Tommy270502/PM4/1_Radar Theorie/1_CW-Doppler-Radar/PM4 FS2026 CW-Doppler-Radar Design V1.0.pptx

PM4 FS2026: CW-Doppler-Radar Sensor

Project Goals
Design a radar sensor
start with a standard use case (see below)
and/or an idea of your own
document your HW/DSP-concept
Realize your prototype
Hardware
Firmware/Software
Test the performance of your prototype
Document and present your prototype

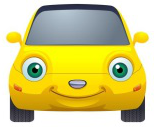
[picture p5: figure]

v
radial
velocity

range R

radar sensor
K-LC5

radar sensor
K-LC5

## Slide 2

References

General information can be simply found on Wikipedia (https://en.wikipedia.org/wiki/Radar):
Distance and Spead Measurement (https://en.wikipedia.org/wiki/Radar#Radar_signal_processing), Radar Range Equation (https://en.wikipedia.org/wiki/Radar#Radar_range_equation), …
Further technical information can be found on the Radar Tutorial (https://www.radartutorial.eu/):
Doppler-Effect (https://www.radartutorial.eu/11.coherent/co06.en.html) (see Figure 1 first)
CW-Doppler-Radar (https://www.radartutorial.eu/02.basics/Continuous%20Wave%20Radar.en.html)
(only sections Doppler Radar, Function, Block diagram of CW radar Figure 3)
Radar Range Equation (https://www.radartutorial.eu/01.basics/The%20Radar%20Range%20Equation.en.html)
Radar-Cross-Section (https://www.radartutorial.eu/01.basics/Radar%20Cross%20Section.en.html)
RFbeam, St. Gallen: https://www.rfbeam.ch/
use cases (https://rfbeam.ch/applications/)
Radar sensor used in PM4:
Radar Sensor K-LC5 (https://rfbeam.ch/product/k-lc5-radar-transceiver/), data sheet K-LC5 (https://rfbeam.ch/wp-content/uploads/dlm_uploads/2022/11/K-LC5_Datasheet.pdf)

## Slide 3

Some use cases

1. CW-Doppler-Radar: motion sensor
- for movement detection
- indoor automation
- intrusion alarm
challenge: human presence detection
2. CW-Doppler-Radar: speed sensor
- traffic monitoring
- sports (challenge: reflectivity of target)
3. FMCW-Radar: range sensor
- please see corresponding document
- range (i.e. distance) measurements
- more challenging than CW-Doppler-Radar

Source: https://rfbeam.ch/applications/

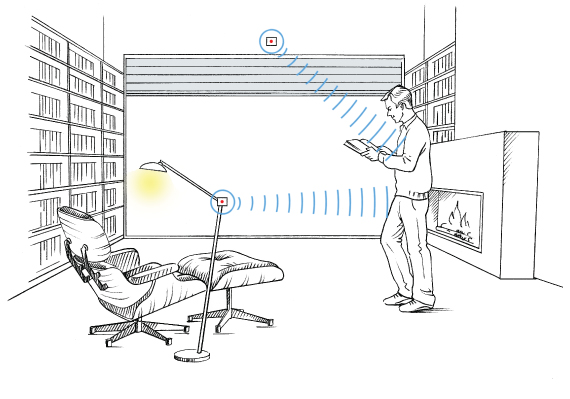
[picture p6: figure]

use case 1

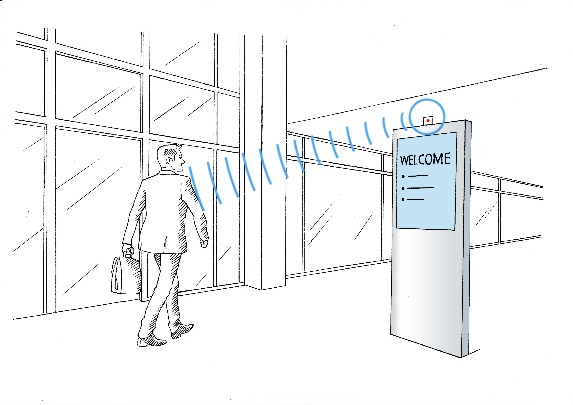
[picture p7: figure]

use case 1

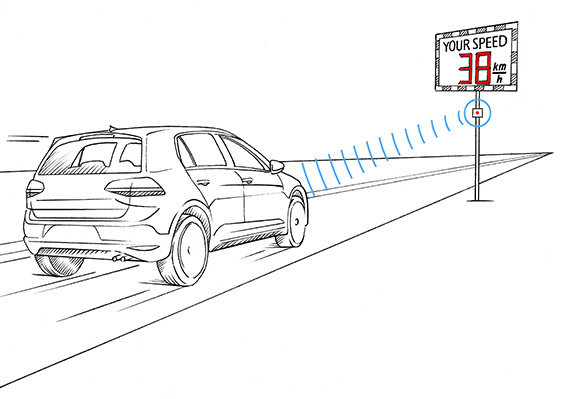
[picture p8: figure]

use case 2

## Slide 4

CW-Doppler-Radar: How it works

CW-Doppler-Radar (https://www.radartutorial.eu/02.basics/Continuous%20Wave%20Radar.en.html)

target

Doppler-Effect (https://www.radartutorial.eu/11.coherent/co06.en.html)
Doppler-frequency
wave length λ
c: speed of light (~ 3·10⁸ m/s)
fc: transmit frequency ( 24 GHz)

f_d =2∙v/λ= 2∙v∙(f_c)/c=2∙v∙ (24 GHz)/(3∙10^8 m/s)=v/(m/s) ∙160 Hz

v / (m/s) | v / (km/h) | fd / Hz
0.1 | 0.36 | 16
0.28 | 1 | 44.4
1 | 3.6 | 160
2.8 | 10 | 444
10 | 36 | 1600
28 | 100 | 4444

f_d =2∙v/λ

v
radial
velocity

λ=c/(f_c)

range R

x(t) = cos(2π·fc·t)

y(t) = A·cos(2π·(fc+fd)·t)

(in-phase signal) I(t) = A·cos(2π·fd·t-φ0)
=> I(t) = y(t)·cos(2π·fc·t) low-pass filtered

cos(2π·fc·t)

(quadrature-phase signal) Q(t) = A·sin(2π·fd·t-φ0)
=> Q(t) = y(t)·(-sin(2π·fc·t)) low-pass filtered

CW-Doppler-Radar: DC to set fc
(should be different to avoid interference between sensors)
FMCW-Radar: sawtooth
(DAC with reconstruction filter)

= fc

VCO: voltage controlled oscillator
LNA: Low Noise Amplifier

## Slide 5

Review of Fourier Theory

Frequency translation

x(t) = y(t) · ej2π^f^c·t ○-● X(f) = Y(f-fc)

multiplication with ej2π^f^c·t ○-● frequency translation with +fc (to the right)

cos(ωc·t) = (e^j·^ω^c·t + e-j·^ω^c·^t) / 2

Euler-formula:
Multiplication of the received signal y(t) with cos(2π·fc·t)
causes a frequency translation by ±fc (see the following spectra)

IY(f)I

fc - fDoppler

target moves away from the radar sensor (v<0)
and causes a negative Doppler frequency

f

-fc

+fc

fDoppler

-fc

fc

+fc

II(f)I

X

X

filtered

f

fc

## Slide 6

Exercise 1

Assume that the target moves towards the radar sensor (v>0)
and, thus, causes a positive Doppler frequency (fd>0)
In the following diagram, sketch the magnitude spectra
- IY(f)I of the reflected radar signal y(t) and
- II(f)I of the analog radar-sensor output signal I(t)

IY(f)I

f

II(f)I

fc

fd

fc

f

Please verify that the sign of the Doppler frequency fd and the velocity v and, hence,
the direction of the movement can not be distinguished if only 1 sensor output signal is used !

## Slide 7

FFT-based Doppler frequency detection

Review of FFT

The FFT transforms N samples in the time-period [0,…,NTs) into
N uniformly distributed (complex) spectral-values in the range [0,…,fs).

Spectrum of analog radar sensor output signal I(t)

II(f)I

X

fs/2

X

filtered

FFT-spectrum of the sampled radar sensor output signal I[n] = I(t=nTs)

fd

fc

f

(fs is the sampling frequency)

Zero-frequency component shifted to
center of spectrum (Matlab: fftshift)

FFT

II[m]I

fd

fs-fd

fftshift

-fd

fd

fs

f

f

fs/2

## Slide 8

Determination of movement direction

Multiplication with e-j2π^f^c·t ○-● frequency translation with -fc (to the left)

Euler: e^-j^φ = cos(φ) - j·sin(φ)

y(t)·e-j2π^f^c·t = y(t)·[ cos(2πfc·t) - j·sin(2πfc·t) ] = I(t) + j·Q(t)

e-j...

complex-valued signal Z(t)

IY(f)I

fc-fd

IZ(f)I

-fd

fc

f

filtered

X

-fc

-fc

fs/2

f

FFT-spectrum of the sampled radar-sensor output signal z[n] = I[n]+j·Q[n]

fc

IZ[m]I

IZ[m]I

FFT

fs-fd

fftshift

-fd

fs

f

fs/2

f

## Slide 9

Exercise 2

Assume that the target moves towards the radar sensor (v>0)
and, thus, causes a positive Doppler frequency (fd>0)
In the following diagram, sketch the magnitude spectra
- IY(f)I of the reflected radar signal y(t) and
- IZ(f)I of the analog radar sensor output signal z(t) = I(t)+j·Q(t)
- IZ[m]I of the sampled radar-sensor output signal z[n] = I[n]+jQ[n]

IY(f)I

f

IZ(f)I

fc

fs/2

fc

f

IZ[m]I

IZ[m]I

FFT

fftshift

fs

f

fs/2

f

## Slide 10

Exercise 3

Use the Matlab-program CW_Doppler_Radar_8kSps_160.m, read
the corresponding wave-file and determine the Doppler-frequency fd and
the resulting radial (Doppler-) velocity v. The result should look like this:

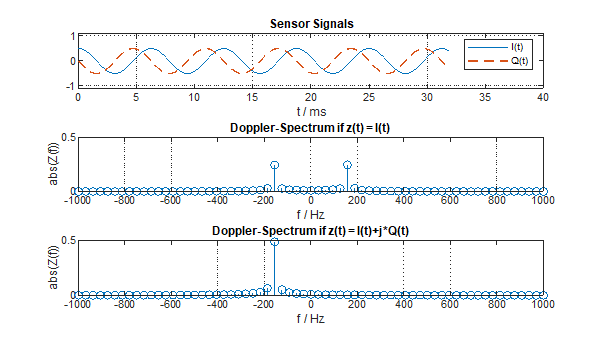
[picture p9: figure]

direction of movement cannot be determined!

fs = 8 kSps
NFFT = 256
TFFT = N∙Ts = 32 ms
Δf = 1/TFFT = fs/N ≈ 31 Hz
detected fd = -156.3 Hz
(instead of -160 Hz)
detected radial velocity
v = -0.98 m/s (away from
the radar, instead -1 m/s)
test also with NFFT = 64

fd is negativ
(movement away from the radar)

## Slide 11

Exercise 4

Use the Matlab-program CW_Doppler_Radar_4kSps_waveByhand.m read
the corresponding wave-file and determine the resulting Doppler-velocity-profile
v(t). The result should look like this:

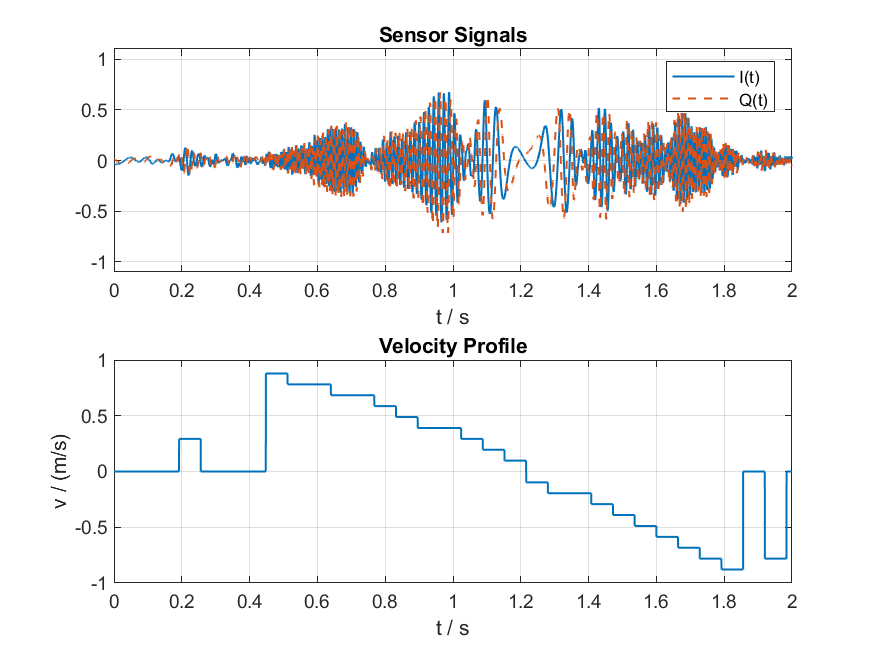
[picture p10: figure]

fs = 4 kSps
NFFT = 256
TFFT = N∙Ts = 64 ms
Δf = 1/TFFT = fs/N ≈ 15.6 Hz

the hand was moved first towards the
sensor and then away from the sensor

signal level below threshold

## Slide 12

DSP-Design-Scenario

Speed sensor: moving car, max. range 40-60 m (see below)
vmax = 80 km/h
Doppler frequency fd = ± 3556 Hz
sampling frequency fs = 8 kSps is larger than 2∙IfdI
block length N = 256
measurement time TFFT = N∙Ts = 32 ms (car moves < 0.7m during this time)
FFT frequency resolution Δf = 1/ TFFT ≈ 31 Hz (corresponds to 0.7 km/h)
accuracy of the speed indication is ±0.35 km/h

## Slide 13

Link Budget

K-LC5 data (https://rfbeam.ch/wp-content/uploads/dlm_uploads/2022/11/K-LC5_Datasheet.pdf)sheet (https://rfbeam.ch/wp-content/uploads/dlm_uploads/2022/11/K-LC5_Datasheet.pdf)

Effective Isotropic Radiated Power
EIRP = 12 dBm

Round-trip loss S ≤ 117 dB = 12 - (-105)
(Datasheet: overall sensitivity = -118 dBc)

Radar Cross (https://www.radartutorial.eu/01.basics/Radar%20Cross%20Section.en.html)Section (https://www.radartutorial.eu/01.basics/Radar%20Cross%20Section.en.html)
(σ ≈ 1 m² for moving person
σ ≈ 50 m² for moving car)

Gantenna = 8 dB

4 dBm

Range R

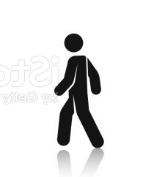
[picture p11: figure]

GLNA = 10 dB

Radar Range (https://www.radartutorial.eu/01.basics/The%20Radar%20Range%20Equation.en.html)Equation (https://www.radartutorial.eu/01.basics/The%20Radar%20Range%20Equation.en.html) @ 24 GHz
R = 0.0167 · 10S/40 · σ⁰.²⁵
(S in dB and σ in m²)

Sensitivity
PRx ≥ -105 dBm (B=1kHz, S/N=6dB,...)

Pout
≥ -87 dBm

Gantenna = 8 dB

Exercise 5: Compute the maximum (detection) range R of the CW-Doppler-Radar
- for a moving person:
- for a moving car:

## Slide 14

Detection Range

K-LC5 data sheet (https://rfbeam.ch/wp-content/uploads/dlm_uploads/2022/11/K-LC5_Datasheet.pdf)

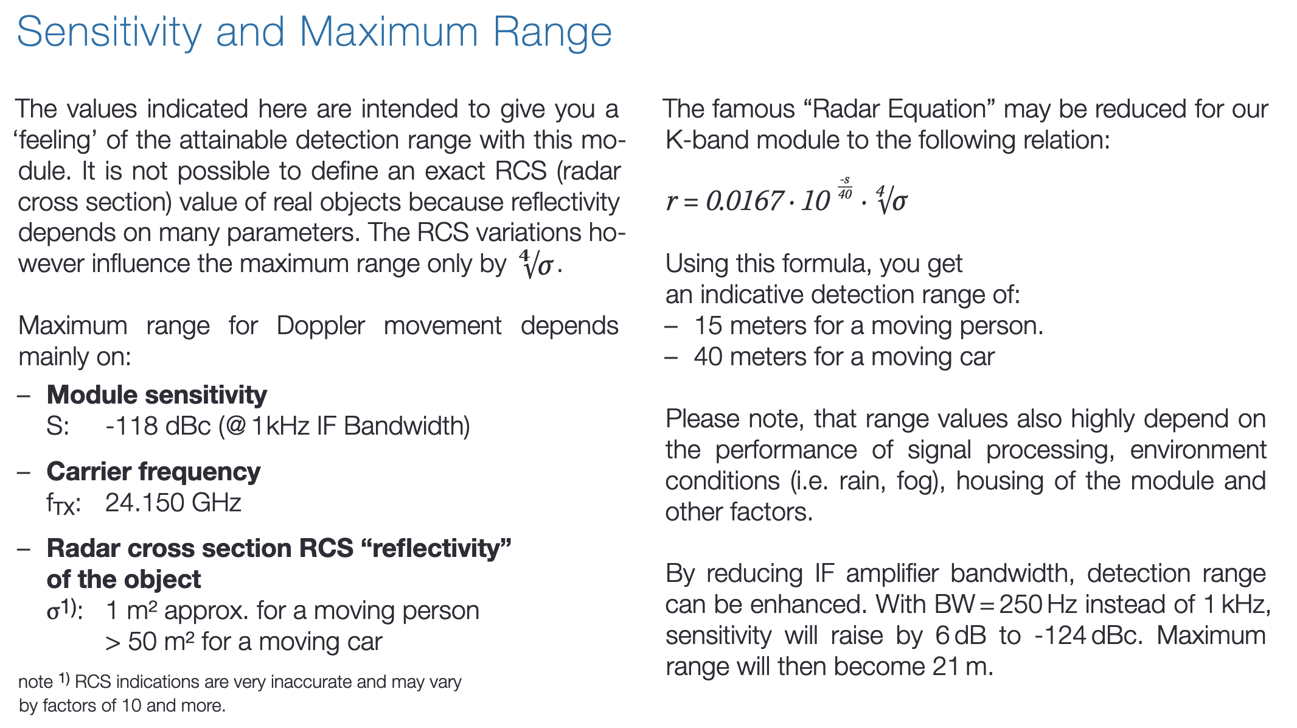
[picture p12: figure]

RCS (https://www.radartutorial.eu/01.basics/Radar%20Cross%20Section.en.html)

## Slide 15

Gain of external amplifier

Parameter | Value | Remarks
Sensitivity K-LC5 | -105 dBm | e.g. moving person @ a range of 14 m
receiver gain | 18 dB | see data sheet K-LC5
min. Pout | -87 dBm | @ R = 1 kΩ output of LNA

- Pout in mW: 10·log10(Pout/1mW) ≥ -87 dBm => Pout ≥ 10⁻⁸.⁷ mW
- Vout, rms in V: √(R*Pout) => Vout, rms ≥ 10-8.7/2 V = 45 μV => Vout ≥ 64 μV
- But: the 12 Bit ADC has a dynamic range ≈ 3V, i.e. an LSB of 732 μV!
- therefore, an external gain amplifier is required: VADC = Vout·Gamp
- with Gamp = 60 dB, i.e. Gamp = 1000: VADC ≥ 64 mV, i.e. at least 6 LSBs
- AC-coupling is required for such a (high) gain, but the high-pass-filter removes the low frequencies and, thus, the small v-values. There is a minimal detectable speed vmin > 0

## Slide 16

Gain of external amplifier

Assumption:
a moving person is in short distance (3m) directly in front of the sensor
Exercise 6:
Fill out the column «values» of the following table and verify, that
a «large» received signal does not over-drive the ADC (no clipping).

Parameter | Values | Remarks
EIRP | 12 dBm | effective isotropic radiated power
Round-trip-loss | dB | see slide 13, R = 3 m, RCS = 1 m²
received power PRx | dBm | see slide 13
receiver gain | dB | see slide 13
max. Pout | dBm | @ R = 1 kΩ output of LNA
max. Pout | mW | @ R = 1 kΩ output of LNA
max. Vout | mV | @ output of radar sensor
max. VADC | V | 60 dB external gain

## Slide 17

Radar-Sensor

Radar Sensor K-LC5 (https://rfbeam.ch/product/k-lc5-radar-transceiver/)
data (https://rfbeam.ch/wp-content/uploads/dlm_uploads/2022/11/K-LC5_Datasheet.pdf) (https://rfbeam.ch/wp-content/uploads/dlm_uploads/2022/11/K-LC5_Datasheet.pdf)sheet (https://rfbeam.ch/wp-content/uploads/dlm_uploads/2022/11/K-LC5_Datasheet.pdf) K-LC5 (https://rfbeam.ch/wp-content/uploads/dlm_uploads/2022/11/K-LC5_Datasheet.pdf)

Field-Of-View: 80°x34°

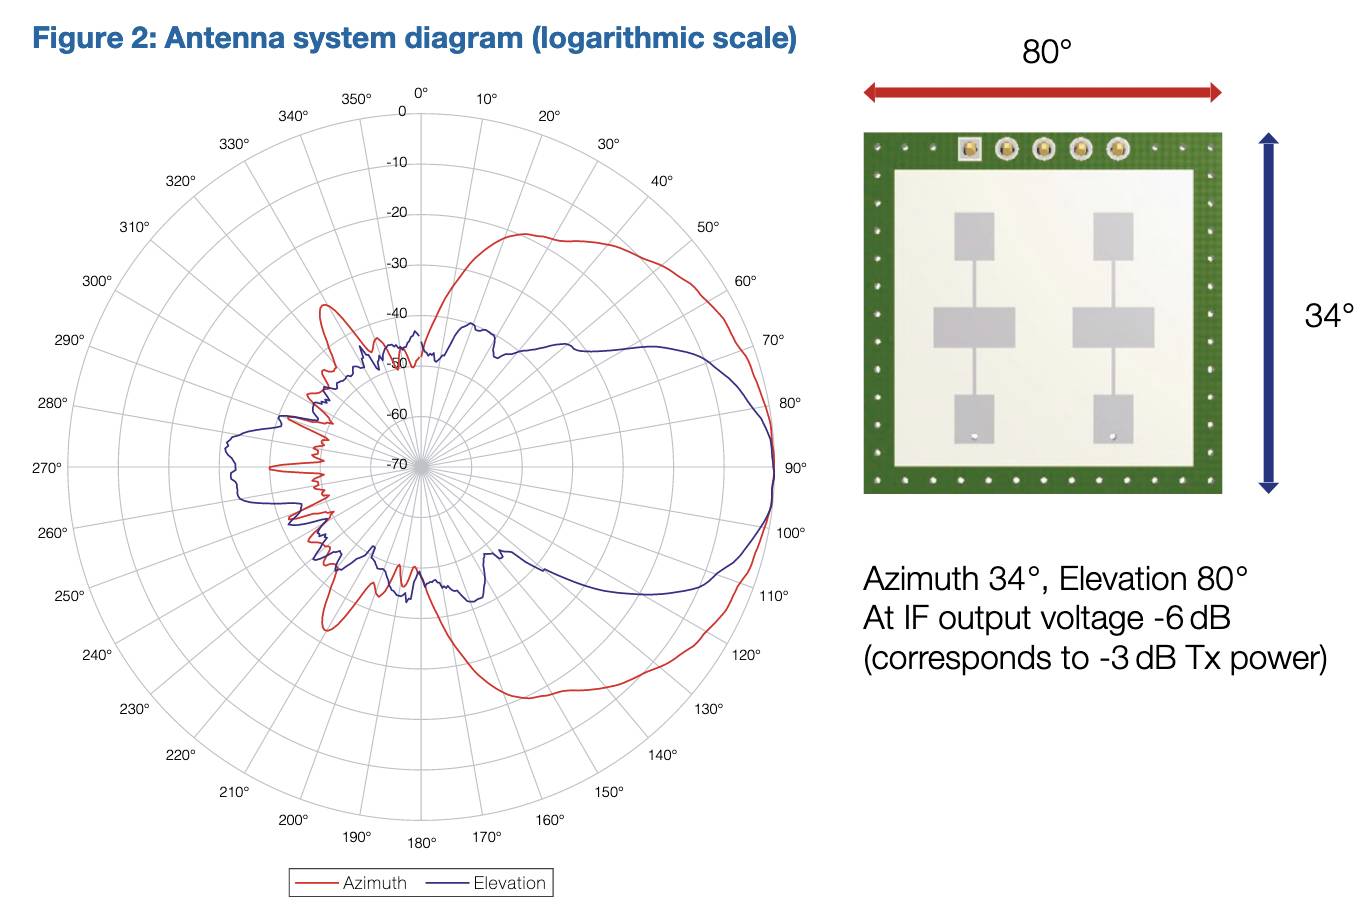
[picture p13: figure]

16.8 m (@ r=10m)

6 m

K-LC5

Overall S = 118 dBc (B=1kHz, S/N=6dB, ...)
Rmax moving person ≈ 15 m
Sensitivity: -105 dBm (B=1kHz, S/N=6dB,...)
Rx gain: 18 dB
FMCW supported
3.3V version ordered
(Digikey, K-LC5-RFB-00C, CHF 25.-/pcs)

## Slide 18

CW-Doppler-Radar: Hardware

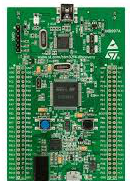
[picture p14: figure]

MCU board

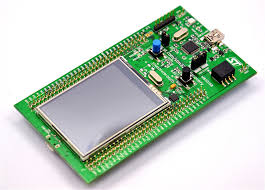
[picture p15: figure]

STM32F4-Discovery-Board

radar sensor K-LC5
3.3V power supply
amplifier (60 dB)
for I- and Q-output
highpass,
VCO in (DAC)
test points
LED?, switch?, buzzer?
filter analog 5V power supply
USB power supply

a PCB-template is available

Option: 3D-printed lens for focussing

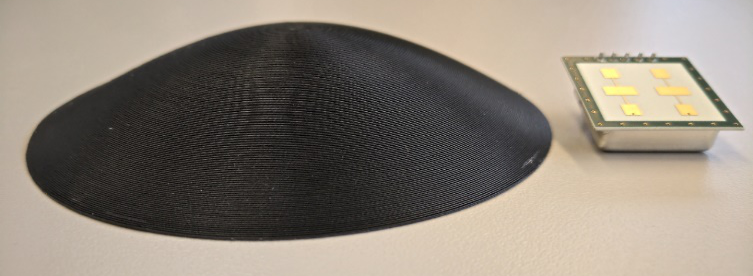
[picture p16: figure]

Sensor board

## Slide 19

Subsystem Test Scenarios

1. Sensor-Board without radar sensor K-LC5 and without MCU-board
- Function Generator (sin, 100 Hz…4 kHz, 50 μV…1 mV) at I-/Q-connector pins
- validate the external amplifier outputs with the oscilloscope (in front of ADC)
- check also the magnitude frequency response
2. Sensor-Board with radar sensor K-LC5 and without MCU-board
- put the Radar Doppler Target K-DT1 in front of the radar sensor
- validate the external amplifier outputs with the oscilloscope (in front of ADC)
3. MCU-Board with FFT-firmware and without radar sensor board
- FuGe (sin, 100 Hz…4 kHz, 50 mV…1V, 1.5V DC-offset) at ADC inputs
- show and validate frequency on the display

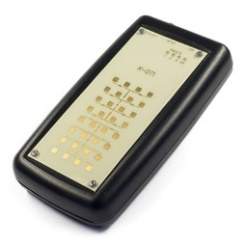
[picture p17: figure]
