Tommy270502/PM4/6_Video Presentation/PM4_VideoPresentation.pptx

## Contactless Radar-Based Heart Rate Monitoring Device

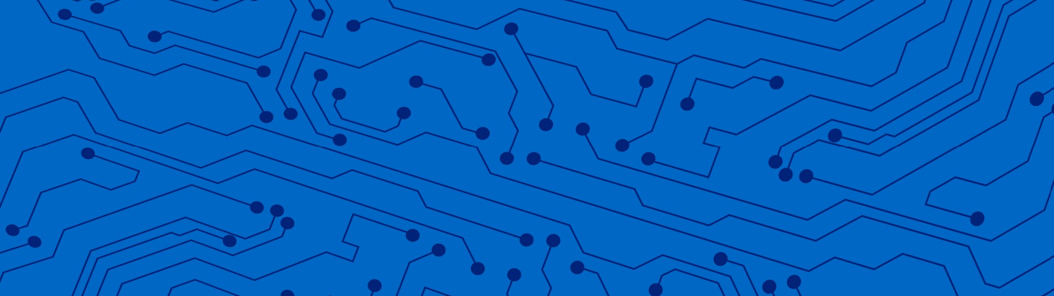
[picture p40: figure]

- School of Engineering

ZHAW PM4 Electronics Project
16.05.2026 | B. Grebnevs, T. Perri

## Heart rate. Still contact-based

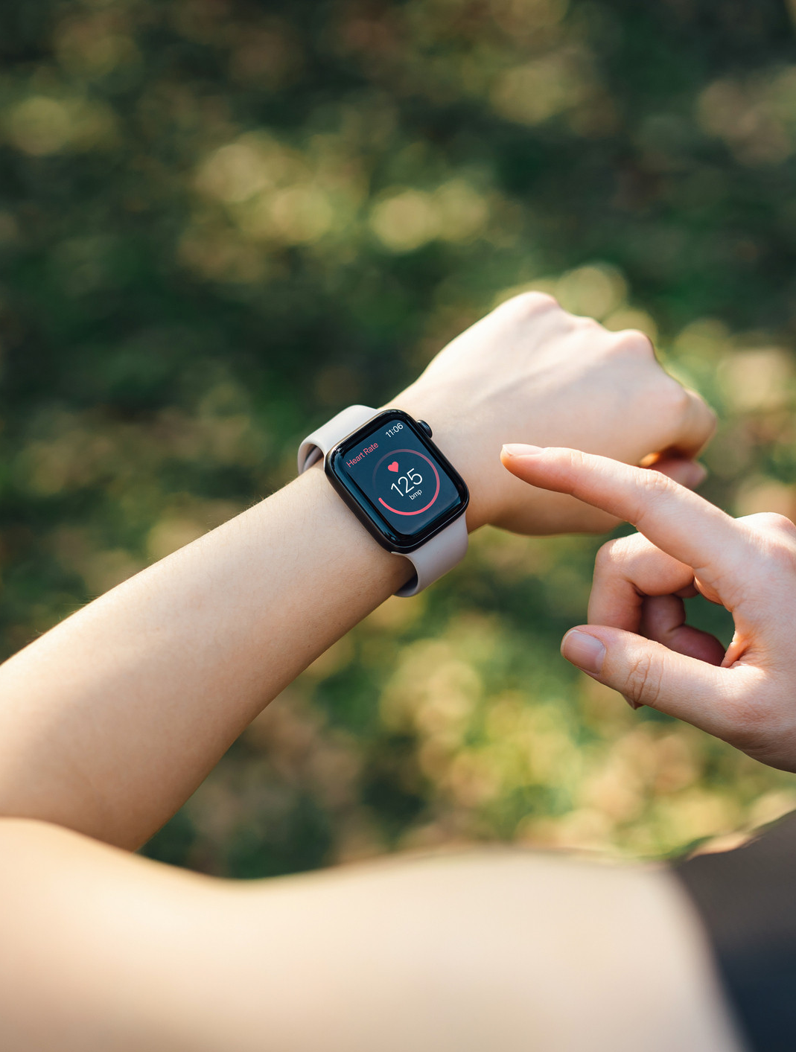
[picture p41: figure]
How to lower your resting heart rate - Harvard Health
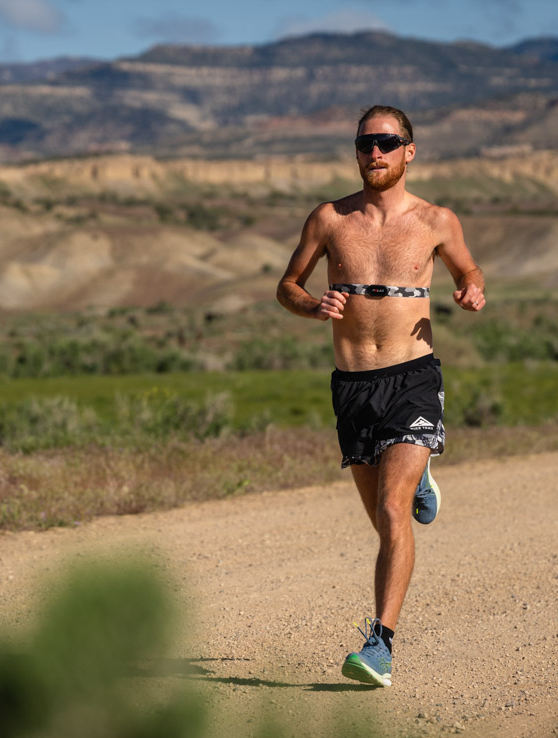
[picture p42: figure]
Best Heart Rate Monitors for Running of 2024 - iRunFar
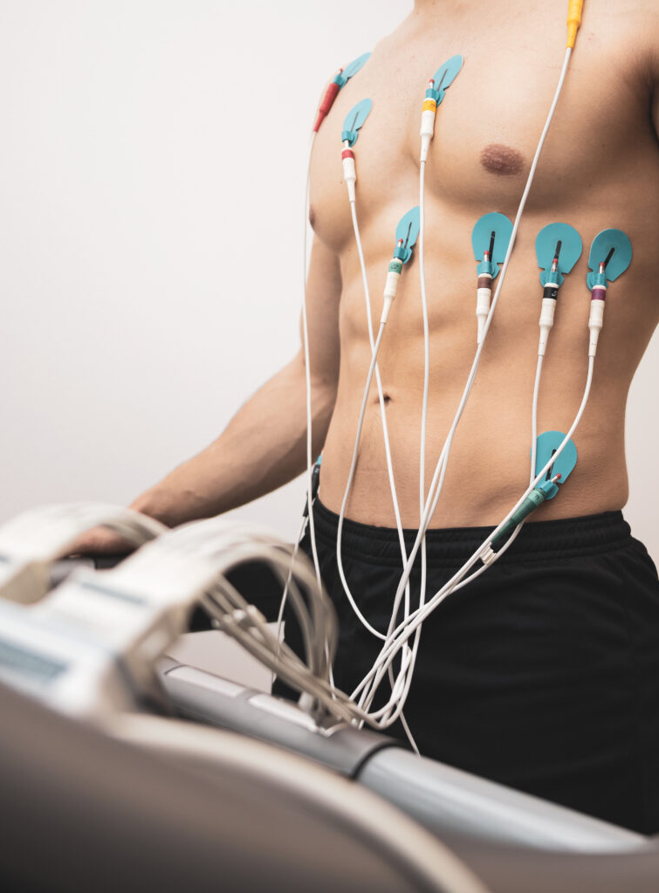
[picture p43: figure]
ECG Test: What It Reveals About Your Heart - Blanket Health - Broward ...

2

## Heart rate. Still contact-based

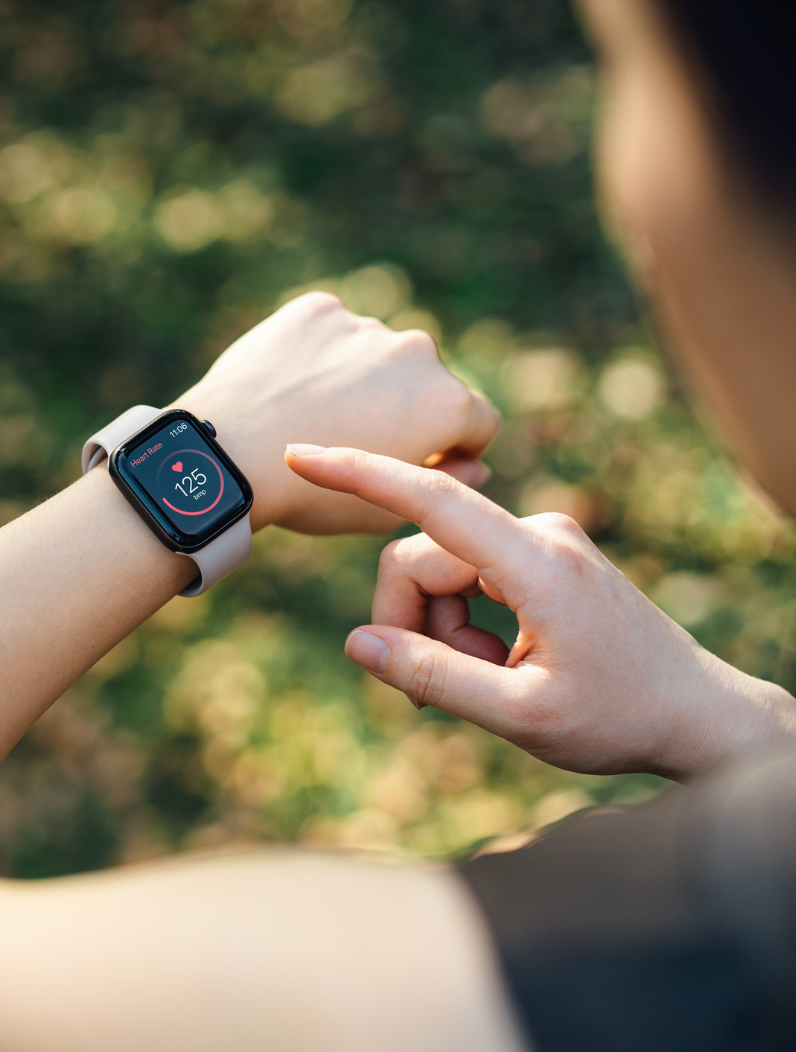
[picture p45: figure]
How to lower your resting heart rate - Harvard Health
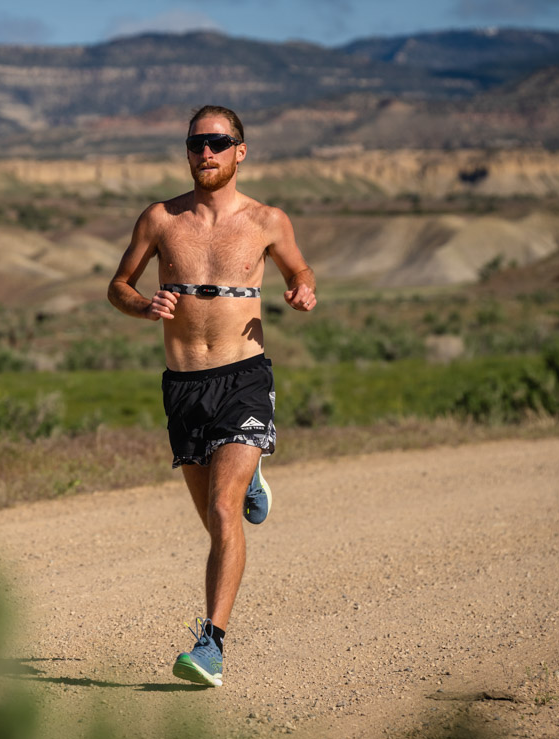
[picture p46: figure]
Best Heart Rate Monitors for Running of 2024 - iRunFar
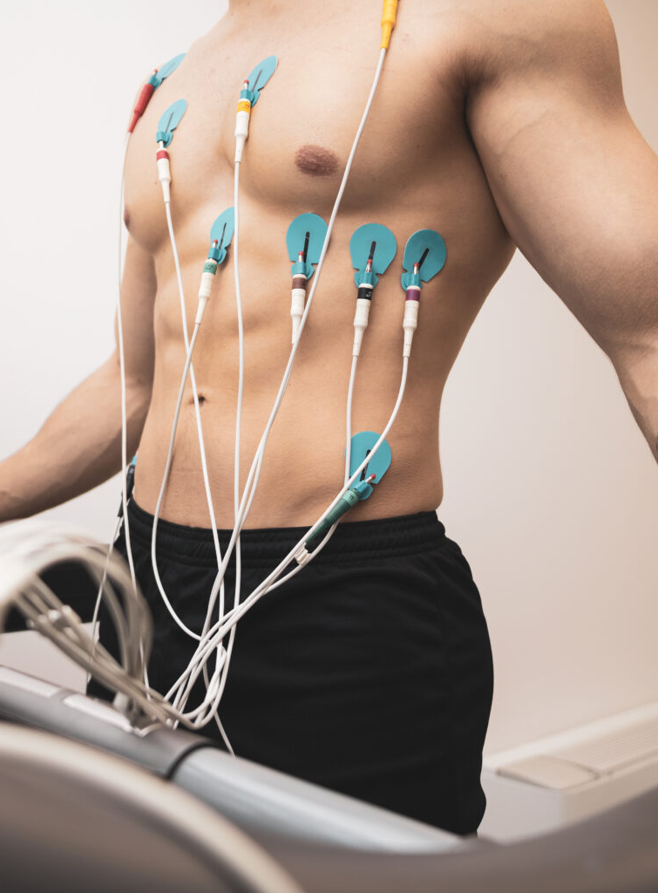
[picture p47: figure]
ECG Test: What It Reveals About Your Heart - Blanket Health - Broward ...

2

## Slide 4

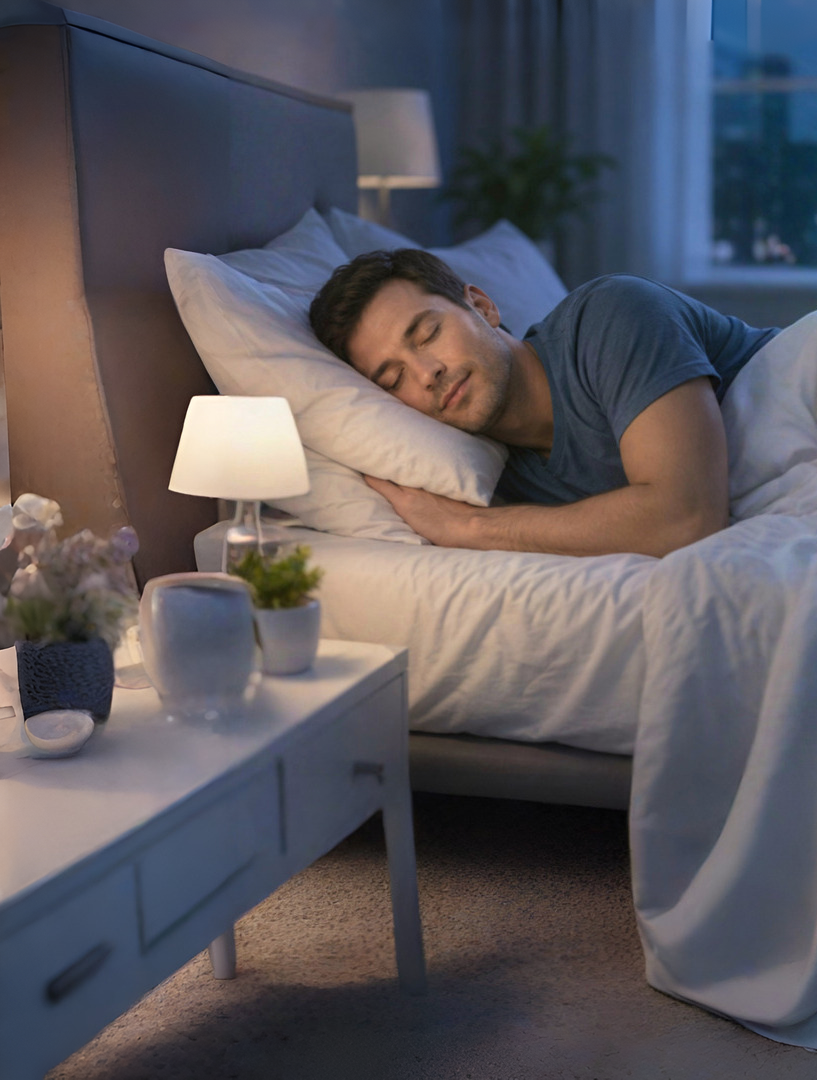
[picture p48: figure]
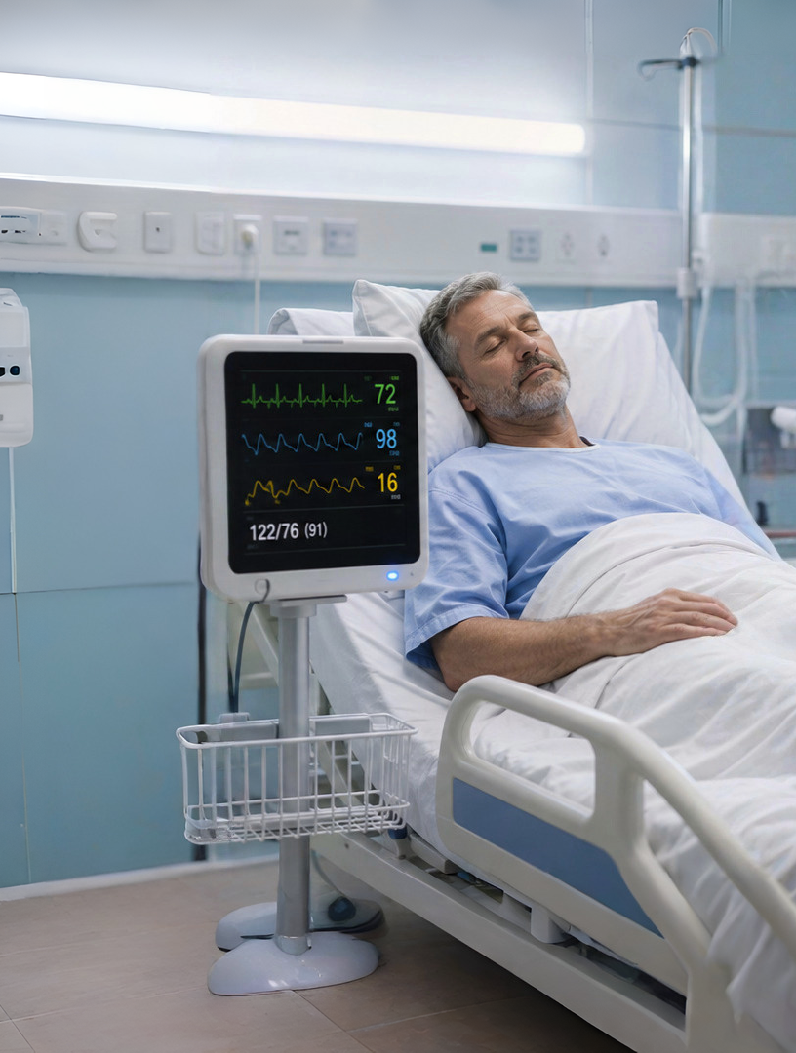
[picture p49: figure]
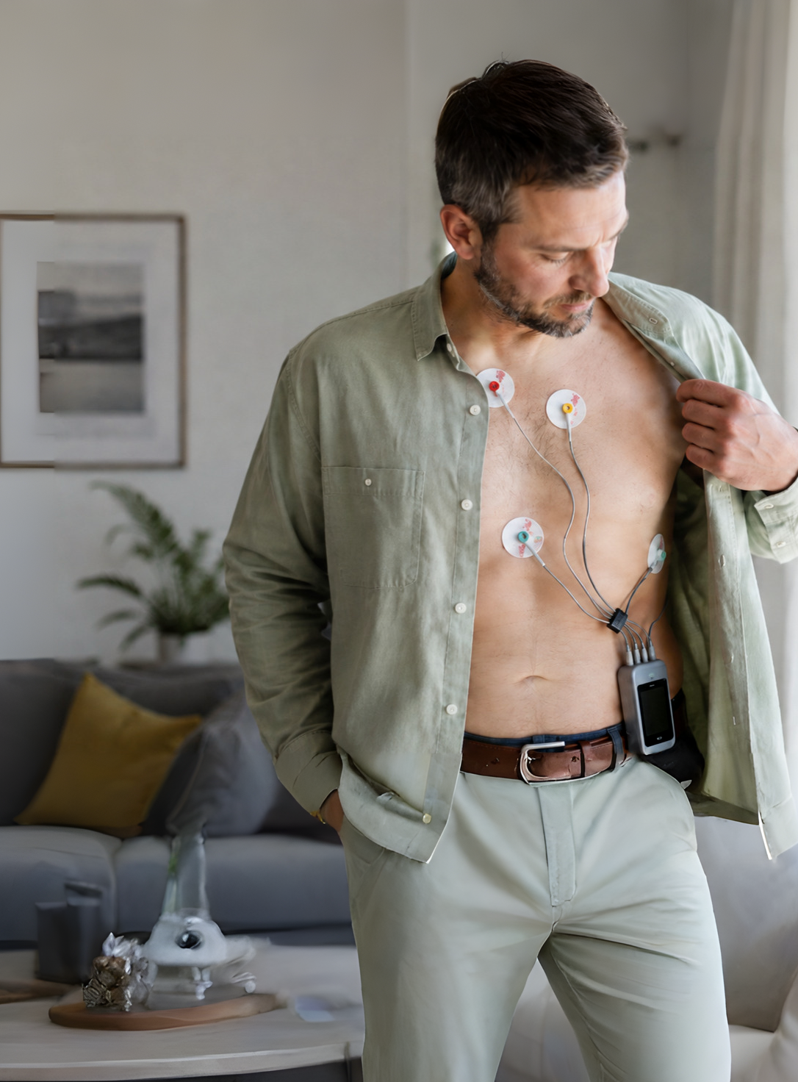
[picture p50: figure]

3

## Slide 5

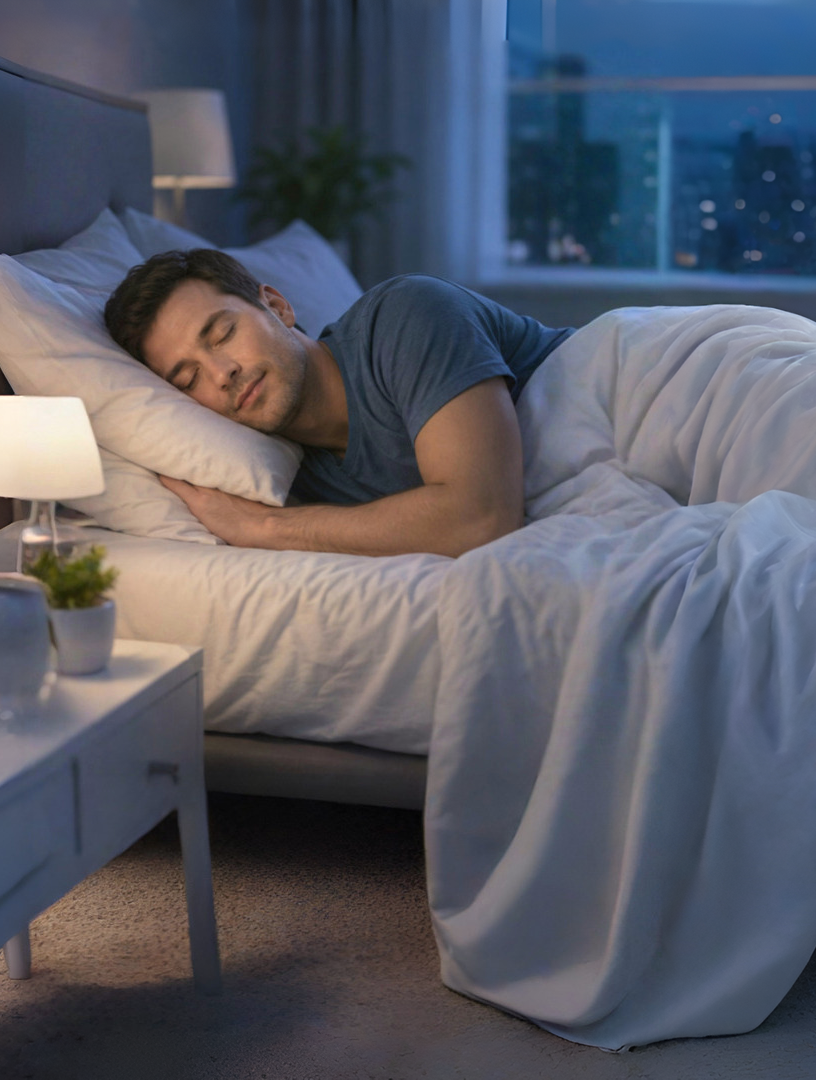
[picture p51: figure]
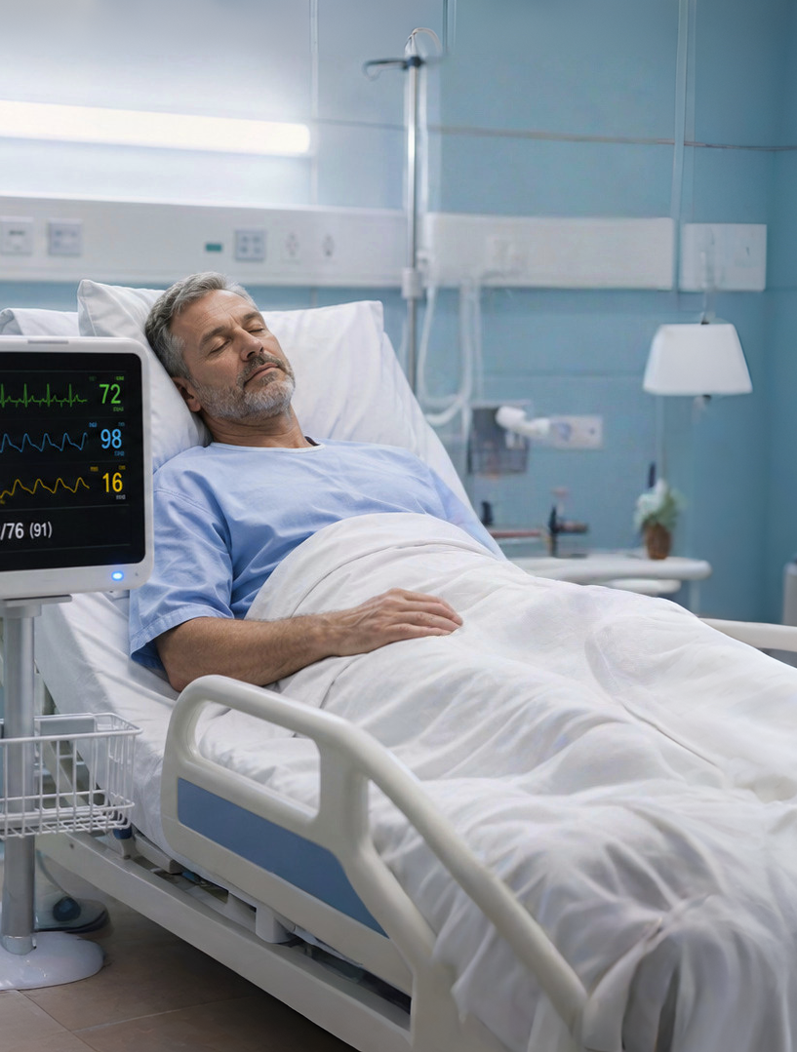
[picture p52: figure]
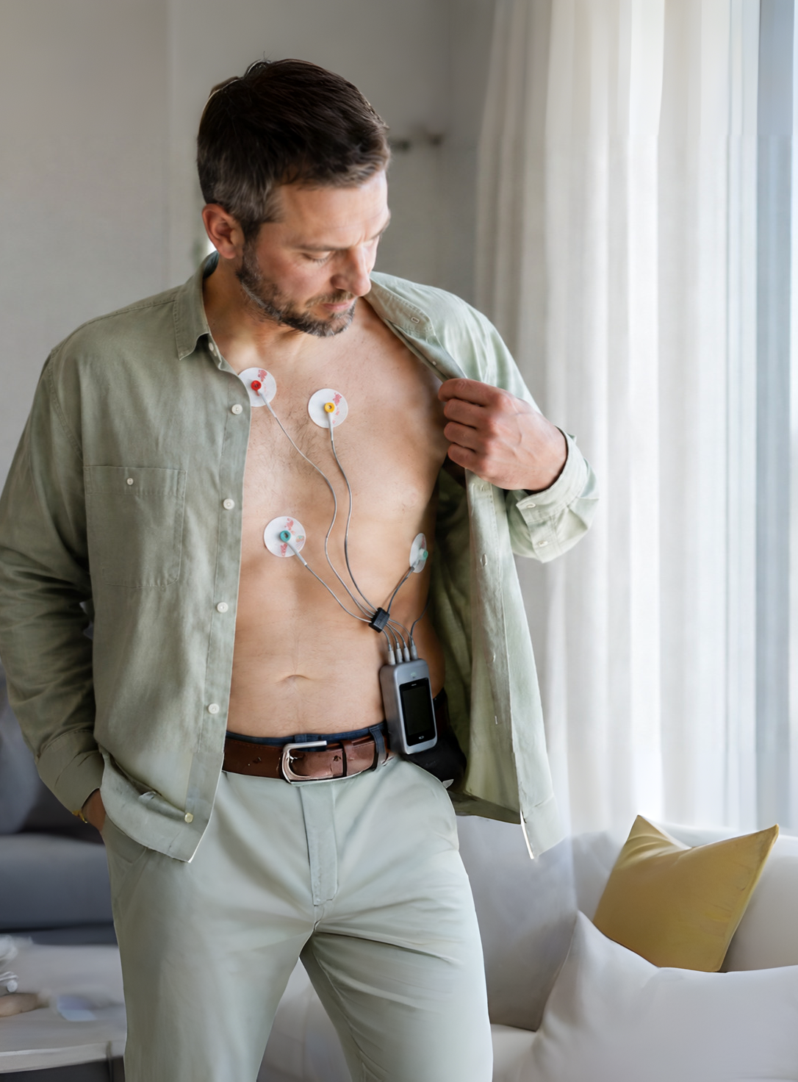
[picture p53: figure]

The ideal measurement is
- comfortable
- continuous
- contact-free

3

## Product reveal

## Slide 7

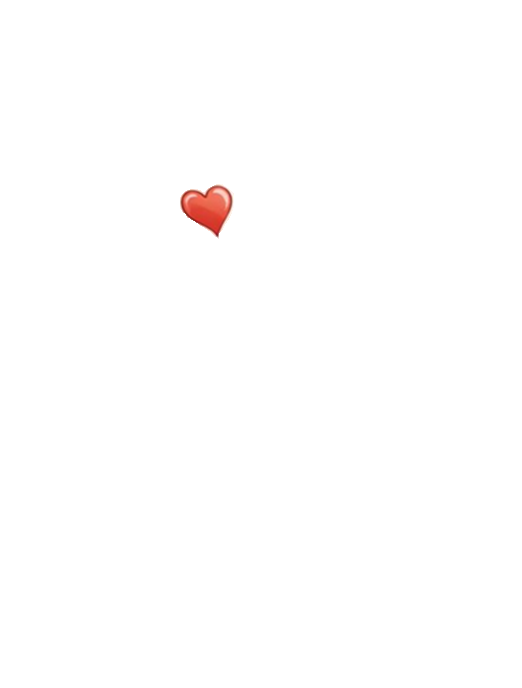
[picture p54: figure]
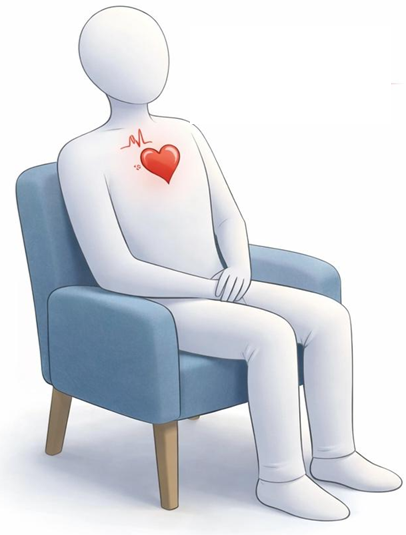
[picture p55: figure]
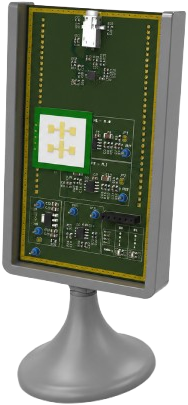
[picture p56: figure]

Chest movements

Radar module

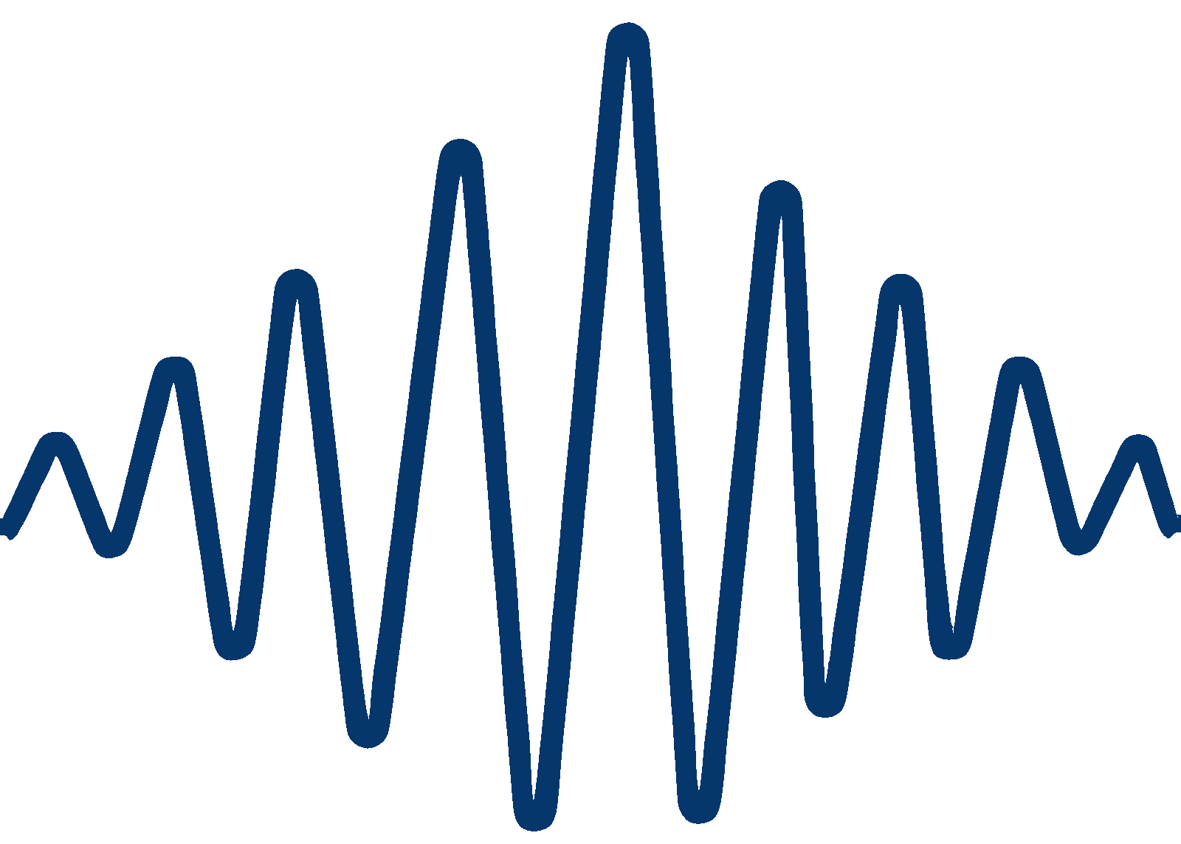
[picture p57: figure]

Radar signal

Reflected signal

5

## Slide 8

System Architecture

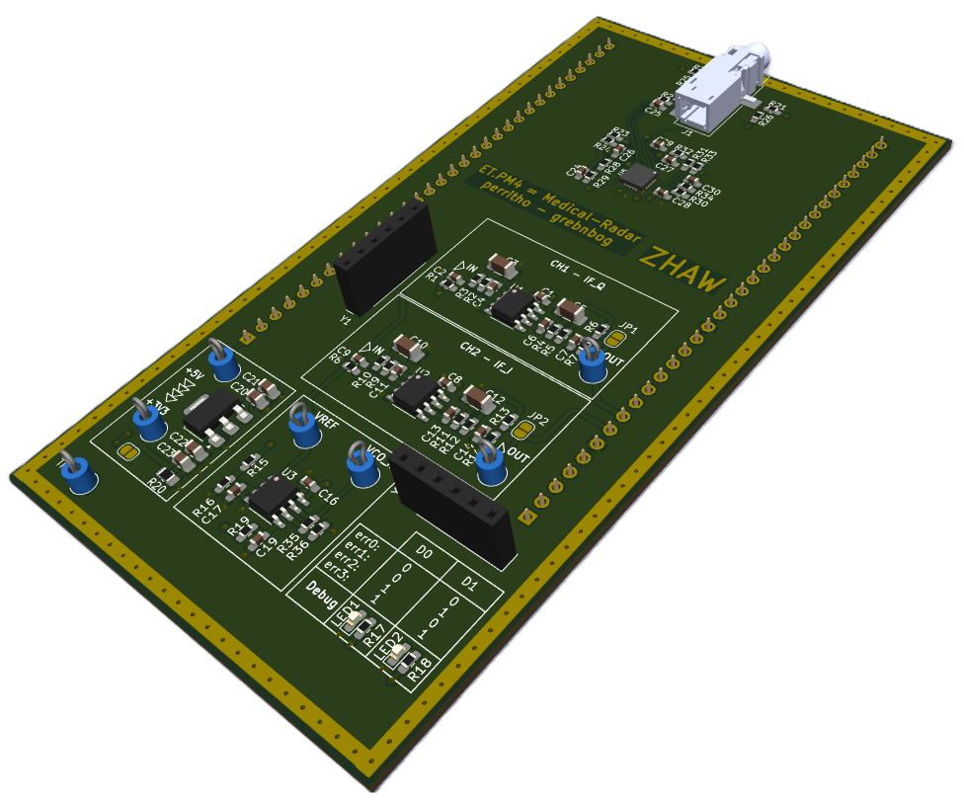
[picture p58: figure]
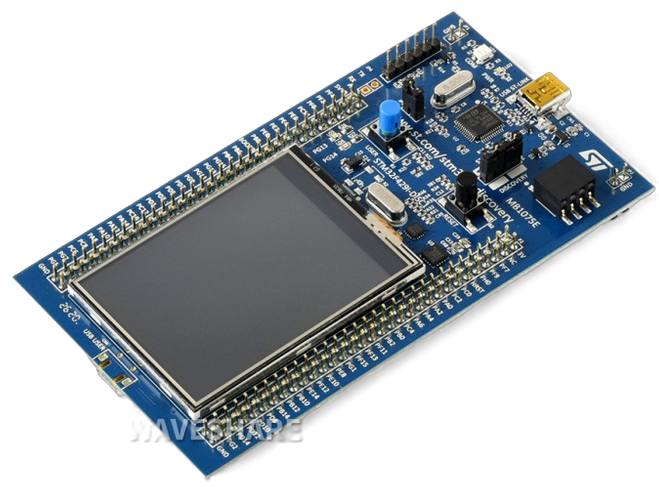
[picture p59: figure]
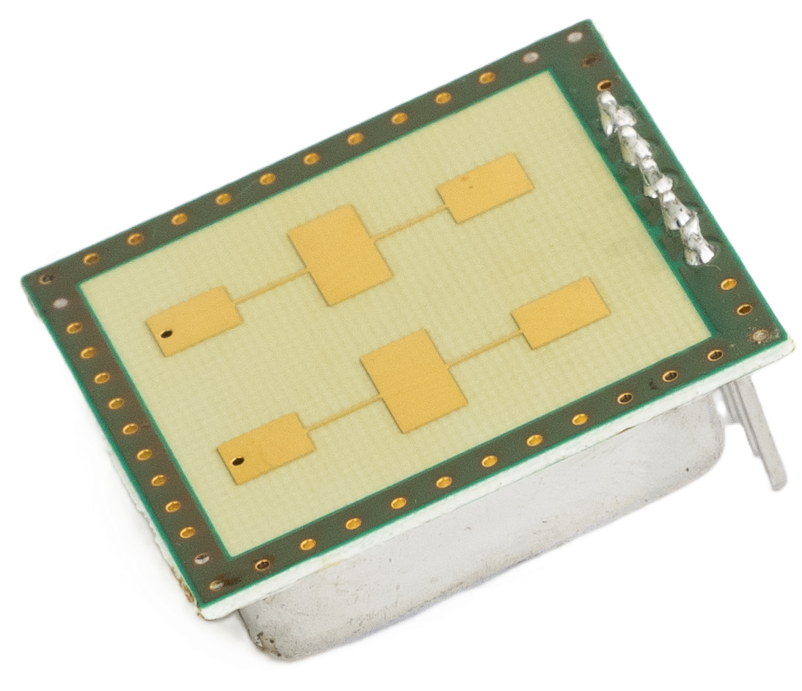
[picture p60: figure]

K-LC5 Radar

I/Q radar channels

Analog front-end

ADC

STM32 + LCD Display

6

## Standalone operation, OpenLog

## Slide 10

Sampling and analysis timing

100 Hz

sampling

512

samples/channel

5.12 s

window length

2.56 s

update interval

50% overlap

New result every 2.56 seconds while using 5.12 seconds of signal data

8

Notes: The radar signals are sampled at 100 hertz. Each analysis window contains 512 samples per channel, equal to 5.12 seconds of data, with updates every 2.56 seconds using 50 percent overlap.

## Slide 11

Signal processing and visualization

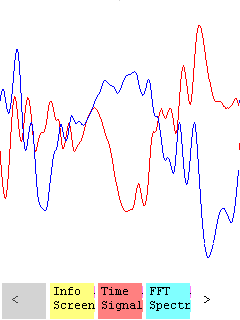
[picture p61: figure]

Time Signal

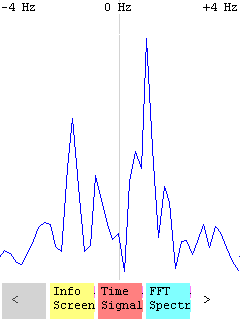
[picture p62: figure]

Frequency Spectrum

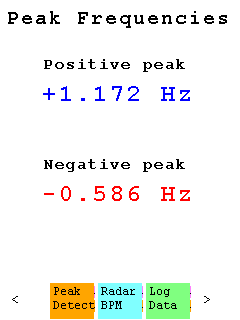
[picture p63: figure]

Dominant Peaks

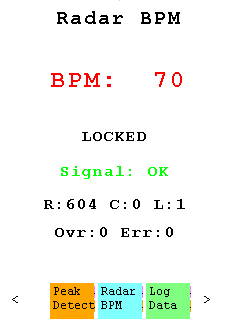
[picture p64: figure]

BPM
Value

FFT

Peak
Detection

HR Calculation

9

## ECG

## Slide 11 (not needed?)

## Slide 14

Accuracy

≈ 1 bpm

interpolated resolution

0.195 Hz

bin spacing

11.7 bpm

raw bin resolution

± 5 bpm

practical accuracy

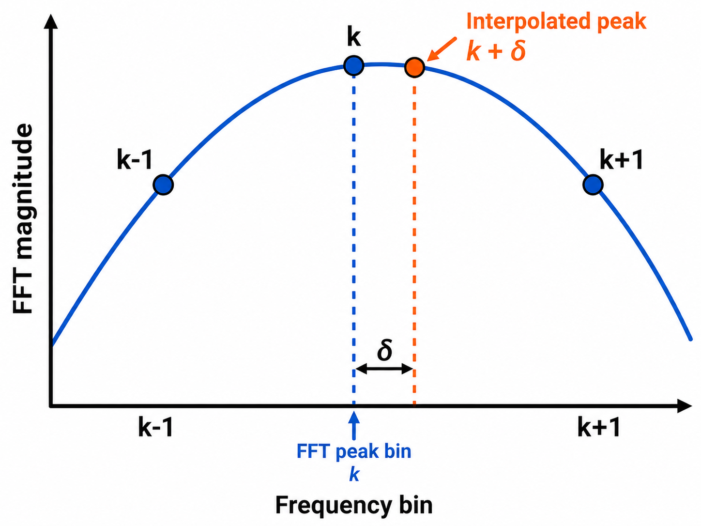
[picture p65: figure]

Sub-bin interpolation

New result every 2.56 seconds while using 5.12 seconds of signal data

12

Notes: The radar signals are sampled at 100 hertz. Each analysis window contains 512 samples per channel, equal to 5.12 seconds of data, with updates every 2.56 seconds using 50 percent overlap.
