Tommy270502/PM4/1_Radar Theorie/2_Option_Dielectric_Lens/PM4_Option_Dielectric_Lens_Antenna_V1.2.pptx

Option Dielectric Lens Antenna

broad radar-beam
short range

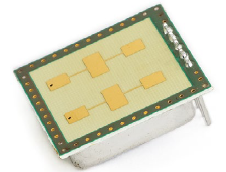
[picture p76: figure]

24 GHz

Range

24 GHz

small radar-beam
long range

dielectric lens (3D printed)
design with ordinary formulas from optics
R.J. Friel et al., ”3D Printed Radar Lenses with Anti-Reflective Structures”, MDPI, 2019.

## Slide 2

Speed of Light and Refractive Index

Speed of electro-magnetic waves (speed of light) in vacuum
c=1/(√(ε_0 ∙μ_0))
Speed of electro-magnetic waves in a medium
v=1/(√(ε_0 ∙ε_r ∙μ_0 ∙μ_r))
In a medium ( ε_r >1 and μ_r ≥1 ) the speed is lower
Definition of Refractive Index
n=c/v=1/(√(ε_r ∙μ_r))
This is well known and applied in optics
Snell’s law n_1 ∙sinθ_1 =n_2 ∙sinθ_2 is used for optical systems
Radar signals are electro-magnetic waves
Lenses of material with ε_r >1 can be used for focusing
Sources of the images: https (https://en.wikipedia.org/wiki/Focal_length)://en.wikipedia.org/wiki/Focal_length and https://en.wikipedia.org/wiki/Refractive_index

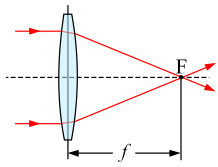
[picture p77: figure]
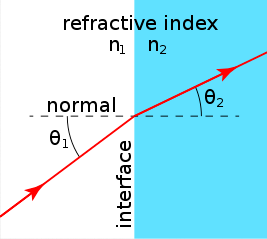
[picture p78: figure]
