Tommy270502/PM4/1_Radar Theorie/3_Option_FMCW/PM4_Option_FMCW_Radar_V1.4.pptx

Option FMCW-Radar

- Classical RADARs are based on pulse-echo-technique
- distance determination by Time-of-Flight (ToF) measurement
- see https://de.wikipedia.org/wiki/Radar => „Impulsradar“ => animation
- Disadvantages of pulse-echo-RADARs
- long radio range requires high power (short) Tx-pulses
- high range resolution requires very short-time pulses
- One solution: FMCW-RADAR

Tobias Otto, „Principles of FMCW Radars“, TU Delft,
see http://de.slideshare.net/tobiasotto/principle-of-fmcw-radars.
- slides 1-7: principle of FMCW radar
- slide 15: block diagram of an FMCW radar
- slide 12: FMCW radar signal processing

## Slide 2

FMCW-Radar: how it works

range R=?

Time-of-Flight
tToF = 2∙R/c

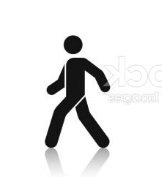
[picture p79: figure]

dynamic or
static target

f

Slope of frequency ramp
s = Bsweep/Tsweep

fbeat = s·tToF

modulation

Bsweep e.g. 260 MHz

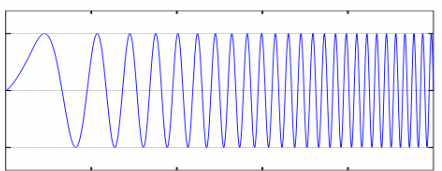
[picture p80: figure]

tToF

t

Tsweep e.g. 1 ms

Trep

Tsweep = NFFT·Ts

detection of fbeat or tTOF or range R

## Slide 3

FMCW-Radar Parameters

- FMCW-Radar: frequency-difference fbeat ~ range R
  - Exercise: find fbeat = …………………………………………………
  - CW-Radar: frequency-difference fd ~ Doppler-velocity
- Rx-signal is multiplied with Tx-signal inside sensor
  - frequency-difference appears at the sensor-outputs e.g: I(t) = A·cos(2π·fbeat·t-φ0)
  - detection of frequency difference fbeat with FFT of length NFFT
- Range-resolution ∆R = c / (2∙Bsweep)
  - e.g: Bsweep = 260 MHz => ∆R = 0.6 m
  - Independent of ramp slope S and FFT-length NFFT

## Slide 4

FMCW-Radar Parameters

c = 299 792 458 m/s (speed of light)
Bsweep = 260 MHz (Bsweep is typically given)
Tsweep = 1 ms (choice)
Slope s = Bsweep / Tsweep = 260 MHz / 1 ms (indirect choice by Tsweep)
fs = 64kHz (choice)
Range R=(f_(beat) ⋅c⋅T_(sweep))/(2 B_(sweep))=(f_(beat) ⋅c)/(2 s) « / 2» since it is an echo and the measurement path has been travelled twice.

Frequency resolution Δf_(beat) =(f_s)/(N_(FFT))=1/(T_(sweep)) = 1kHz (= FFT resolution if Ts ∙ NFFT = Tsweep)

Range resolution: ΔR=(Δf_(beat) ⋅c⋅T_(sweep))/(2⋅B_(sweep))=c/(2 B_(sweep)) = 0.58m

Max. Range:
→ Rmax can be adjusted by adjusting Tsweep or fs
If Ts ∙ NFFT = Tsweep → Rmax = (f_s ⋅c⋅T_s ∙N_(FFT))/(4 B_(sweep)) = (c ∙N_(FFT))/(4 B_(sweep))

R_(max) =(f_(beat max) ⋅c)/(2 s)=((f_s)/2⋅c)/(2 s)=(f_s ⋅c)/(4 s)=(f_s ⋅c⋅T_(sweep))/(4 B_(sweep))=18.4m

## Slide 5

Additional FMCW-HW-Requirements

- DAC generates sawtooth-signal for VCO-input
  - Anti-Imaging-filter: RC-TP 1. order (fg = 10 kHz) is sufficient
  - VCO-Input voltage range: 0 bis 3.3 V
  - VCO-Input impedance 20 kΩ
- Sampling of sensor signal I(t) (and maybe Q(t))
  - Support of fs up to 100 kHz
  - Bandwidth of analog Gain-Amplifier up to 50 kHz Gain-Bandwidth-Product of PM4-OpAmp is 2 MHz => 2 amplifier stages are required!
- start of f-ramp and FFT-block must be «synchronized»
