Tommy270502/PM4/1_Radar Theorie/4_Option_Micro_Doppler/PM4_Option_Micro_Doppler_V1.1.pptx

Option Micro-Doppler-Evaluation

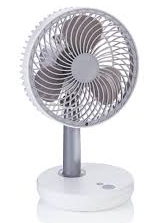
[picture p81: figure]

Meaning of «Micro-Doppler»
(https://www.mathworks.com/help/phased/ug/introduction-to-micro-doppler-effects.html)
A moving target introduces a frequency shift in the radar return due to Doppler effect.
However, because most targets are not rigid bodies, there are often other vibrations
and rotations in different parts of the target in addition to the platform movement. For
example, when a helicopter flies, its blades rotate, or when a person walks, their arms
swing naturally. These micro scale movements produce additional Doppler shifts,
referred to as micro-Doppler effects, which are useful in identifying target features.

Some questions in CW-Radar signal processing
Can the steps of a person be detected in the radar signal?
Is a human / non-human presence detector realizable?
How fast rotate the blades of a fan / drone / …?

## Slide 2

Setup for Micro-Doppler Evaluation

- sampling (audio) signals with fs = 48 kSps (or 44.1 kSps)
- resampling to 4, 6, 8, 9.6, 12 or 16 kSps according need
- record to wav-file & offline-computation of «spectrogram»
- alternatively, online-computation (live-mode)
- option: synch with video sequence

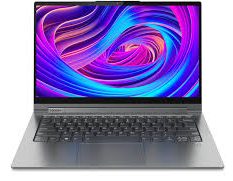
[picture p82: figure]

Notebook (or Smartphone)

Matlab (or Python)

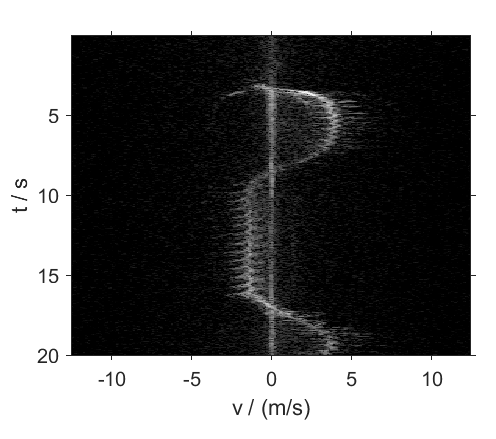
[picture p83: figure]

ASIO driver

USB

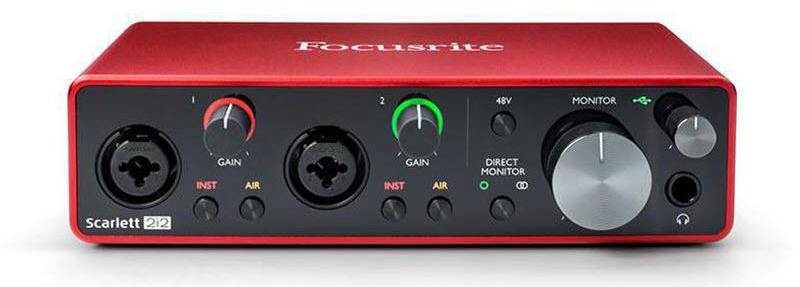
[picture p84: figure]

Sensor-Board
(without MCU-Board)

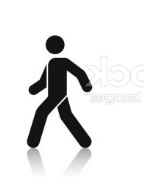
[picture p85: figure]

Q(t)

Instruments-Inputs (not XLR!)

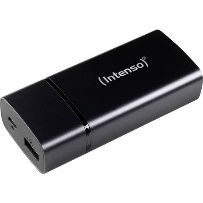
[picture p86: figure]

5V

I(t)

## Slide 3

Results of a field test

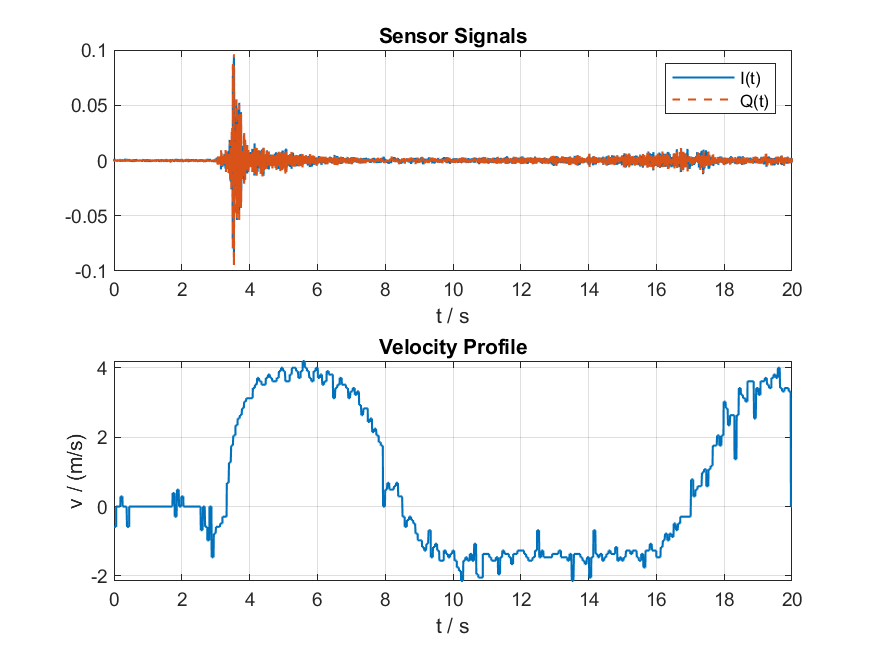
[picture p87: figure]
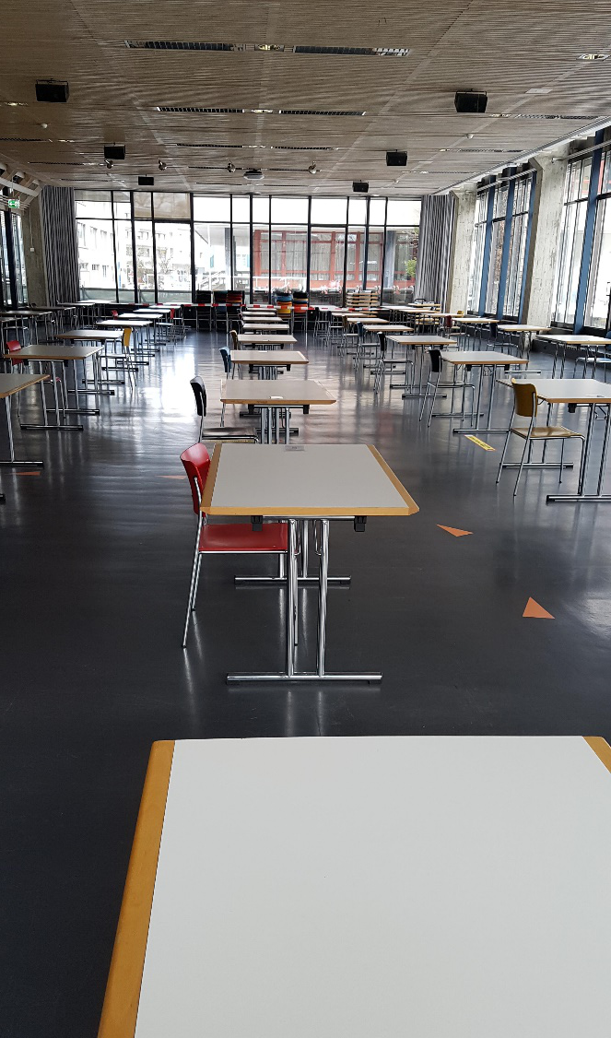
[picture p88: figure]

Δv = 0.1 ms
IvI > 0.2 ms

Jogging &
arm swinging?

sw: -60…0 dBc

fast walking

Radar K-LC6, 60 dB Gain, USB-Audio-Interface
(fs = 4 kSps, NFFT = 256, hanning-window)
