Tommy270502/PM4/4_Firmware/Uart_VirtualCOMPort/UART_Implementation_V1.pdf

## Uart Implementation STM32CubeIDE

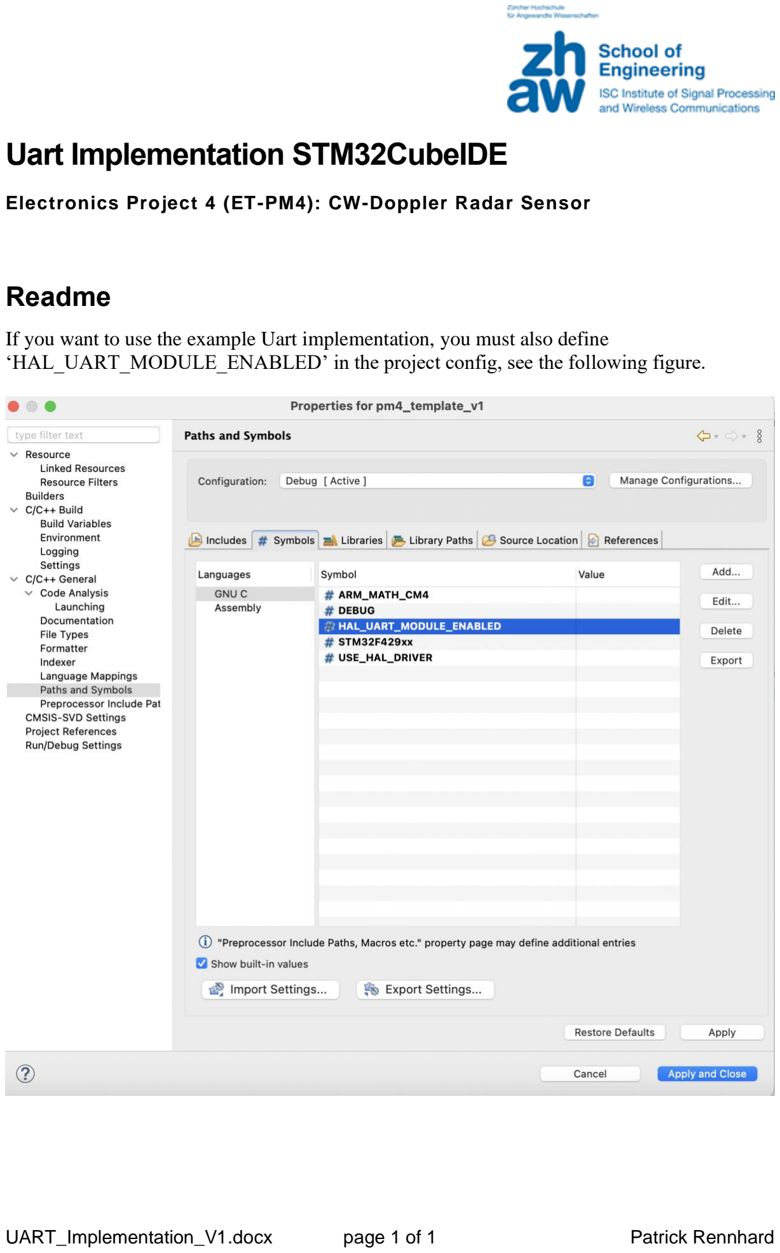
[picture p93: page 1]

UART_Implementation_V1.docx | page 1 of 1 | Patrick Rennhard

Electronics Project 4 (ET-PM4): CW-Doppler Radar Sensor

## Readme

If you want to use the example Uart implementation, you must also define ‘HAL_UART_MODULE_ENABLED’ in the project config, see the following figure.
