Tommy270502/PM4/3_Hardware/4_Datasheets/Screenshot from 2026-03-12 09-31-57.png

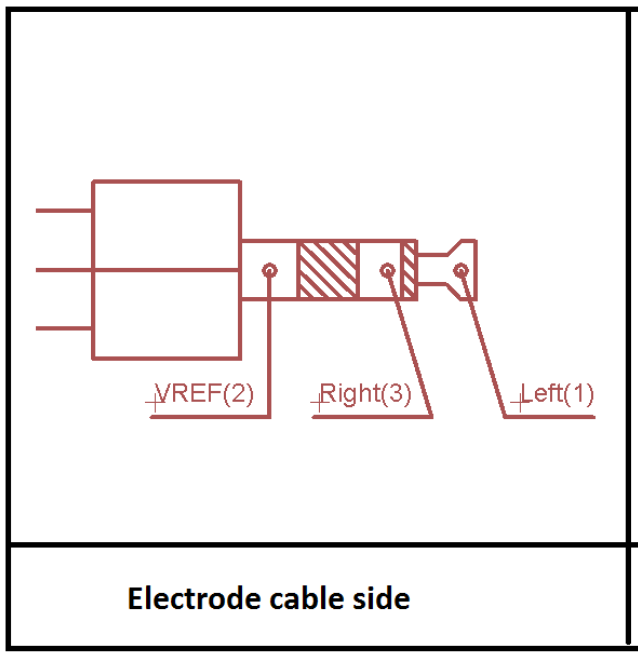
3_Hardware/4_Datasheets/Screenshot from 2026-03-12 09-31-57.png
