Tommy270502/PM4/6_Video Presentation/img/20260520_211245.jpg

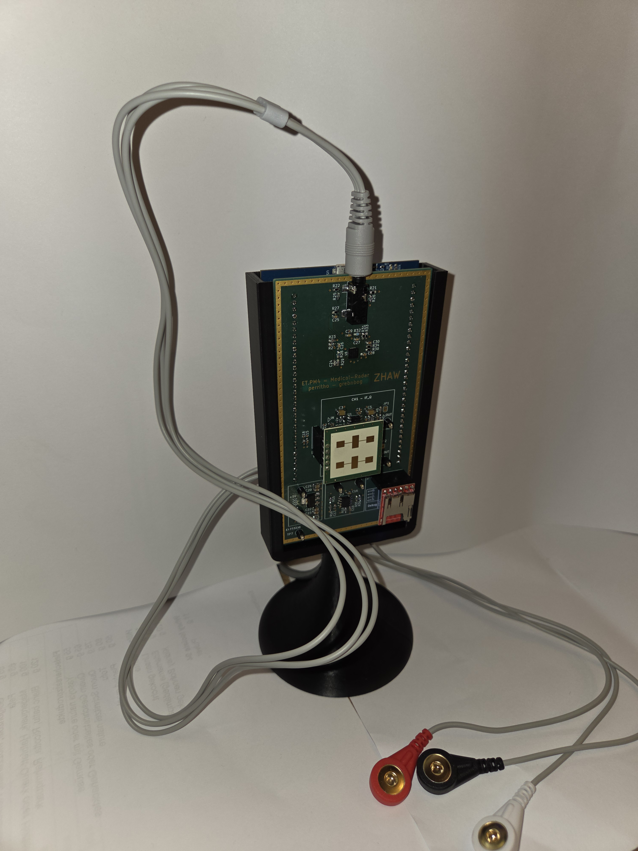
6_Video Presentation/img/20260520_211245.jpg
