Tommy270502/PM4/6_Video Presentation/img/20260521_103315_removed_bg.png

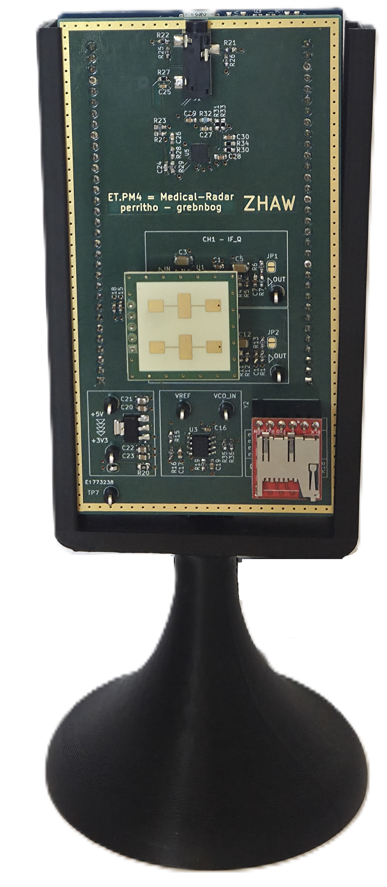
6_Video Presentation/img/20260521_103315_removed_bg.png
