Tommy270502/PM4/6_Video Presentation/img/ecg_cables.jpg

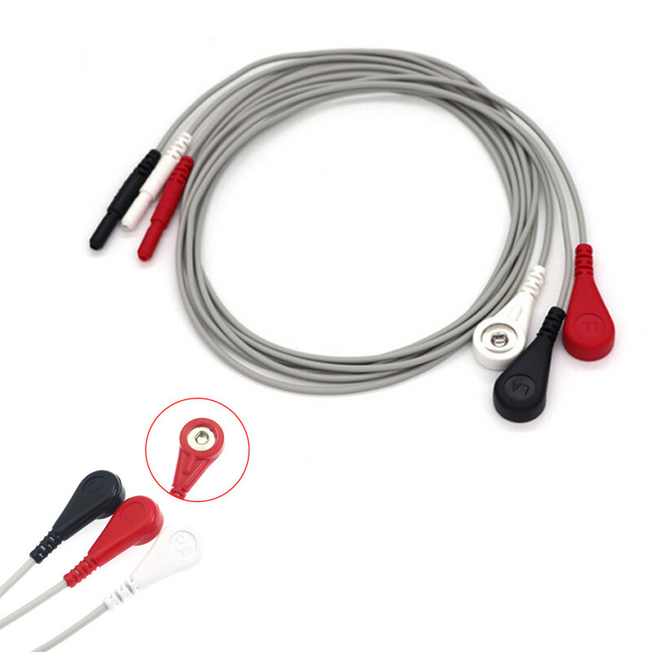
6_Video Presentation/img/ecg_cables.jpg
