Tommy270502/PM4/6_Video Presentation/img/EKG-Analog-Frontend.png

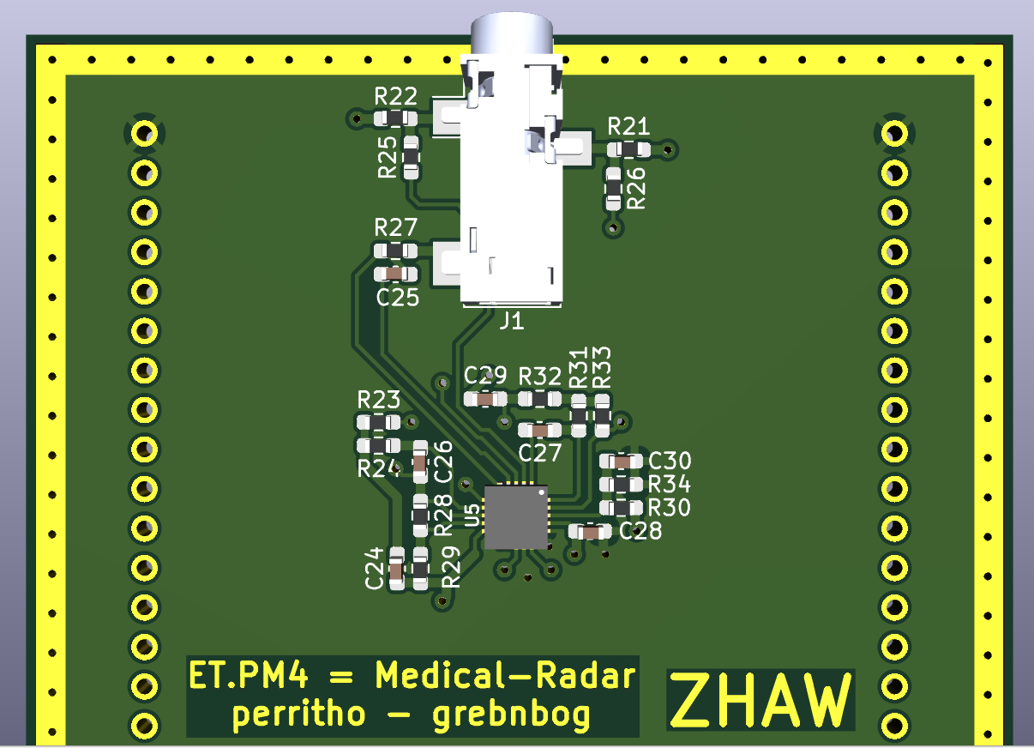
6_Video Presentation/img/EKG-Analog-Frontend.png
