Tommy270502/PM4/6_Video Presentation/img/holter.png

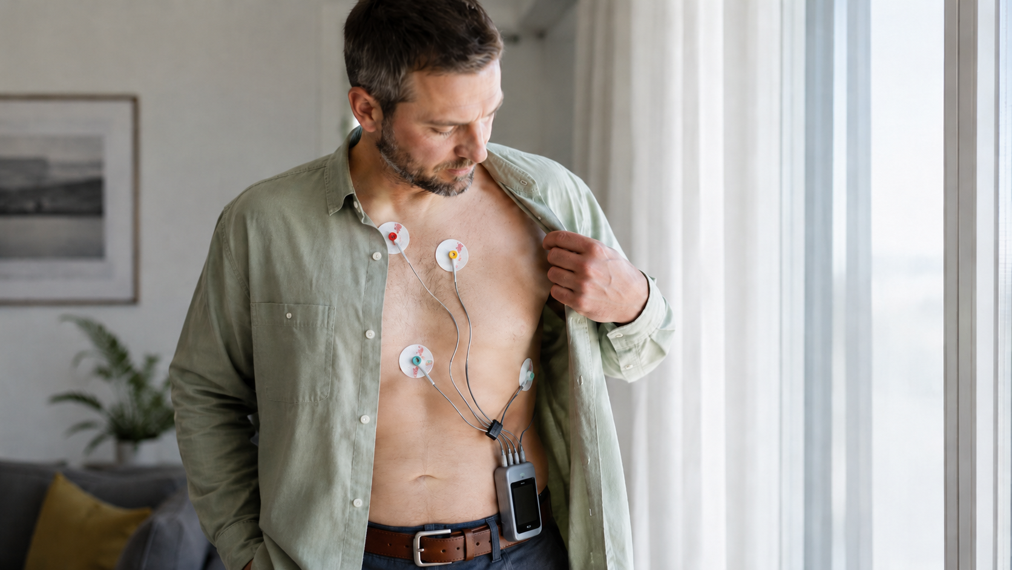
6_Video Presentation/img/holter.png
