Tommy270502/PM4/6_Video Presentation/img/holter_extended.png

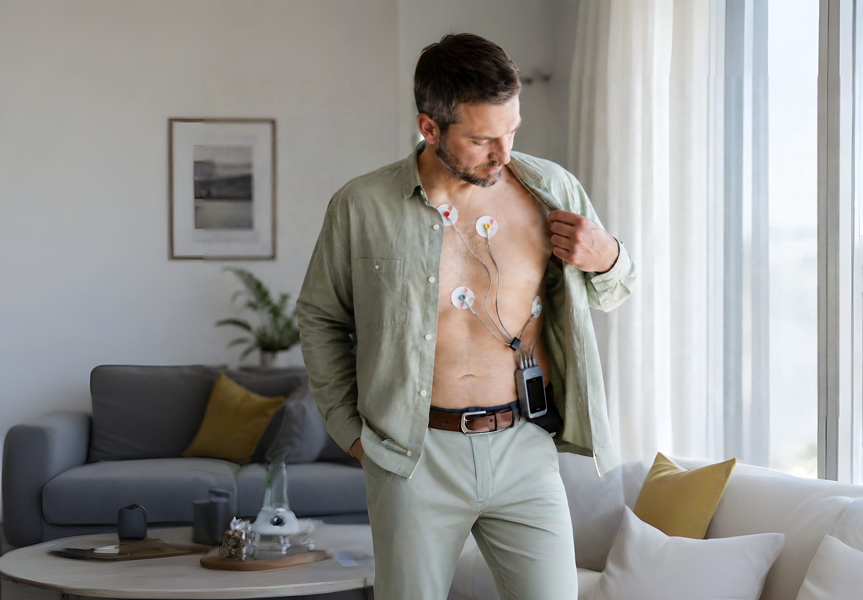
6_Video Presentation/img/holter_extended.png
