Tommy270502/PM4/6_Video Presentation/img/monitoring.png

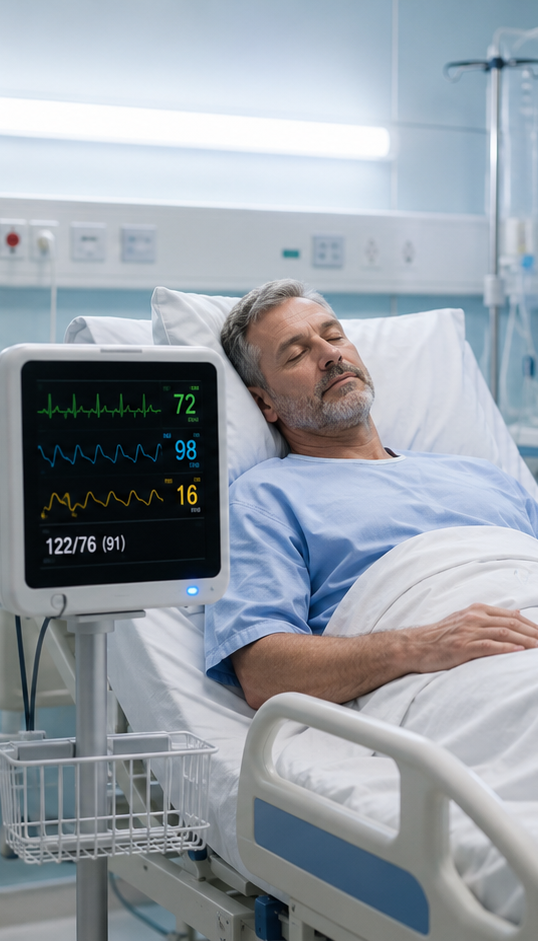
6_Video Presentation/img/monitoring.png
