Tommy270502/PM4/6_Video Presentation/img/monitoring_extended.png

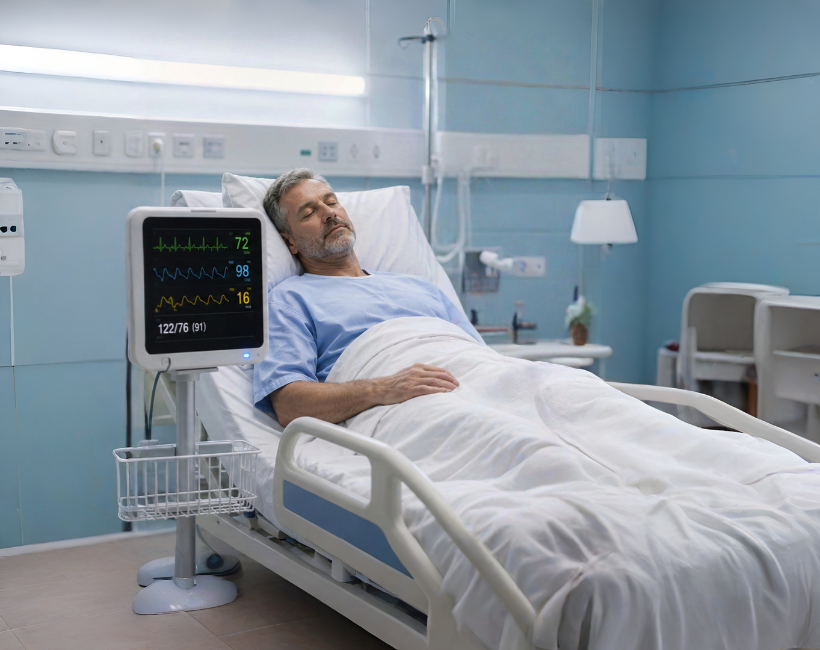
6_Video Presentation/img/monitoring_extended.png
