Tommy270502/PM4/6_Video Presentation/img/pcb_side.png

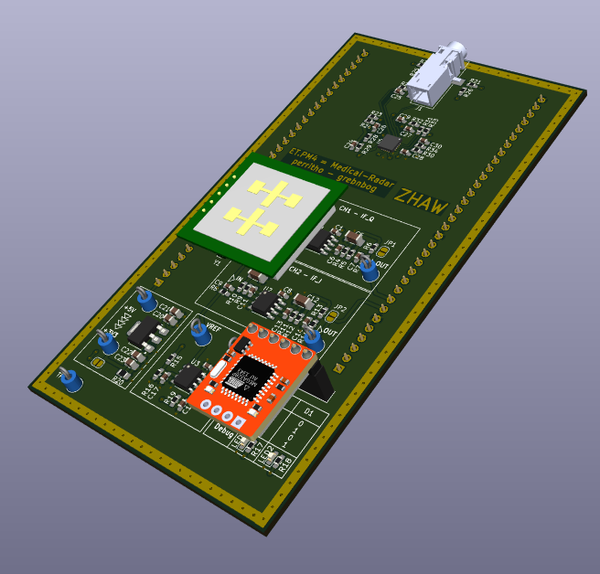
6_Video Presentation/img/pcb_side.png
