Tommy270502/PM4/6_Video Presentation/img/radar beam 2.png

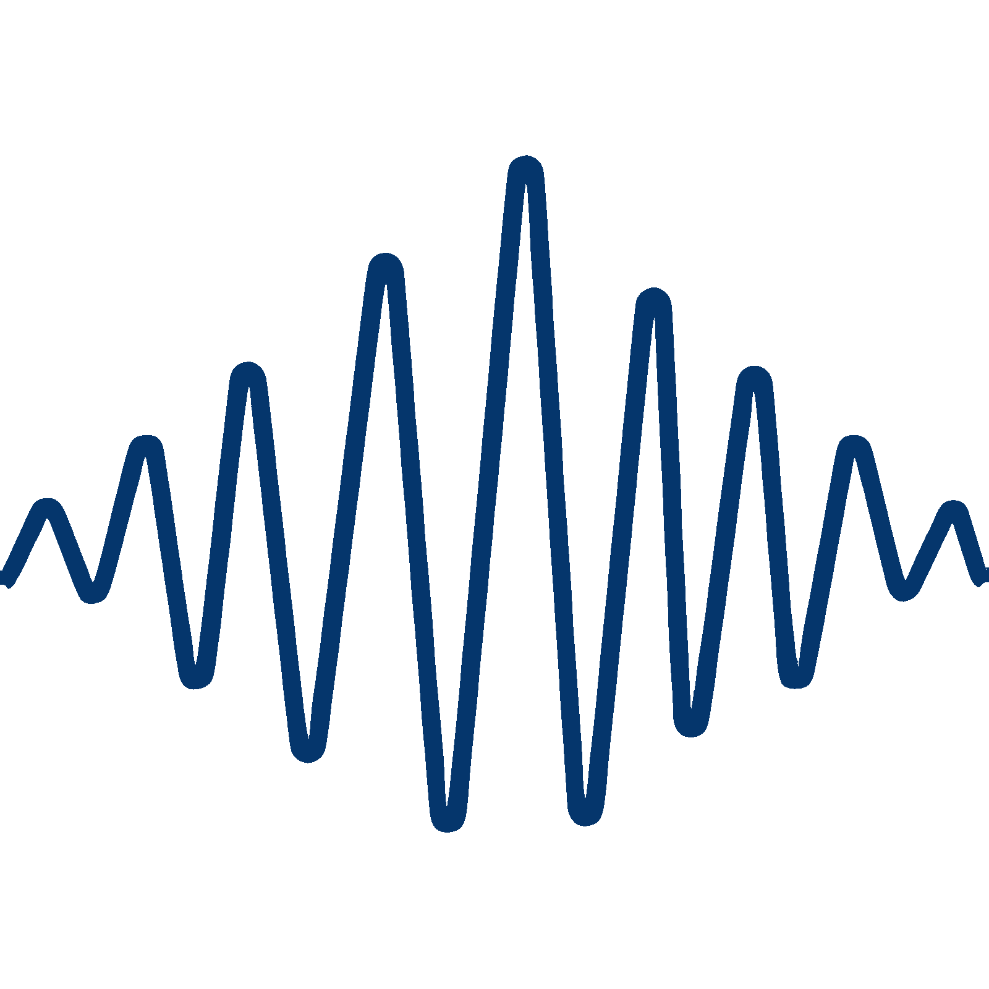
6_Video Presentation/img/radar beam 2.png
