Tommy270502/PM4/6_Video Presentation/img/Radar-Analog-Frontend.png

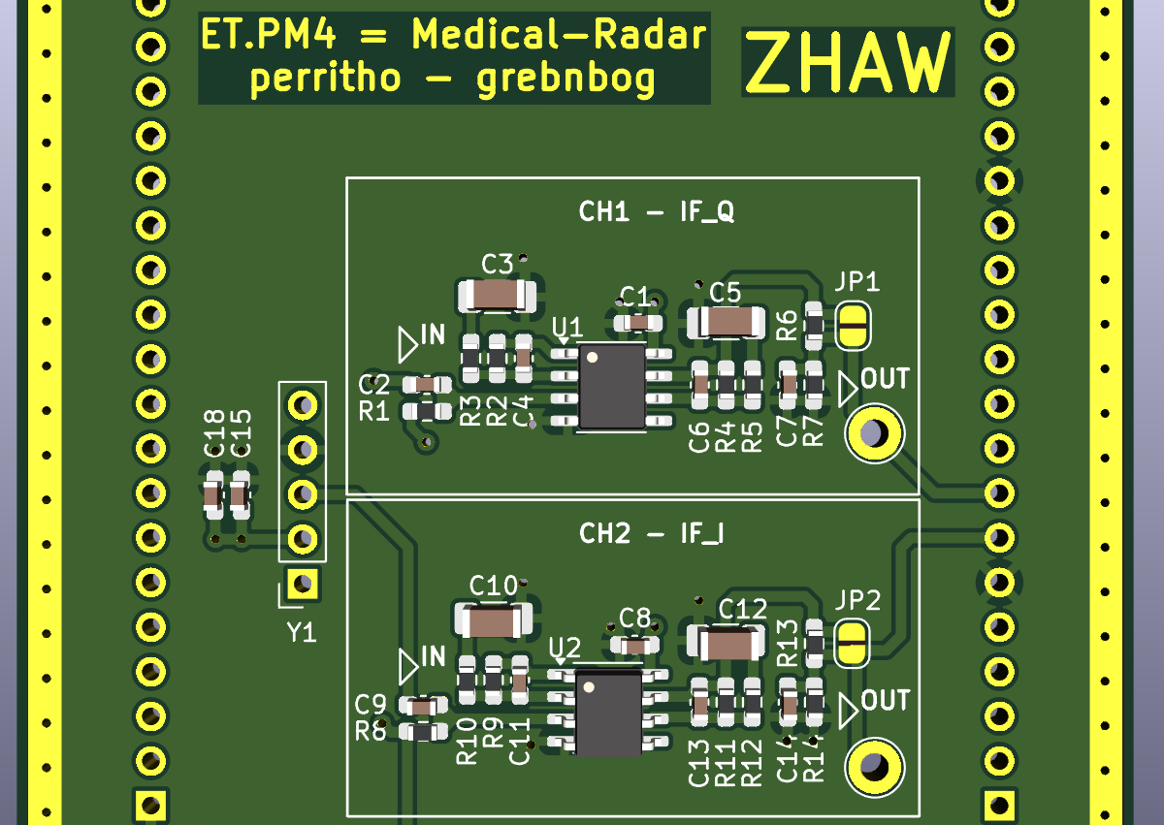
6_Video Presentation/img/Radar-Analog-Frontend.png
