Tommy270502/PM4/6_Video Presentation/img/screenshots/00_Info_Screen.png

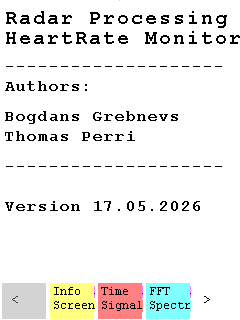
6_Video Presentation/img/screenshots/00_Info_Screen.png
