Tommy270502/PM4/6_Video Presentation/img/screenshots/02_FFT_Spectr_1.png

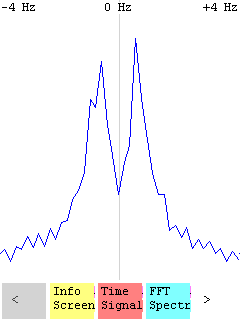
6_Video Presentation/img/screenshots/02_FFT_Spectr_1.png
