Tommy270502/PM4/6_Video Presentation/img/screenshots/06_EKG_BPM_1.png

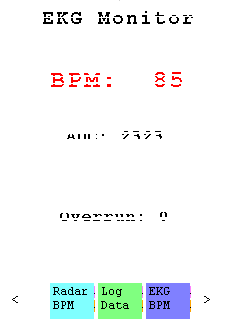
6_Video Presentation/img/screenshots/06_EKG_BPM_1.png
