Tommy270502/PM4/6_Video Presentation/img/sleeping.png

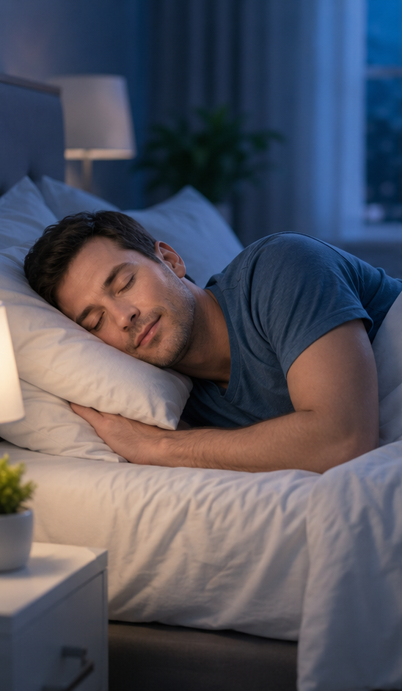
6_Video Presentation/img/sleeping.png
