Tommy270502/PM4/6_Video Presentation/img/sleeping_extended.png

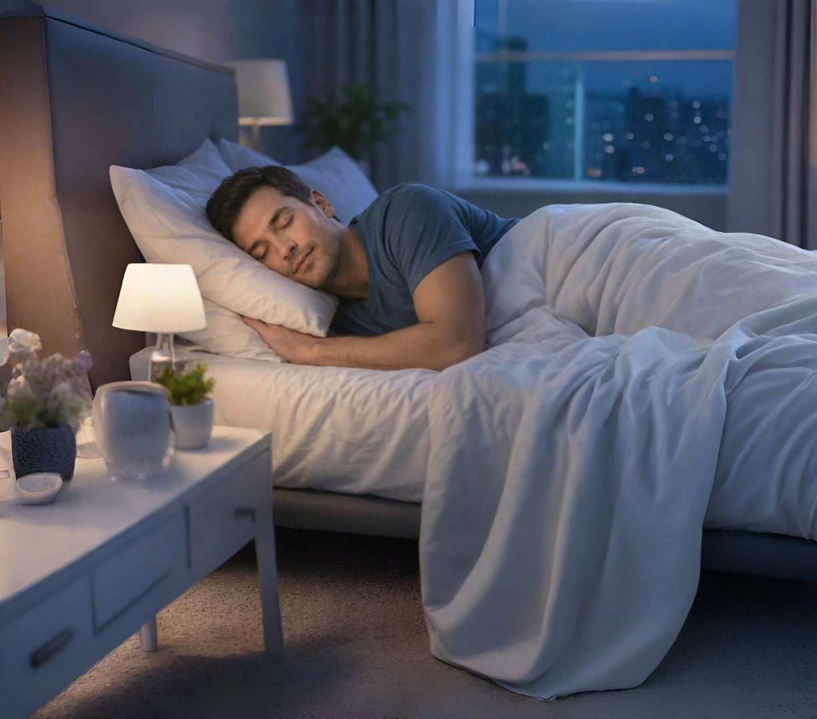
6_Video Presentation/img/sleeping_extended.png
