Tommy270502/PM4/6_Video Presentation/img/stm32 board_2.png

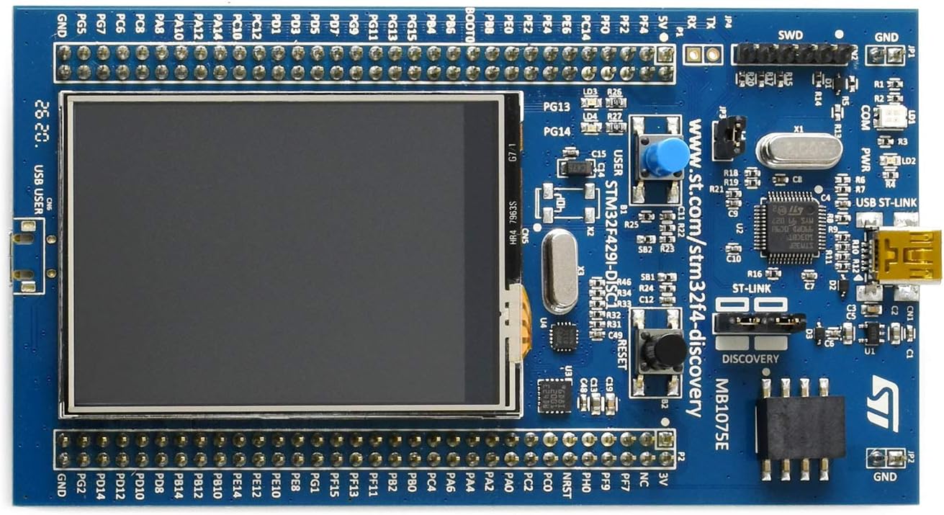
6_Video Presentation/img/stm32 board_2.png
