Tommy270502/PM4/3_Hardware/9.2_Parts order form.xlsx

Sammel- Bestellungen Dienstag Morgen (Distrelec, Farnell, Mouser), Einreichen bis Montag Abend |  |  |  | Achtung: Vor der Bestellung bitte unbedingt Lieferbarkeit prüfen. - Art- Nr. ohne Leerzeichen eintragen. - Mouser und Digikey nur wenn bei Distr./Farnell nicht erhätlich
Lieferant | ArtNr. | Anzahl | Typ, Bezeichnung | EinzelPreis | Gesamtpreis | spätester Bestell-termin | Bemerkungen | Besteller (Kurzzeichen) | bestellt Datum | Termin Nach- lieferung
Procamed | 8900-0003 | 1 | ZOLL ECG Electrodes-3 Box 10Stk | 9.00 | 9.00
Mouser | 909-SHIELD-EKGEMGPRO | 2 | Specialised Cables EKG-EMG CABLE W/SNAP CONNECTOR | 9.56 | 19.12
