Tommy270502/PM4/3_Hardware/9.1_Parts order form.xlsx

Sammel- Bestellungen Dienstag Morgen (Distrelec, Farnell, Mouser), Einreichen bis Montag Abend |  |  |  | Achtung: Vor der Bestellung bitte unbedingt Lieferbarkeit prüfen. - Art- Nr. ohne Leerzeichen eintragen. - Mouser und Digikey nur wenn bei Distr./Farnell nicht erhätlich
Lieferant | ArtNr. | Anzahl | Typ, Bezeichnung | EinzelPreis | Gesamtpreis | spätester Bestell-termin | Bemerkungen | Besteller (Kurzzeichen) | bestellt Datum | Termin Nach- lieferung
Procamed | 8900-0003 | 1 | ZOLL ECG Electrodes-3 Box 10Stk | 9.00 | 9.00
Lieferant | ArtNr. | Anzahl | Typ, Bezeichnung | EinzelPreis | Gesamtpreis | spätester Bestell-termin | Bemerkungen | Besteller (Kurzzeichen) | bestellt Datum | Termin Nach- lieferung
Farnell | 4029748 | 4 | Frontend, Herzfrequenzmesser, 2 bis 3.5V, -40 bis 85°C, LFCSP-EP-20 | 5.95 | 23.80
Farnell | C0603C104K5RACAUTO | 22 | Keramikvielschichtkondensator, SMD, AEC-Q200, 0.1 µF, 50 V, 0603 [Metrisch 1608], ± 10%, X7R | 0.04 | 0.86
Farnell | C1608X5R1A106K080AC | 19 | Keramikvielschichtkondensator, SMD, 10 µF, 10 V, 0603 [Metrisch 1608], ± 10%, X5R | 0.09 | 1.68
Farnell | GRM31CR60J107KEA8K | 13 | Keramikvielschichtkondensator, SMD, 100 µF, 6.3 V, 1206 [Metrisch 3216], ± 10%, X5R | 0.22 | 2.91
Farnell | C0603S472K5RACAUTO | 13 | Keramikvielschichtkondensator, SMD, 4700 pF, 50 V, 0603 [Metrisch 1608], ± 10%, X7R | 0.10 | 1.31
Farnell | CC0805KKX6S5BB106 | 7 | Keramikvielschichtkondensator, SMD, 10 µF, 6.3 V, 0805 [Metrisch 2012], ± 10%, X6S | 0.09 | 0.66
Farnell | 0805B104K500CT | 7 | Keramikvielschichtkondensator, SMD, 0.1 µF, 50 V, 0805 [Metrisch 2012], ± 10%, X7R | 0.01 | 0.09
Farnell | 885012206023 | 7 | Keramikvielschichtkondensator, SMD, 0.33 µF, 10 V, 0603 [Metrisch 1608], ± 10%, X7R | 0.06 | 0.44
Farnell | C0603C152J1RACTU | 4 | Keramikvielschichtkondensator, SMD, 1500 pF, 100 V, 0603 [Metrisch 1608], ± 5%, X7R | 0.14 | 0.56
Farnell | 0603B102K500CT | 4 | Keramikvielschichtkondensator, SMD, 1000 pF, 50 V, 0603 [Metrisch 1608], ± 10%, X7R | 0.01 | 0.04
Farnell | C0603C103K5RACTU | 4 | Keramikvielschichtkondensator, SMD, 0.01 µF, 50 V, 0603 [Metrisch 1608], ± 10%, X7R | 0.02 | 0.08
Farnell | CRG0603F10K | 28 | Chipwiderstand, Oberflächenmontage, 10 kohm, ± 1%, 100 mW, 0603 [Metrisch 1608] | 0.01 | 0.33
Farnell | CRCW06031M00FKEA | 28 | Chipwiderstand, Oberflächenmontage, 1 Mohm, ± 1%, 125 mW, 0603 [Metrisch 1608] | 0.02 | 0.43
Farnell | RCC060310M0FKEA | 19 | Chipwiderstand, Oberflächenmontage, 10 Mohm, ± 1%, 200 mW, 0603 [Metrisch 1608] | 0.03 | 0.63
Farnell | CRCW0603100KFKEA | 13 | Chipwiderstand, Oberflächenmontage, 100 kohm, ± 1%, 125 mW, 0603 [Metrisch 1608] | 0.02 | 0.20
Farnell | MCMR06X1001FTL | 13 | Chipwiderstand, Oberflächenmontage, Keramik, 1 kohm, ± 1%, 100 mW, 0603 [Metrisch 1608] | 0.01 | 0.16
Farnell | RC0603FR-07180KL | 7 | Chipwiderstand, Oberflächenmontage, 180 kohm, ± 1%, 100 mW, 0603 [Metrisch 1608] | 0.01 | 0.05
Farnell | RC0805FR-071KL | 4 | Chipwiderstand, Oberflächenmontage, 1 kohm, ± 1%, 125 mW, 0805 [Metrisch 2012] | 0.01 | 0.03
Farnell | CRCW0603360KFKEA | 4 | Chipwiderstand, Oberflächenmontage, 360 kohm, ± 1%, 125 mW, 0603 [Metrisch 1608] | 0.02 | 0.08
Farnell | RK73H1JTTD1404F | 4 | Chipwiderstand, Oberflächenmontage, 1.4 Mohm, ± 1%, 100 mW, 0603 [Metrisch 1608] | 0.01 | 0.06
Farnell | MCWR06X1102FTL | 4 | Chipwiderstand, Oberflächenmontage, 11 kohm, ± 1%, 100 mW, 0603 [Metrisch 1608] | 0.0046 | 0.02
Farnell | MP008289 | 7 | LED, Rot, Oberflächenmontage, 0603 [Metrisch: 1608], 20 mA, 2.4 V, 638 nm | 0.14 | 0.95
Lieferant | ArtNr. | Anzahl | Typ, Bezeichnung | EinzelPreis | Gesamtpreis | spätester Bestell-termin | Bemerkungen | Besteller (Kurzzeichen) | bestellt Datum | Termin Nach- lieferung
Mouser | 909-SHIELD-EKGEMGPRO | 2 | Specialised Cables EKG-EMG CABLE W/SNAP CONNECTOR | 9.56 | 19.12
