Tommy270502/PM4/3_Hardware/10_ETPM4- Standard_Components.xlsx

Sheet: PM3+4
ET.PM4 |  |  | Standard Components
Description | Distributor | Part Number | Description | Unit Price for 100+ | Remarks
Jumper | Distrelec | 143-71-101 | C2700-02AAGB00R - Isoliert C2700 Jumper, 3A, 1 x 2, 2.54mm Raster, Hsuan Mao | 0.14
USB mini cable | Distrelec | 301-25-756 | USB-A-Anschluss auf USB-Mini-B-Anschlusskabel, 5-polig 1m Schwarz | 1.00
Socket | Distrelec | 300-24-942 | 61303211821 - WR-PHD Gerade Buchse Leiterplattenbuchse, Durchsteckmontage, 1 Reihen, 32 Kontakte, 2.54mm Raster, Würth Elektronik | 1.61 | THT 1x32 for connection to mikrocontroller board
Socket | Distrelec | 143-84-024 | 801-87-032-10-012101 - 801 Gerade Buchse Leiterplattenbuchse, Durchsteckmontage, 1 Reihen, 32 Kontakte, 2.54mm Raster, Preci-Dip | 2.65 | Alternative if above cheaper one is not available
USB mini receptacle | Farnell | 2813789 | USB mini receptacle, used for +5V power connection
USB mini receptacle | Distrelec | 301-12-363 | USB mini receptacle, has been replace by above
STM32F429I-DISC1 | Farnell | 2506924 | STM32F429I-DISC1 - Entwicklungsboard, STM32F429ZI-MCU, 2.4"-QVGA-LCD, 3-Achsen-MEMS-Bewegungssensor | 30.00 | Price of 1 board. Volume discount? Also available at Distrelec, Mouser and Digikey
Header, SMD, 2x4 | Farnell | 2847231 | 2213SM-08G-TB - Stiftleiste, Board-to-Board, 2.54 mm, 2 Reihe(n), 8 Kontakt(e), Oberflächenmontage | 0.23 | SMD 2x4, for jumper
Header, SMD, 1x2 | Farnell | 2505008 | Board-to-Board-Steckverbinder, 2.54 mm, 2 Kontakt(e), Stiftleiste,
Header, THT, 2x20 | Farnell | 2725179 | 2213S-40G - Board-to-Board-Steckverbinder, 2.54 mm, 40 Kontakt(e), Stiftleiste, Baureihe 2213S | 0.10 | THT 2x20
Header, THT, 2x20 | Farnell | 1593446 | Replacement for above
Header, THT, 2x4 | Farnell | 1593441 | 2213S-08G - Board-to-Board-Steckverbinder, 2.54 mm, 8 Kontakt(e), Stiftleiste, Baureihe 2213S | 0.04 | THT 2x4, for mechanical support
Header, THT, 1x2 | Farnell | 1593411 | 2211S-02G - Board-to-Board-Steckverbinder, 2.54 mm, 2 Kontakt(e), Stiftleiste, Baureihe 2211S | 0.01 | THT 1x2, support for coil sensor
Header, THT, 1x3 | Farnell | 3417657 | Stiftleiste, Board-to-Board, 2.54 mm, 1 Reihe(n), 3 Kontakt(e), Durchsteckmontage, gerade | 0.30
Female Header THT, 1x8 | Farnell | 1668367 | Printbuchse, Board-to-Board, 2.54 mm, 1 Reihe(n), 8 Kontakt(e), Durchsteckmontage, SSW | 1.46
Female Header THT, 1x84 | Farnell | 1668342 | Printbuchse, Board-to-Board, 2.54 mm, 1 Reihe(n), 4 Kontakt(e), Durchsteckmontage, SSW | 1.12
SIP32508, Switch | Farnell | 2361512 | SIP32508DT-T1-GE3 - Leistungsschalter, über Slew-Rate gesteuert, High-Side, Active-High, 1 Ausgang, 5.5V, TSOT-23-6 | 0.27 | For pushbutton on / auto off
Pushbutton | Farnell | 1217769 | 1301.9318 - Taster, LSH Series, Von oben zu betätigen, Oberflächenmontage, Runde Taste, 160 gf, 50mA bei 12V DC | 0.20 | Pshbutton on
LD1117S33, LDO | Farnell | 1467779 | LD1117S33CTR - LDO-Spannungsregler 3.3V 800mA SOT-223, ST | 0.29
MCP6002, OpAmp | Farnell | 1292246 | MCP6002-I/SN - Operationsverstärker, Zweifach, 2 Verstärker, 1 MHz, 0.6 V/µs, 1.8V bis 5.5V, SOIC, 8 Pin(s) | 0.24
MCP6272, OpAmp | Farnell | 1439452 | MCP6272-E/SN Operationsverstärker, Zweifach, 2 Verstärker, 2 MHz, 0.9 V/µs, 2V bis 5.5V, SOIC, 8 Pin(s) | 0.57 | Replacement for MCP6002
SD103, Signal-Schottky | Farnell | 1773502 | SD103AWS-7-F - Kleinsignal-Schottky-Diode, Einfach, 40 V, 200 mA, 600 mV, 1.5 A, 125 °C | 0.13
SS13, Power-Schottky | Farnell | 1559158 | SS13L R3 - Schottky-Gleichrichterdiode, 30 V, 1 A, Einfach, SMD, 2 Pin(s), 500 mV | 0.17
100 µF, 6.3 V, 1206 | Farnell | 1907519 | GRM31CD80J107ME39L - Keramikvielschichtkondensator, SMD, 100 µF, 6.3 V, 1206 [Metrisch 3216], ± 20%, X6T, Baureihe GRM | 0.35 | Replaces an electrolytic capacitor
10 µF, 16 V, 0805 | Farnell | 2611940 | GRM21BR61C106KE15K - Keramikvielschichtkondensator, SMD, 10 µF, 16 V, 0805 [Metrisch 2012], ± 10%, X5R, GRM Series | 0.14 | Replaces an electrolytic capacitor
1 µF, 16 V, 0805 | Farnell | 9227792 | C0805C105K4RACTU - Keramikvielschichtkondensator, SMD, 1 µF, 16 V, 0805 [Metrisch 2012], ± 10%, X7R | 0.06 | Block capacitor
100 nF, 50 V, 0805 | Farnell | 1650866 | C0805C104M5RACTU - Keramikvielschichtkondensator, SMD, 0.1 µF, 50 V, 0805 [Metrisch 2012], ± 20%, X7R | 0.03 | Block capacitor
Testpoint | Farnell | 2301284 | TEST POINT, PCB, THROUGH HOLE | 0.16 | Test point with loop to attach probes
Header, THT, 1x6 | Farnell | 1593415 | 2211S-06G - Board-to-Board-Steckverbinder, 2.54 mm, 6 Kontakt(e), Stiftleiste | 0.04 | THT 1x6, header as alternative to test points
BSS316N | Farnell | 2432720 | Leistungs-MOSFET, n-Kanal, 30 V, 1.4 A, 0.119 ohm, SOT-23, Oberflächenmontage | 0.01
Plastic Screw, M3 | Farnell | 2472710 | Schrauben, Zylinderkopfschrauben, Schraubensatz, Schlitz, M3, Nylon 6.6, 30mm Länge | 16.05 | Package with 100 pcs
Plastc Nut M3 | Farnell | 2472687 | Nut, Hex, M3, Nylon 6.6, Pack of 100 | 13.40 | Package with 100 pcs
Radar-Sensor K-LC5 3.3V | Digikey | 2012-K-LC5- RFB-00C-ND | K-LC5-RFB-00C Radar HF-Transceiver-Module 24,05GHz bis 24,25GHz | 23.27 | Radar-Modul for PM4, 3.3V version
OpenLog SD-card adapter | Digikey | 1568-1368-ND | DEV-13712 ATMega328 Datenlogger Memory Evaluierungsplatine | 14.11 | if datalogger functionality is desired
 | Others |  | LED with different colours, Footprint 1206 or similar | 0.10
 | Others |  | Resistors, different values, SMD 0805,E12 from standard kits | 0.02
 | Others |  | Capacitors, different values < 10nF, SMD 0805, from standard kits | 0.04

Sheet: Demo-Board
ET.PM3 |  |  | Demo-HW for the cable_monitor_template SW => 10 for lecturers
Distributor | Part Number | Quantity per demo board | Description | Unit Price for 100+ | Total | Remarks
Distrelec | 143-71-101 | 1 | C2700-02AAGB00R - Isoliert C2700 Jumper | 0.27 | 0.27
Distrelec |  |  |  |  | 0.00
Farnell | 1191725 | 1 | RK09K1130AH1 - Drehpotentiometer, 10 kohm, 1 Umdrehung(en), Linear, 50 mW | 0.72 | 0.72
Farnell | 3259745 | 1 | MP170822BR - Knopf, D-förmig, 6 mm, Rund mit Markierungslinie, 16.2 mm | 0.49 | 0.49
Farnell | 1593495 | 1 | 2214S-22SG-85 - Board-to-Board-Steckverbinder, 2.54 mm, 22 Kontakt(e), Buchse | 0.60 | 0.60
Farnell | 1593415 | 1 | 2211S-06G - Board-to-Board-Steckverbinder, 2.54 mm, 6 Kontakt(e), Stiftleiste | 0.04 | 0.04
Farnell | 9527710 | 1 | GRM21BR71C105KA01L - Keramikvielschichtkondensator, SMD, 1 µF, 16 V, 0805 [Metrisch 2012], ± 10%, X7R, Baureihe GRM | 0.06 | 0.06
Farnell |  |  |  |  | 0.00
Mouser |  |  |  |  | 0.00
Digikey |  |  |  |  | 0.00
Others |  | 2 | Resistors, different values, SMD 0805, from standard kits | 0.02 | 0.04
Eurocircuit |  | 1 | Demo-HW-PCB for the cable_monitor_template SW | 10.00 | 10.00
Total |  |  |  |  | 12.22

Sheet: Connector-PCB
ET.PM3 |  |  | Connector PCB for Piggyback => 10 for testequipment
Distributor | Part Number | Quantity per connector PCB | Description | Unit Price for 100+ | Total | Remarks
Distrelec |  |  |  |  | 0.00
Farnell | 2356216 | 1 | 61003218221 Stiftleiste, Board-to-Board, 2.54 mm, 1 Reihe(n), 32 Kontakt(e), Oberflächenmontage, gerade | 2.35 | 2.35
Farnell | 3584712 | 1 | SSM-132-L-SV Printbuchse, Board-to-Board, 2.54 mm, 1 Reihe(n), 32 Kontakt(e), Oberflächenmontage | 5.24 | 5.24
Farnell |  |  |  |  | 0.00
Mouser |  |  |  |  | 0.00
Digikey |  |  |  |  | 0.00
Others |  |  |  |  | 0.00
Eurocircuit |  |  |  |  | 0.00
Total |  |  |  |  | 7.59
