Tommy270502/PM4/3_Hardware/1_HW_template_2026_02_11_v10/HW_template.step

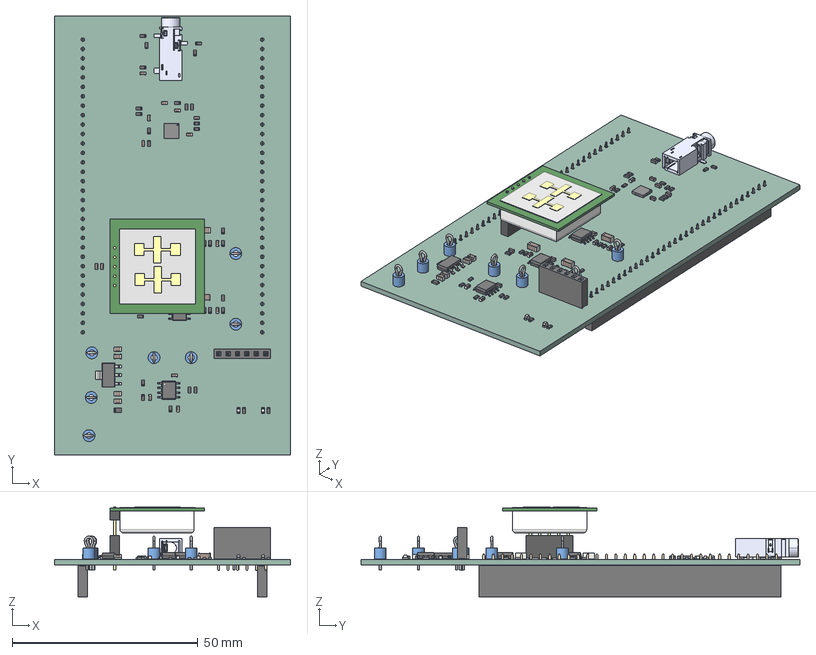
[picture p146: CAD file, 2026-04-22]
3_Hardware/1_HW_template_2026_02_11_v10/HW_template.step
63.5 x 118.1 x 24.2 mm
R_0603_1608Metric x 35
Radar_K-LC5
C_0603_1608Metric x 22
C_1206_3216Metric x 4
SOIC-8_3.9x4.9mm_P1.27mm x 3
TestPoint_Loop_D2.60mm_Drill1.6mm_Beaded x 7
LED_0603_1608Metric x 2
C_0805_2012Metric x 4
SJ-3523-SMT-TR--3DModel-STEP-1
SOT-223
PinSocket_1x06_P2.54mm_Vertical
AD8232
R_0805_2012Metric
PinSocket_1x32_P2.54mm_Vertical x 2
HW_template_PCB
