Tommy270502/PM4/3_Hardware/3_Data_Logger_Module/Components/ATmega328 TQFP/ATmega.SLDPRT

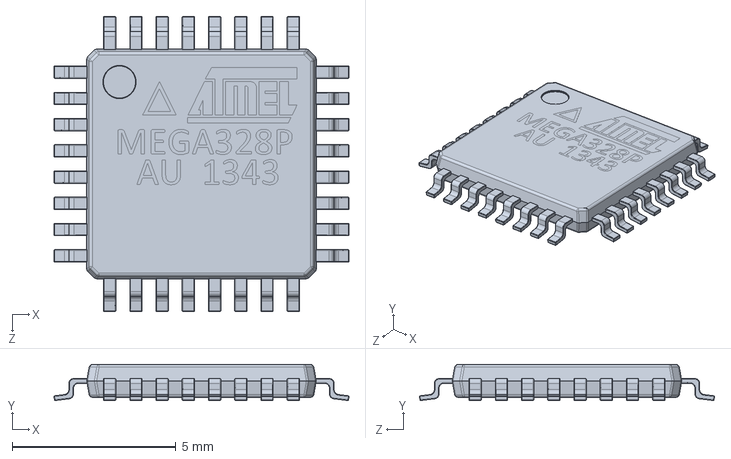
[picture p147: CAD file, 2026-05-21]
3_Hardware/3_Data_Logger_Module/Components/ATmega328 TQFP/ATmega.SLDPRT
9.00 x 1.10 x 9.00 mm
