Tommy270502/PM4/3_Hardware/3_Data_Logger_Module/Components/microSDslot.stp

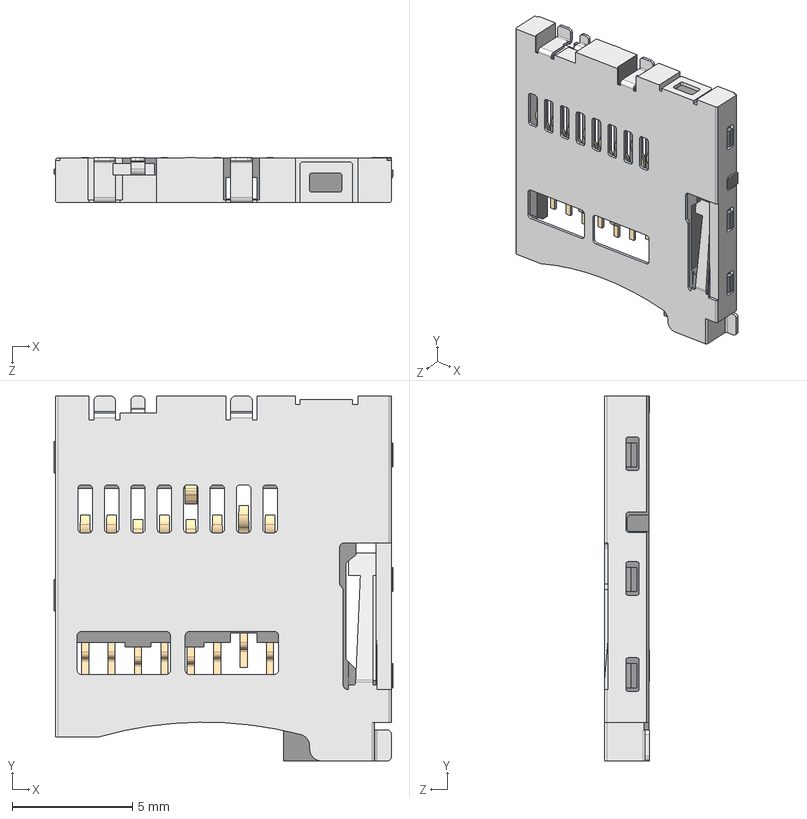
[picture p148: CAD file, 2026-05-21]
3_Hardware/3_Data_Logger_Module/Components/microSDslot.stp
14.1 x 15.2 x 1.88 mm
