Tommy270502/PM4/3_Hardware/3_Data_Logger_Module/OpenLog - basic.STEP

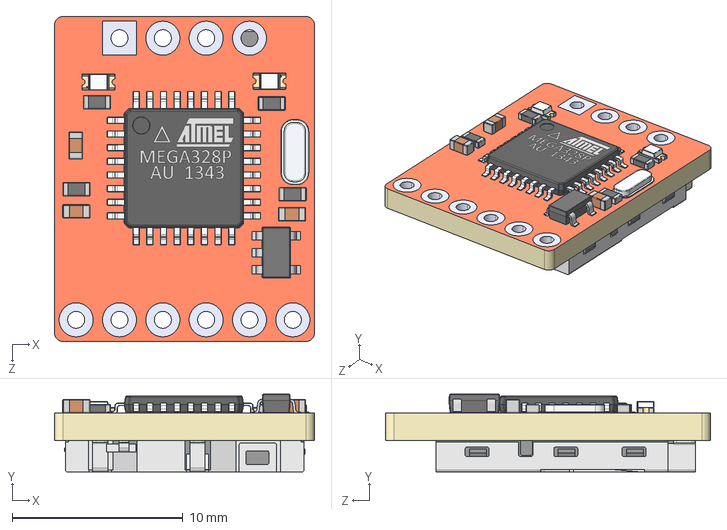
[picture p149: CAD file, 2026-05-21]
3_Hardware/3_Data_Logger_Module/OpenLog - basic.STEP
15.2 x 4.55 x 19.1 mm
