Tommy270502/PM4/3_Hardware/8_Casing/casing.FCStd

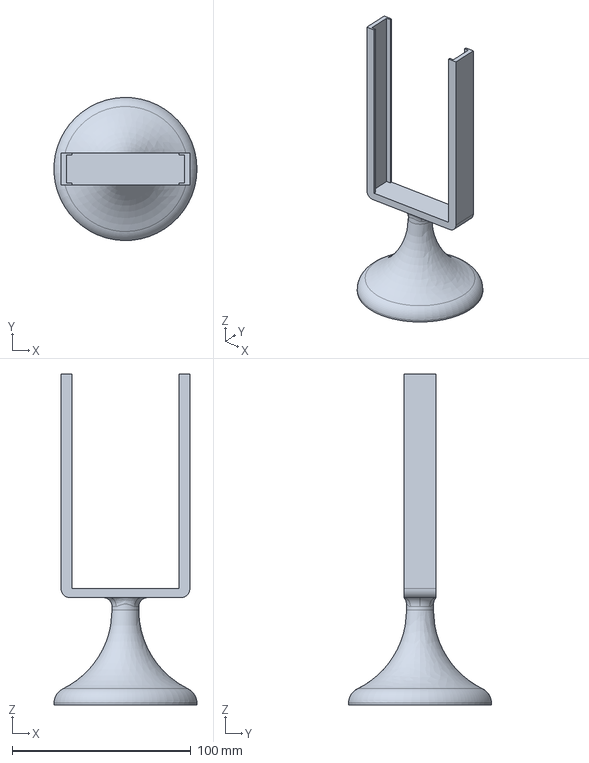
[picture p150: CAD file, 2026-05-11]
3_Hardware/8_Casing/casing.FCStd
79.9 x 80.0 x 185.0 mm
