Tommy270502/PM4/3_Hardware/3_Data_Logger_Module/Components/Surface Mount Chip LED 3.2x1.6mm.SLDPRT

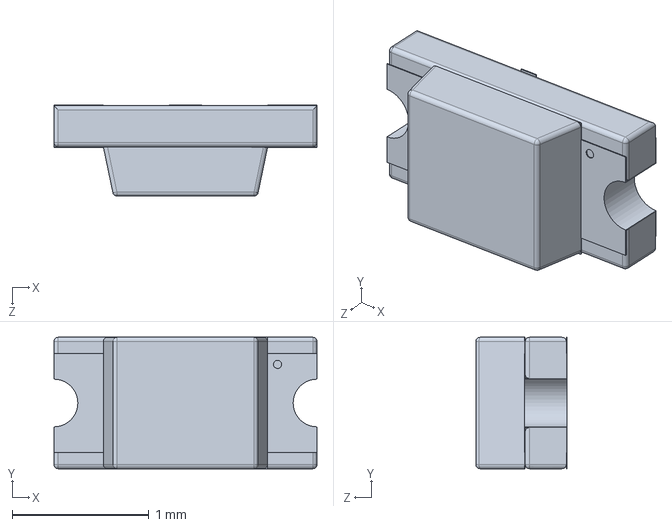
[picture p151: CAD file, 2026-05-21]
3_Hardware/3_Data_Logger_Module/Components/Surface Mount Chip LED 3.2x1.6mm.SLDPRT
1.92 x 0.96 x 0.666 mm
