Tommy270502/PM4/3_Hardware/3_Data_Logger_Module/OpenLog - pins up.STEP

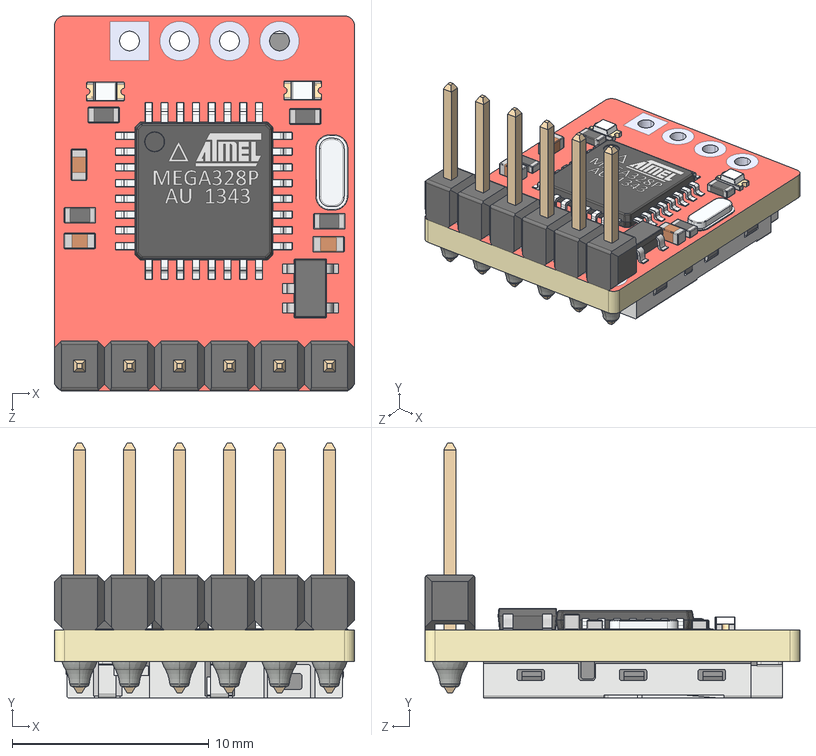
[picture p152: CAD file, 2026-05-21]
3_Hardware/3_Data_Logger_Module/OpenLog - pins up.STEP
15.2 x 12.9 x 19.1 mm
