Tommy270502/PM4/3_Hardware/8_Casing/casing-BodyV2.step

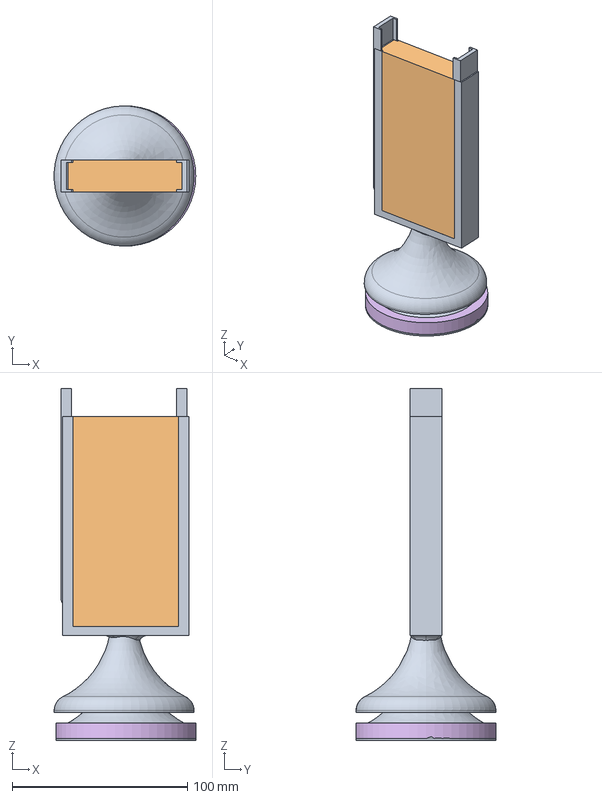
[picture p153: CAD file, 2026-05-11]
3_Hardware/8_Casing/casing-BodyV2.step
80.9 x 80.0 x 201.0 mm
X-axis x 3
XY-plane x 3
Sketch
Sketch001
Sketch002
Sketch004
Sketch005
Sketch006
Hole
