Tommy270502/PM4/3_Hardware/3_Data_Logger_Module/Components/SOT23-5.SLDPRT

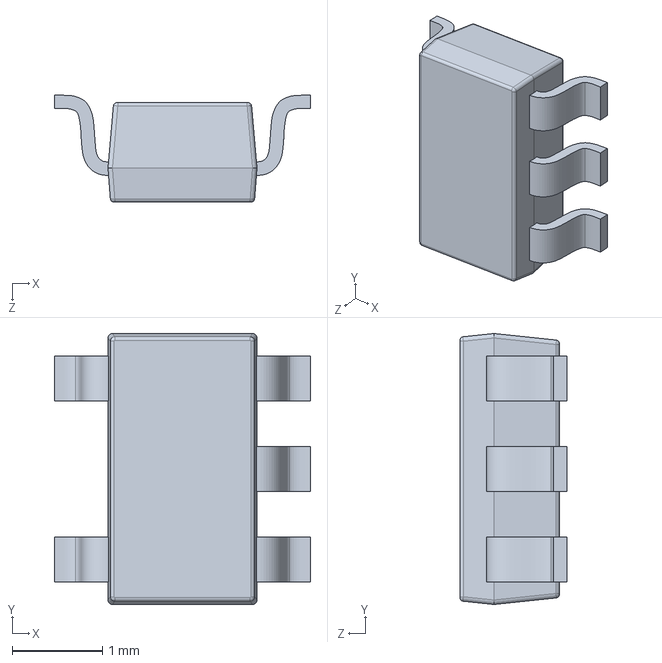
[picture p154: CAD file, 2026-05-21]
3_Hardware/3_Data_Logger_Module/Components/SOT23-5.SLDPRT
2.84 x 3.00 x 1.18 mm
