Tommy270502/PM4/3_Hardware/3_Data_Logger_Module/Components/OpenLog_PCB.SLDPRT

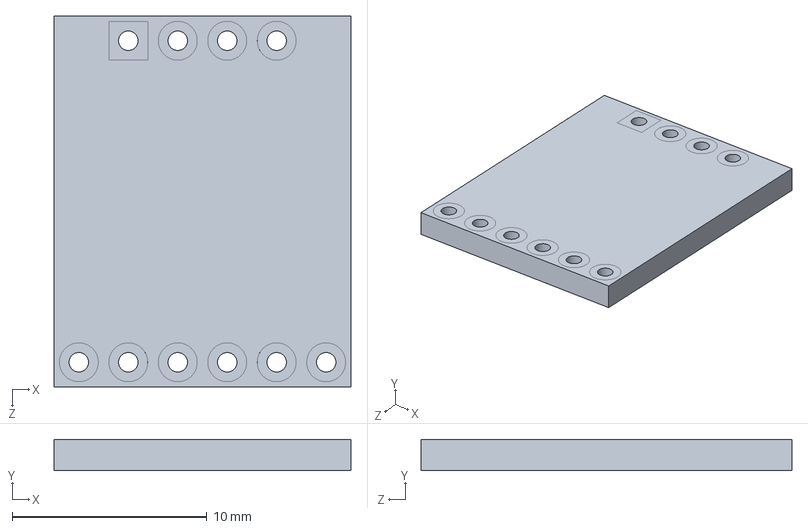
[picture p155: CAD file, 2026-05-21]
3_Hardware/3_Data_Logger_Module/Components/OpenLog_PCB.SLDPRT
15.2 x 1.60 x 19.1 mm
