Tommy270502/PM4/3_Hardware/3_Data_Logger_Module/Components/Fusion001.sldprt

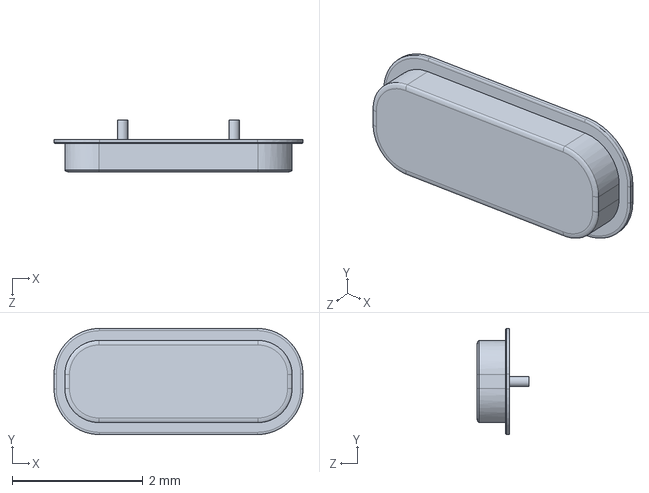
[picture p157: CAD file, 2026-05-21]
3_Hardware/3_Data_Logger_Module/Components/Fusion001.sldprt
3.82 x 1.63 x 0.795 mm
