Tommy270502/PM4/3_Hardware/3_Data_Logger_Module/Components/cap_603.SLDPRT

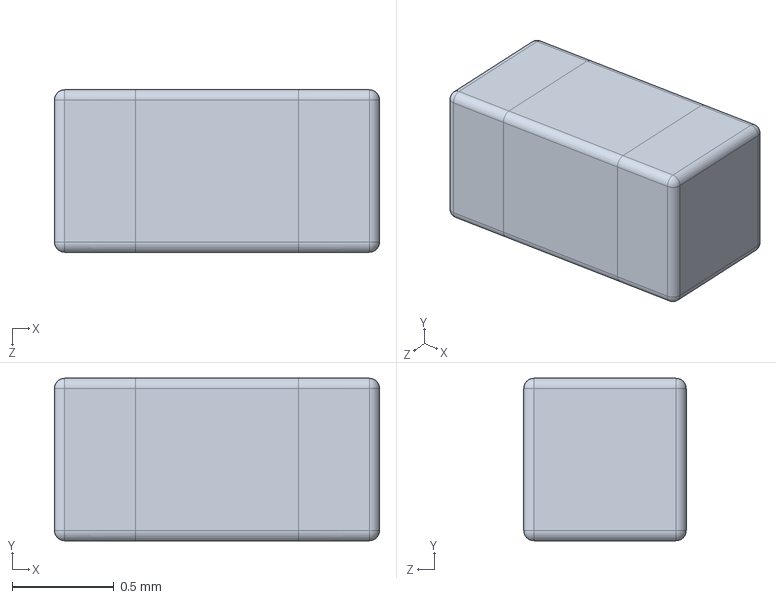
[picture p158: CAD file, 2026-05-21]
3_Hardware/3_Data_Logger_Module/Components/cap_603.SLDPRT
1.60 x 0.8 x 0.8 mm
