Tommy270502/PM4/3_Hardware/3_Data_Logger_Module/Components/solder.SLDPRT

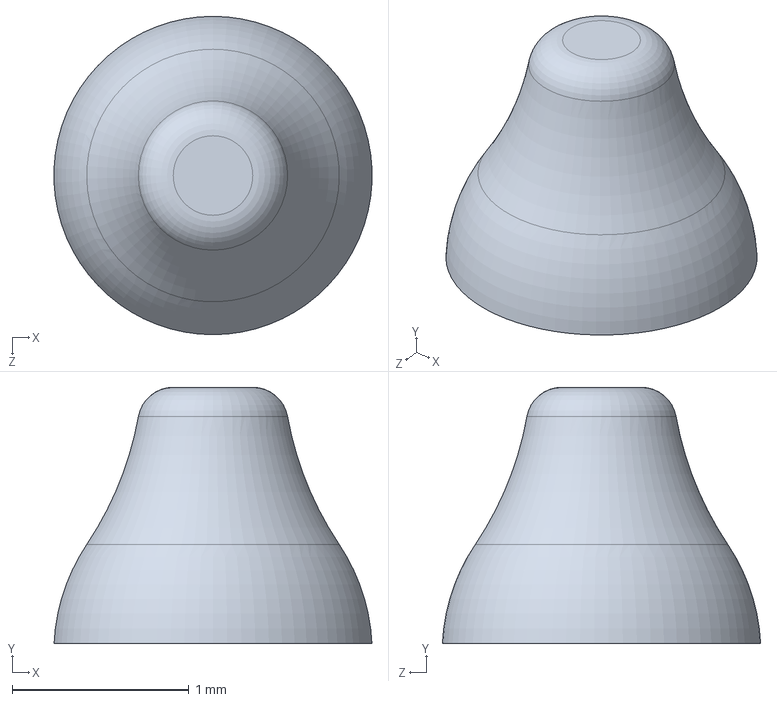
[picture p159: CAD file, 2026-05-21]
3_Hardware/3_Data_Logger_Module/Components/solder.SLDPRT
1.80 x 1.45 x 1.80 mm
