Tommy270502/PM4/3_Hardware/3_Data_Logger_Module/Components/Pin Header 1x6 TH Pitch 2.54mm.SLDPRT

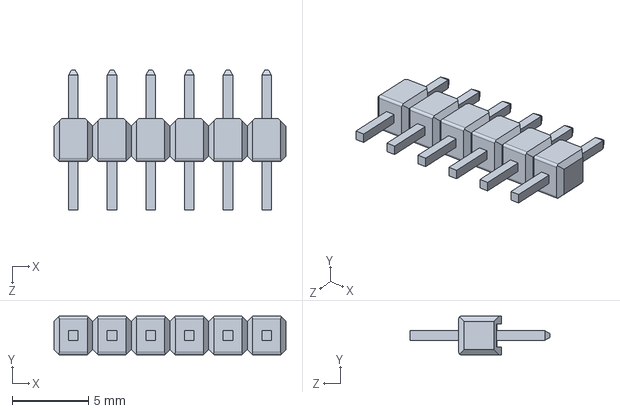
[picture p160: CAD file, 2026-05-21]
3_Hardware/3_Data_Logger_Module/Components/Pin Header 1x6 TH Pitch 2.54mm.SLDPRT
15.2 x 2.54 x 9.20 mm
