Tommy270502/PM4/3_Hardware/8_Casing/casing-Body.step

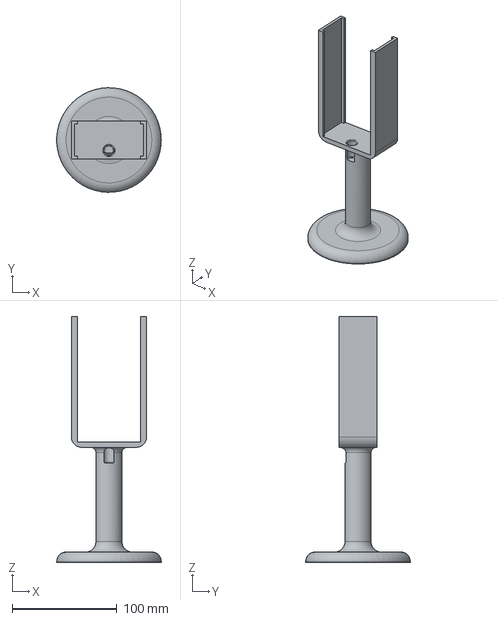
[picture p161: CAD file, 2026-04-27, an earlier design]
3_Hardware/8_Casing/casing-Body.step
99.9 x 100.0 x 235.0 mm
