Tommy270502/PM4/(list of files, cad)

Other CAD files:
3_Hardware/3_Data_Logger_Module/OpenLog - pins down.STEP
3_Hardware/3_Data_Logger_Module/OpenLog - basic.SLDASM
3_Hardware/3_Data_Logger_Module/OpenLog - basic.SLDPRT
3_Hardware/3_Data_Logger_Module/OpenLog - pins down.SLDASM
3_Hardware/3_Data_Logger_Module/OpenLog - pins down.SLDPRT
3_Hardware/3_Data_Logger_Module/OpenLog - pins up.SLDASM
3_Hardware/3_Data_Logger_Module/OpenLog - pins up.SLDPRT
3_Hardware/8_Casing/casing-Body.3mf
3_Hardware/8_Casing/casing-Body.stl
3_Hardware/8_Casing/casing-BodyV2.stl
