Tommy270502/PM4/5_Subsystem Tests/HW_Block_Diagram.png

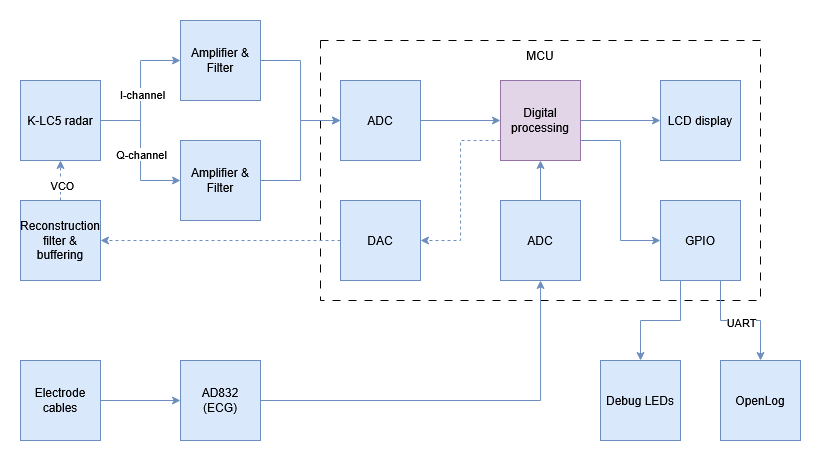
5_Subsystem Tests/HW_Block_Diagram.png
