Tommy270502/PM4/5_Subsystem Tests/FW_Block_Diagram.pdf

# Firmware Block Diagram

FW_Block_Diagram.md | 2026-04-16

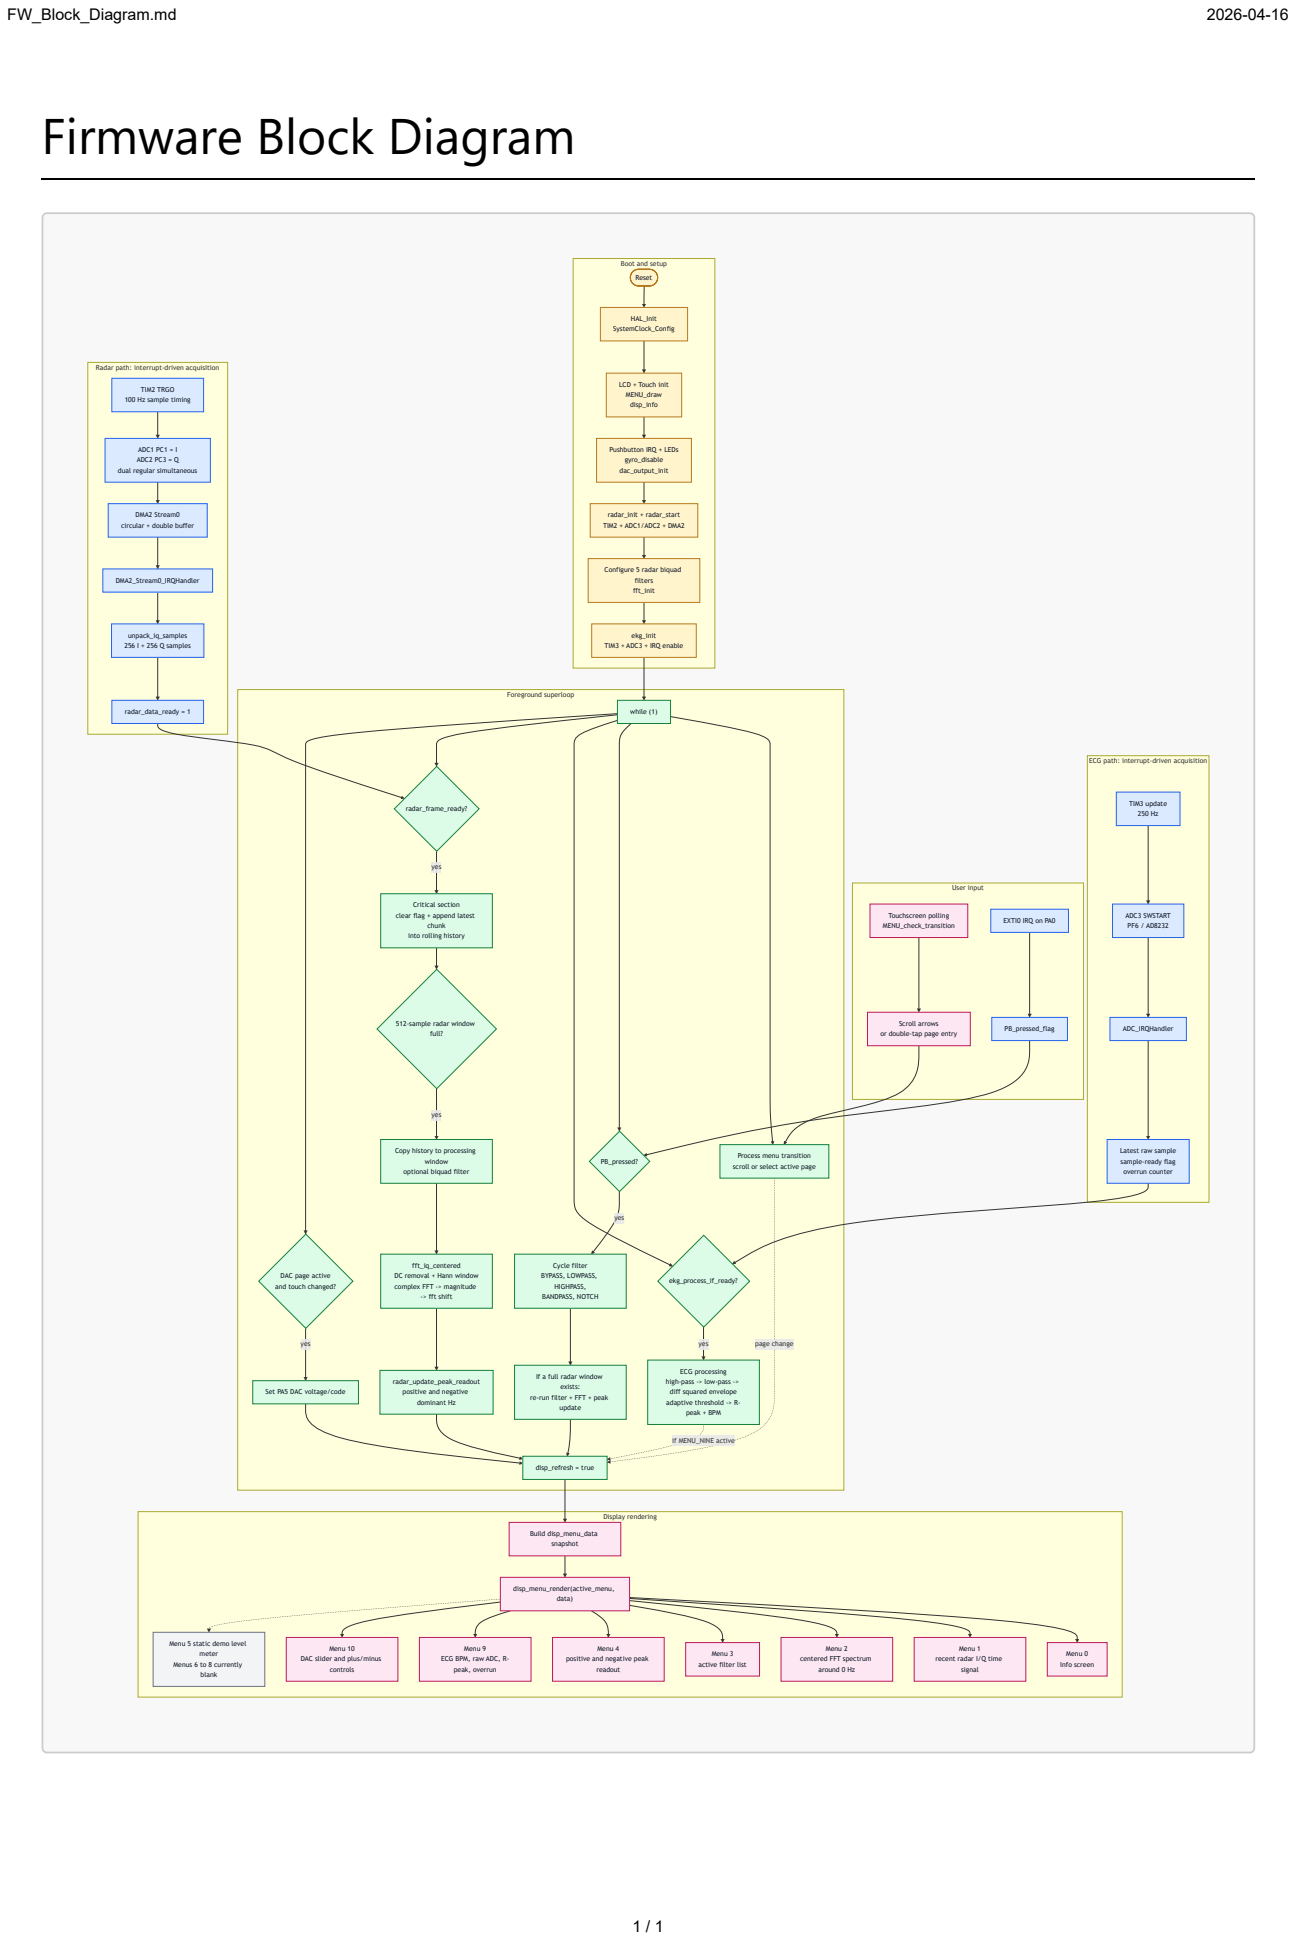
[picture p163: page 1]
Display rendering; Foreground superloop; User input; page change; yes; if MENU_NINE active; HAL_Init SystemClock_Config; disp_info; radar_init + radar_start TIM2 + ADC1/ADC2 + DMA2; fft_init; ekg_init TIM3 + ADC3 + IRQ enable; ADC1 PC1 = I ADC2 PC3 = Q; DMA2_Stream0_IRQHandler; unpack_iq_samples 256 I + 256 Q samples; radar_data_ready = 1; TIM3 update 250 Hz; ADC3 SWSTART PF6 / AD8232; ADC_IRQHandler; Touchscreen polling MENU_check_transition; EXTI0 IRQ on PA0; PB_pressed_flag; while (1)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

Boot and setup
Reset

Radar path: interrupt-driven acquisition

TIM2 TRGO
100 Hz sample timing

LCD + Touch init MENU_draw

Pushbutton IRQ + LEDs gyro_disable dac_output_init

dual regular simultaneous

DMA2 Stream0
circular + double buffer

Configure 5 radar biquad filters

ECG path: interrupt-driven acquisition

Critical section
clear flag + append latest chunk

into rolling history

512-sample radar window full?

Scroll arrows or double-tap page entry

Copy history to processing window

scroll or select active page PB_pressed?

Process menu transition

Latest raw sample
sample-ready flag overrun counter

optional biquad filter

DAC page active
and touch changed?

fft_iq_centered DC removal + Hann window

Cycle filter BYPASS, LOWPASS, HIGHPASS, BANDPASS, NOTCH

complex FFT -> magnitude -> fft shift

radar_update_peak_readout positive and negative dominant Hz

If a full radar window exists: re-run filter + FFT + peak update

ECG processing high-pass -> low-pass -> diff squared envelope

Set PA5 DAC voltage/code

adaptive threshold -> R- peak + BPM

Menu 5 static demo level meter Menus 6 to 8 currently blank

Menu 10 DAC slider and plus/minus controls

Menu 9 ECG BPM, raw ADC, R- peak, overrun

Menu 4 positive and negative peak readout

Menu 3 active filter list

Menu 1
recent radar I/Q time signal

centered FFT spectrum around 0 Hz
