Tommy270502/PM4/3_Hardware/6_Analog_Signal_Processing/Draft12.asc

C1: cap; 1n
C2: cap; 100n
C3: cap; 100n
R1: res; 160
R2: res; 1Meg
U1: UniversalOpAmp
V1: voltage; 1.65
V2: voltage; 5
V3: voltage; SINE(0 1); AC 1
Named nets: 0, +5V, VREF, Vout2, Vout1, Vin
.ac dec 10 1 1meg
.tran 0 1 0 0.000001 startup
