Tommy270502/PM4/3_Hardware/6_Analog_Signal_Processing/Draft10.asc

C1: cap; 10; V=27 Rser=0.2
Q1: pnp
Q2: pnp
R1: res; 1
R2: res; 1k
R3: res; 1k
V1: voltage; 20
Named nets: 0, VCAP, VIN
.tran 0 10 0 0.001
