Tommy270502/PM4/3_Hardware/6_Analog_Signal_Processing/Draft11.asc

C1: cap; 1µ
R1: res; 10k
R2: res; 10k
R3: res; 10k
U1: UniversalOpAmp
V1: voltage; PULSE(0 5 0.1 0.001 0.001 10 11)
Named nets: 0, +5V
.tran 0 10 0 0.001
