Tommy270502/PM4/3_Hardware/6_Analog_Signal_Processing/Draft6.asc

C1: cap; 20µ
M1: pmos; AO6407
M2: pmos; AO6407
R1: res; 10k
R2: res; 10k
R3: res; 1k
V1: voltage; PULSE(0 5 0.1 0.01 0.01 0.05 0.1 5)
V2: voltage; 4.2
Named nets: 0, VBAT, VSYS, VUSB
.tran 0 5 0 0.0001
