Tommy270502/PM4/3_Hardware/6_Analog_Signal_Processing/Draft7.asc

C1: cap; 100n
R1: res; 10k
R2: res; 10k
R3: res; 10k
R4: res; 10k
R5: res; 10k
R6: res; 11k
R7: res; 13k
U1: UniversalOpAmp
U2: OP492
V1: voltage; 5
V2: voltage; 2.7
V3: voltage; PULSE(0 0.1 0.1 0.001 0.001 0.1 0.2 5)
V4: voltage; 2.7
Named nets: 0, VCC, VC1, VC2, VOUT, VREF
.tran 0 2 0 0.01
