Tommy270502/PM4/3_Hardware/6_Analog_Signal_Processing/Draft8.asc

M1: pmos; FDC5614P
Q1: pnp; 2N2907
Q2: pnp; 2N2907
R1: res; 1k
R2: res; 1k
R3: res; 10
V1: voltage; 27
Named nets: 0
