Tommy270502/PM4/3_Hardware/6_Analog_Signal_Processing/Draft9.asc

C1: cap; 10; V=27
L1: ind; 47µ; Rser=100m
V1: voltage; PULSE(0 20 0.5 0.0001 0.0001 5 10)
Named nets: 0
.tran 0 10 0 0.001
