Tommy270502/PM4/3_Hardware/6_Analog_Signal_Processing/_IF_amp_PCB.asc

C1: cap; 10µ
C3: cap; 100µ
C4: cap; 4n7
C5: cap; 100µ
C6: cap; 10µ
R1: res; 100k
R2: res; 1Meg
R3: res; 10k
R4: res; 100k
R5: res; 10k
R6: res; 1k
R7: res; 10k
U1: UniversalOpAmp2
U2: 1N4148
U3: UniversalOpAmp2
V1: voltage; SINE(0.2 50u 2); AC 1
V2: voltage; 5
V3: voltage; 1.65
Named nets: 0, out, sig, VCC, Vref
.ac dec 1000 0.001 1000
.tran 0 10 5 0.00001
