Tommy270502/PM4/3_Hardware/6_Analog_Signal_Processing/_VCO_amp_PCB.asc

C1: cap; 100n
R1: res; 100k
R2: res; 1k
R3: res; 10k
U2: UniversalOpamp2
V1: voltage; SINE(1.5 1.5 100)
V2: voltage; 3.3
Named nets: 0, VCC, VCO, DAC
.tran 0 100m 1m 1m
