Tommy270502/PM4/3_Hardware/6_Analog_Signal_Processing/IF_amp_V5_eand.asc

C1: cap; 10µ
C2: cap; 10n
C3: cap; 100µ
C5: cap; 100µ
C6: cap; 100µ
C7: cap; 10µ
C12: cap; 10n
R1: res; 100k
R2: res; 1Meg
R3: res; 10k
R4: res; 1Meg
R5: res; 10k
R6: res; 10k
R7: res; 10k
R8: res; 1k
R9: res; 10k
U1: UniversalOpAmp; Avol=3.16e5 GBW=2Meg Vos=3e-3; En=20e-9 Enk=346e-9 In=3e-15 Ink=0 Rin=500Meg
U3: UniversalOpAmp; Avol=3.16e5 GBW=2Meg Vos=3e-3; En=20e-9 Enk=346e-9 In=3e-15 Ink=0 Rin=500Meg
V1: voltage; SINE(0.2 64u 2); AC 1
V2: voltage; 3.3
Named nets: 0, VCC, vref, sig, I_out
.ac dec 100 0.001 10meg
.tran 10
