Tommy270502/PM4/3_Hardware/6_Analog_Signal_Processing/IF_amp_V5.asc

C1: cap; 10µ
C2: cap; 47n
C3: cap; 100µ
C4: cap; 47n
C5: cap; 100µ
R1: res; 16k
R2: res; 200k
R3: res; 20k
R4: res; 200k
R5: res; 20k
U1: UniversalOpAmp2
U2: UniversalOpAmp2
U3: UniversalOpAmp2
V1: voltage; SINE(0.2 64u 2); AC 1
V2: voltage; 5
Named nets: 0, VCC, vref, sig
.ac dec 1000 0.001 1000
.tran 0 10 5 0.00001
