Tommy270502/PM4/3_Hardware/6_Analog_Signal_Processing/Draft4.asc

C1: cap; 10µ
C2: cap; 100µ
C3: cap; 10µ
C4: cap; 100µ
C5: cap; 10µ
R1: res; 16k
R2: res; 68k
R3: res; 33k
R4: res; 50k
R5: res; 1k
R6: res; 50k
R7: res; 1k
U1: UniversalOpAmp2
U2: UniversalOpAmp2
U3: UniversalOpAmp2
V1: voltage; 5
V2: voltage; ""; AC 1
Named nets: 0, VCC, sig, vref
.tran 0 10 5 0.00001
.ac dec 1000 0.01 100
