Tommy270502/PM4/3_Hardware/6_Analog_Signal_Processing/Draft2.asc

C1: cap; 3.3µ
C2: cap; 10µ
C3: cap; 1µ
C4: cap; 1µ
R1: res; 100k
R2: res; 68k
R3: res; 33k
R4: res; 1k
R5: res; 19k
R6: res; 16k
R7: res; 1k
R8: res; 19k
R9: res; 16k
U1: UniversalOpAmp2
U2: UniversalOpAmp2
U3: UniversalOpAmp2
V1: voltage; 5
V2: voltage; SINE(0.2 32u 2)
Named nets: 0, VCC
.tran 0 2 0.1 0.00001
