Tommy270502/PM4/3_Hardware/6_Analog_Signal_Processing/Draft3.asc

C1: cap; 3.3µ
C2: cap; 3.3µ
C3: cap; 10µ
C4: cap; 1µ
C5: cap; 1µ
R1: res; 100k
R2: res; 1k
R3: res; 750
R4: res; 100k
R5: res; 68k
R6: res; 33k
R7: res; 16k
R8: res; 1k
R9: res; 750
R10: res; 16k
R11: res; 49k
R12: res; 1k
U1: UniversalOpAmp2
U2: UniversalOpAmp2
U3: UniversalOpAmp2
U4: UniversalOpAmp2
V1: voltage; 5
V2: voltage; ""; AC 1
Named nets: 0, VCC, Sig, Vref
.tran 0 10 5 0.00001
.ac dec 1000 0.01 1000
