Tommy270502/PM4/3_Hardware/6_Analog_Signal_Processing/Draft1.asc

C1: cap; 10µ
C2: cap; 1µ
C3: cap; 1µ
C4: cap; 1µ
R1: res; 19k
R2: res; 14k
R3: res; 1k
R4: res; 1k
R5: res; 16k
R6: res; 19k
R7: res; 240k
R8: res; 10k
R9: res; 9k
R10: res; 1k
R11: res; 1k
R12: res; 330k
R13: res; 330k
U1: UniversalOpAmp2
U2: UniversalOpAmp2
U3: UniversalOpAmp2
U4: UniversalOpAmp2
V1: voltage; 5
V2: voltage; SINE(0.2 32u 3)
Named nets: 0, VCC
.tran 0 1 0.1 0.00001
