Tommy270502/PM4/3_Hardware/6_Analog_Signal_Processing/VCO_amp.asc

C1: cap; 100p
R1: res; 1.591k
R2: res; 1k
R3: res; 10k
U1: AD744
V1: voltage; SINE(1.5 1.5 100)
V2: voltage; 5
V3: voltage; 5
Named nets: 0, VCC, DAC, VCO, VSS
fg = 1 MHz = 1/(2*pi*R*C)
.tran 0 100m 1m 1m
