Tommy270502/PM4/3_Hardware/5_Spice_Models/MCP6271_example.asc

C2: cap; 4.7µ
C3: cap; 4.7µ
R1: res; 10k
R2: res; 330k
R5: res; 100
R6: res; 100
U1: UniversalOpAmp; Avol=3.16e5 GBW=2Meg Vos=3e-3; En=20e-9 Enk=346e-9 In=3e-15 Ib=1e-12 Rin=500Meg
V1: voltage; SINE(0 1e-3 1e3); AC 1 0; Rser=0 Cpar=0
V2: voltage; 3.3; Rser=0
Named nets: 0
#.ac dec 1000 1 1meg
.TRAN 1u 10m
