Tommy270502/PM4/3_Hardware/1_HW_template_2026_02_11_v10/HW_template.kicad_pcb

## KiCad design 3_Hardware/1_HW_template_2026_02_11_v10/HW_template.kicad_pcb (2026-05-21)

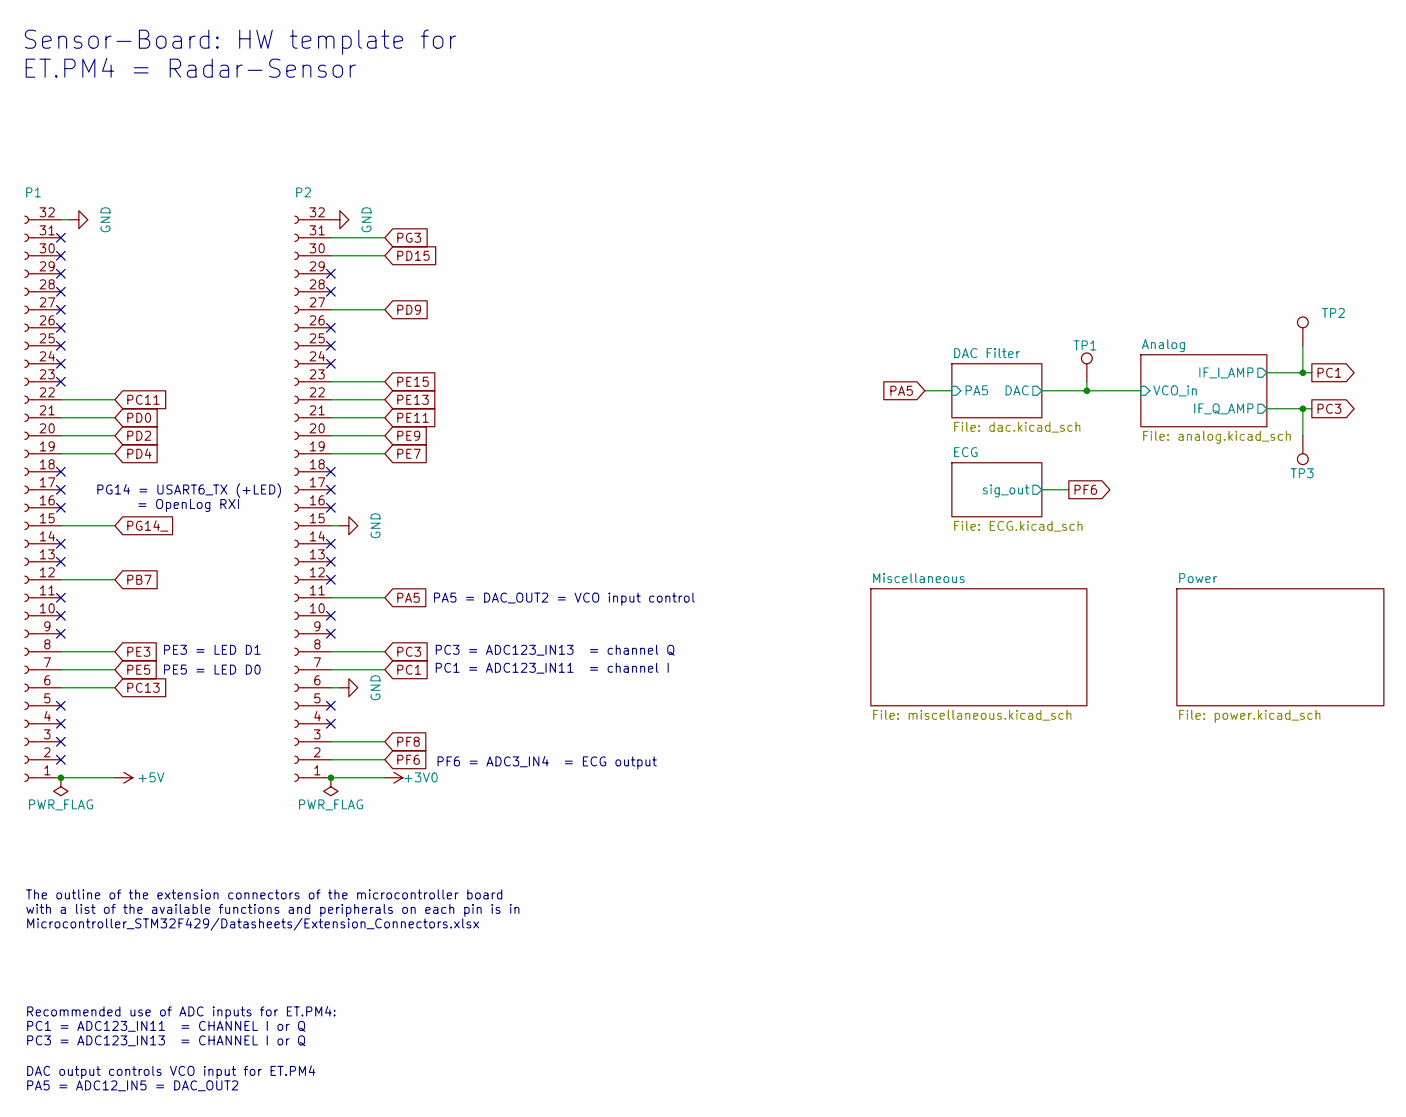
[picture p166: schematic HW_template.kicad_sch, Sensor-Board: HW template for ET.PM3 and ET.PM4]

Parts:
P1, P2: Conn_01x32_Female; PinSocket_1x32_P2.54mm_Vertical
TP1, TP2, TP3: TestPoint_Loop_D2.60mm_Drill1.6mm_Beaded

Connections:
+3V0: P2.1
+5V: P1.1; also elsewhere on the board
/Analog/VCO_in: TP1.1; also elsewhere on the board
GND: P1.32, P2.6, P2.15, P2.32; also elsewhere on the board
PA5: P2.11; also elsewhere on the board
PB7: P1.12
PC1: P2.7, TP2.1; also elsewhere on the board
PC3: P2.8, TP3.1; also elsewhere on the board
PC11: P1.22
PC13: P1.6
PD0: P1.21
PD2: P1.20
PD4: P1.19
PD9: P2.27
PD15: P2.30
PE3: P1.8; also elsewhere on the board
PE5: P1.7; also elsewhere on the board
PE7: P2.19
PE9: P2.20
PE11: P2.21
PE13: P2.22
PE15: P2.23
PF6: P2.2; also elsewhere on the board
PF8: P2.3
PG3: P2.31
PG14_: P1.15; also elsewhere on the board

Notes on the sheet:
The outline of the extension connectors of the microcontroller board with a list of the available functions and peripherals on each pin is in Microcontroller_STM32F429/Datasheets/Extension_Connectors.xlsx
PA5 = DAC_OUT2 = VCO input control
PG14 = USART6_TX (+LED) = OpenLog RXI
PC3 = ADC123_IN13 = channel Q
DAC output controls VCO input for ET.PM4 PA5 = ADC12_IN5 = DAC_OUT2
PF6 = ADC3_IN4 = ECG output
PE5 = LED D0
Recommended use of ADC inputs for ET.PM4: PC1 = ADC123_IN11 = CHANNEL I or Q PC3 = ADC123_IN13 = CHANNEL I or Q
PC1 = ADC123_IN11 = channel I
Sensor-Board: HW template for ET.PM4 = Radar-Sensor
PE3 = LED D1

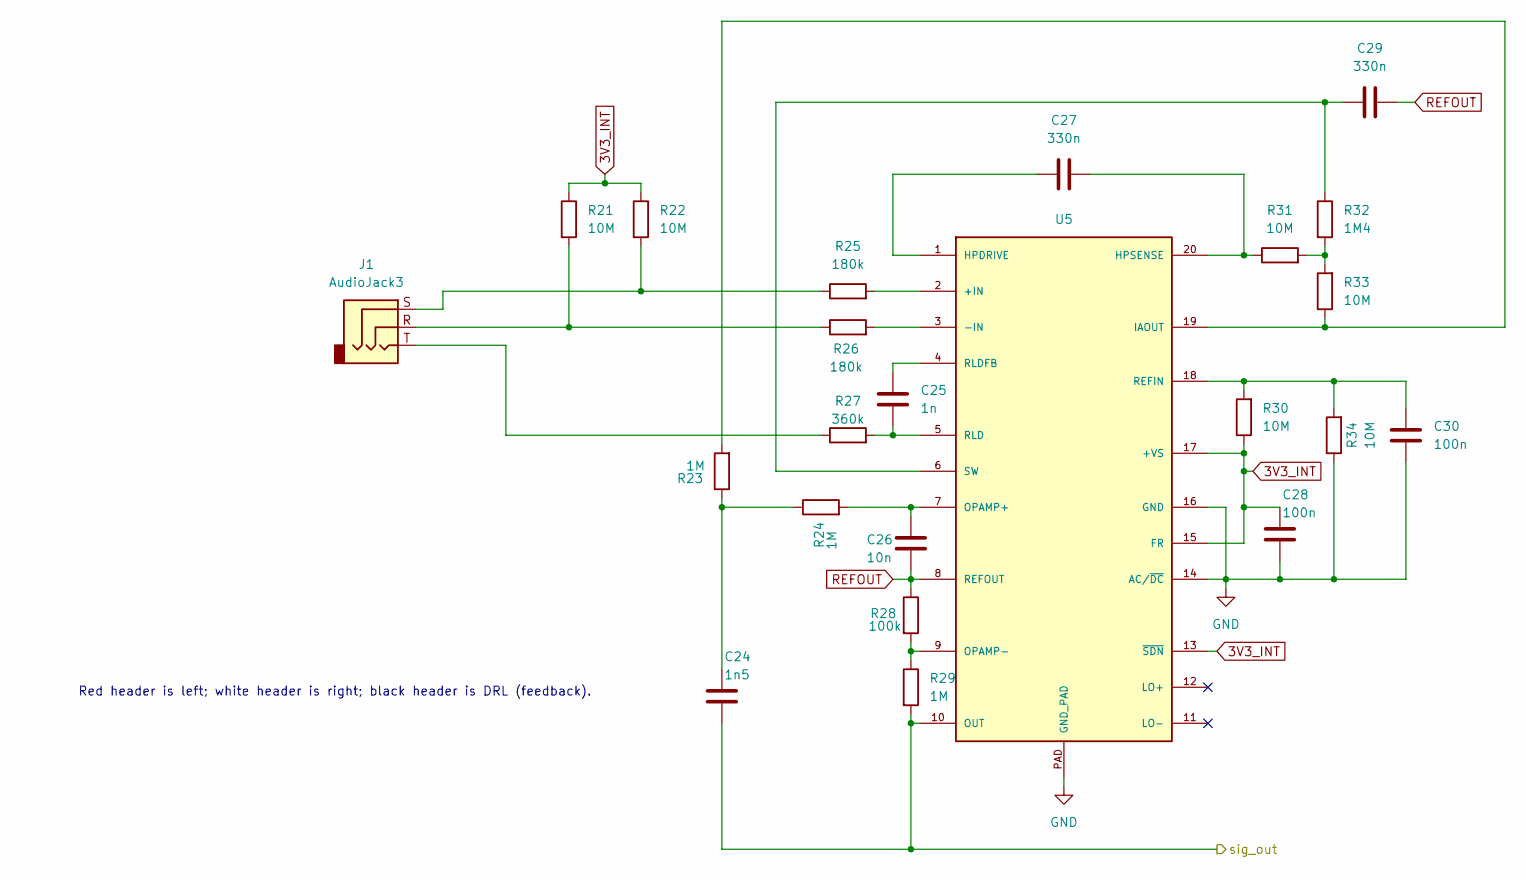
[picture p167: schematic ECG.kicad_sch]

Parts:
C24: 1n5; C_0603_1608Metric_Pad1.08x0.95mm_HandSolder
C25: 1n; C_0603_1608Metric_Pad1.08x0.95mm_HandSolder
C26: 10n; C_0603_1608Metric_Pad1.08x0.95mm_HandSolder
C27, C29: 330n; C_0603_1608Metric_Pad1.08x0.95mm_HandSolder
C28, C30: 100n; C_0603_1608Metric_Pad1.08x0.95mm_HandSolder
J1: AudioJack3; Jack_3.5mm_CUI_SJ-3523-SMT_Horizontal
R21, R22, R30, R31, R33, R34: 10M; R_0603_1608Metric_Pad0.98x0.95mm_HandSolder
R23, R24, R29: 1M; R_0603_1608Metric_Pad0.98x0.95mm_HandSolder
R25, R26: 180k; R_0603_1608Metric_Pad0.98x0.95mm_HandSolder
R27: 360k; R_0603_1608Metric_Pad0.98x0.95mm_HandSolder
R28: 100k; R_0603_1608Metric_Pad0.98x0.95mm_HandSolder
R32: 1M4; R_0603_1608Metric_Pad0.98x0.95mm_HandSolder
U5: AD8232ACPZ-R7; LFCSP_20

Connections:
3V3_INT: C28.2, R21.1, R22.1, R30.1, U5.13 (~SDN), U5.15 (FR), U5.17 (+VS); also elsewhere on the board
GND: C28.1, C30.1, R34.1, U5.14 (AC/~DC), U5.16 (GND), U5.PAD (GND_PAD); also elsewhere on the board
unnamed: C24.2, R23.1, R24.1
unnamed: J1.R, R21.2, R26.1
unnamed: J1.S, R22.2, R25.1
unnamed: J1.T, R27.1
unnamed: R31.2, R32.2, R33.2
unnamed: R25.2, U5.2 (+IN)
unnamed: R26.2, U5.3 (-IN)
unnamed: C27.1, U5.1 (HPDRIVE)
unnamed: C27.2, R31.1, U5.20 (HPSENSE)
unnamed: R23.2, R33.1, U5.19 (IAOUT)
unnamed: C26.2, R24.2, U5.7 (OPAMP+)
unnamed: R28.2, R29.1, U5.9 (OPAMP-)
unnamed: C30.2, R30.2, R34.2, U5.18 (REFIN)
unnamed: C25.2, R27.2, U5.5 (RLD)
unnamed: C25.1, U5.4 (RLDFB)
unnamed: C29.1, R32.1, U5.6 (SW)
PF6: C24.1, R29.2, U5.10 (OUT); also elsewhere on the board
REFOUT: C26.1, C29.2, R28.1, U5.8 (REFOUT)

Notes on the sheet:
Red header is left; white header is right; black header is DRL (feedback).

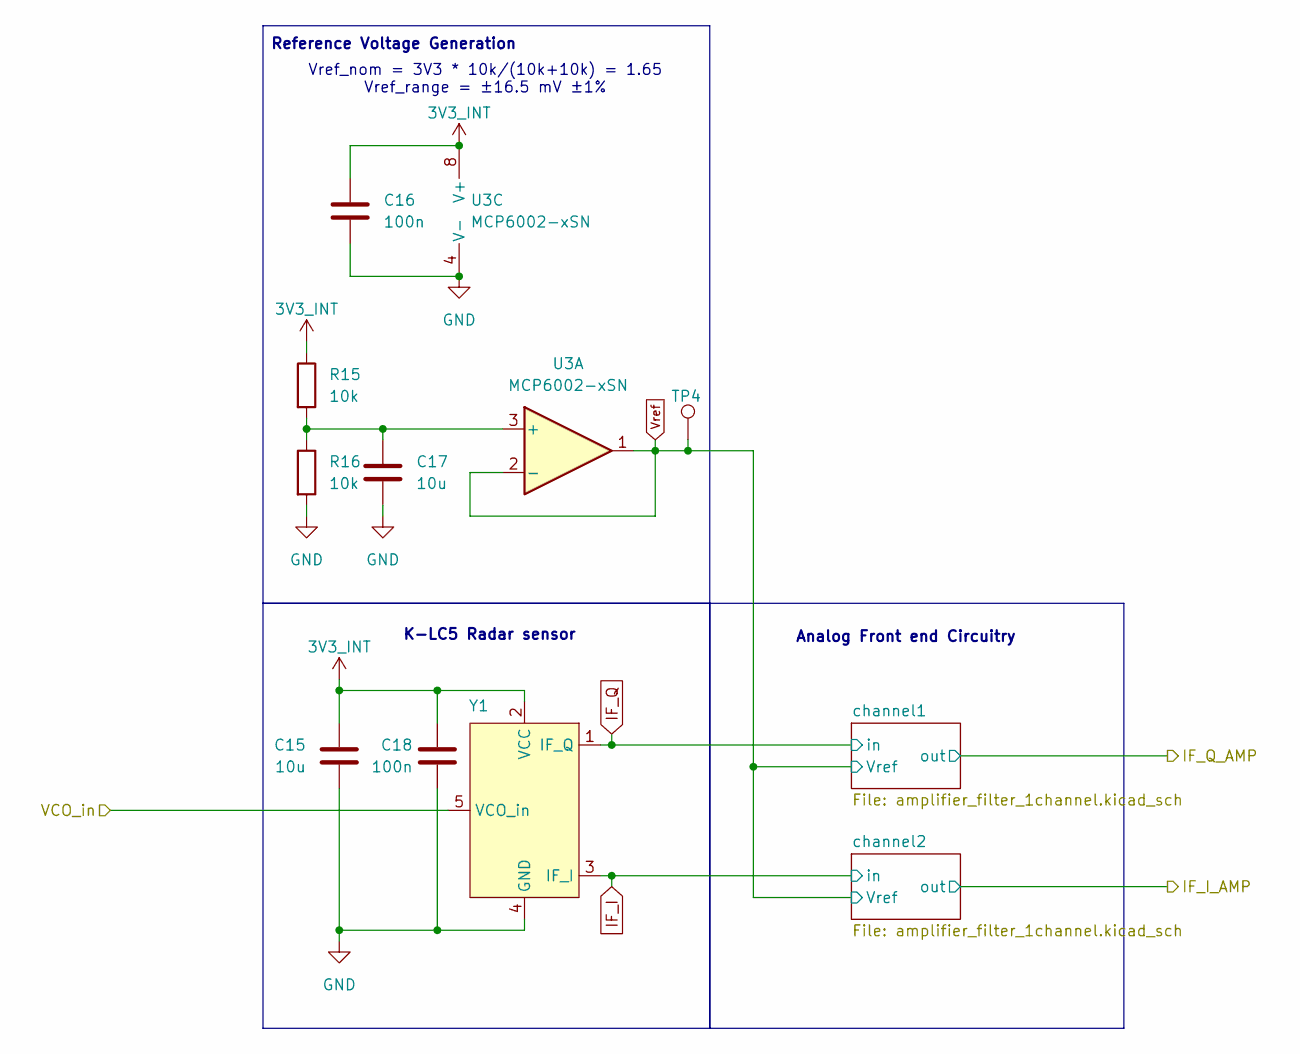
[picture p168: schematic analog.kicad_sch]

Parts:
C15, C17: 10u; C_0603_1608Metric_Pad1.08x0.95mm_HandSolder
C16, C18: 100n; C_0603_1608Metric_Pad1.08x0.95mm_HandSolder
R15, R16: 10k; R_0603_1608Metric_Pad0.98x0.95mm_HandSolder
TP4: TestPoint_Loop_D2.60mm_Drill1.6mm_Beaded
U3: MCP6002-xSN; SOIC-8_3.9x4.9mm_P1.27mm
Y1: Radar K-LC5-RFB-00C; Radar_K-LC5

Connections:
3V3_INT: C15.1, C16.1, C18.1, R15.1, U3.8 (V+), Y1.2 (VCC); also elsewhere on the board
/Analog/VCO_in: Y1.5 (VCO_in); also elsewhere on the board
GND: C15.2, C16.2, C17.2, C18.2, R16.2, U3.4 (V-), Y1.4 (GND); also elsewhere on the board
IF_I: Y1.3 (IF_I); also elsewhere on the board
IF_Q: Y1.1 (IF_Q); also elsewhere on the board
unnamed: C17.1, R15.2, R16.1, U3.3 (+)
Vref: TP4.1, U3.1, U3.2 (-); also elsewhere on the board

Notes on the sheet:
Analog Front end Circuitry
Reference Voltage Generation
K-LC5 Radar sensor
Vref_nom = 3V3 * 10k/(10k+10k) = 1.65 Vref_range = ±16.5 mV ±1%

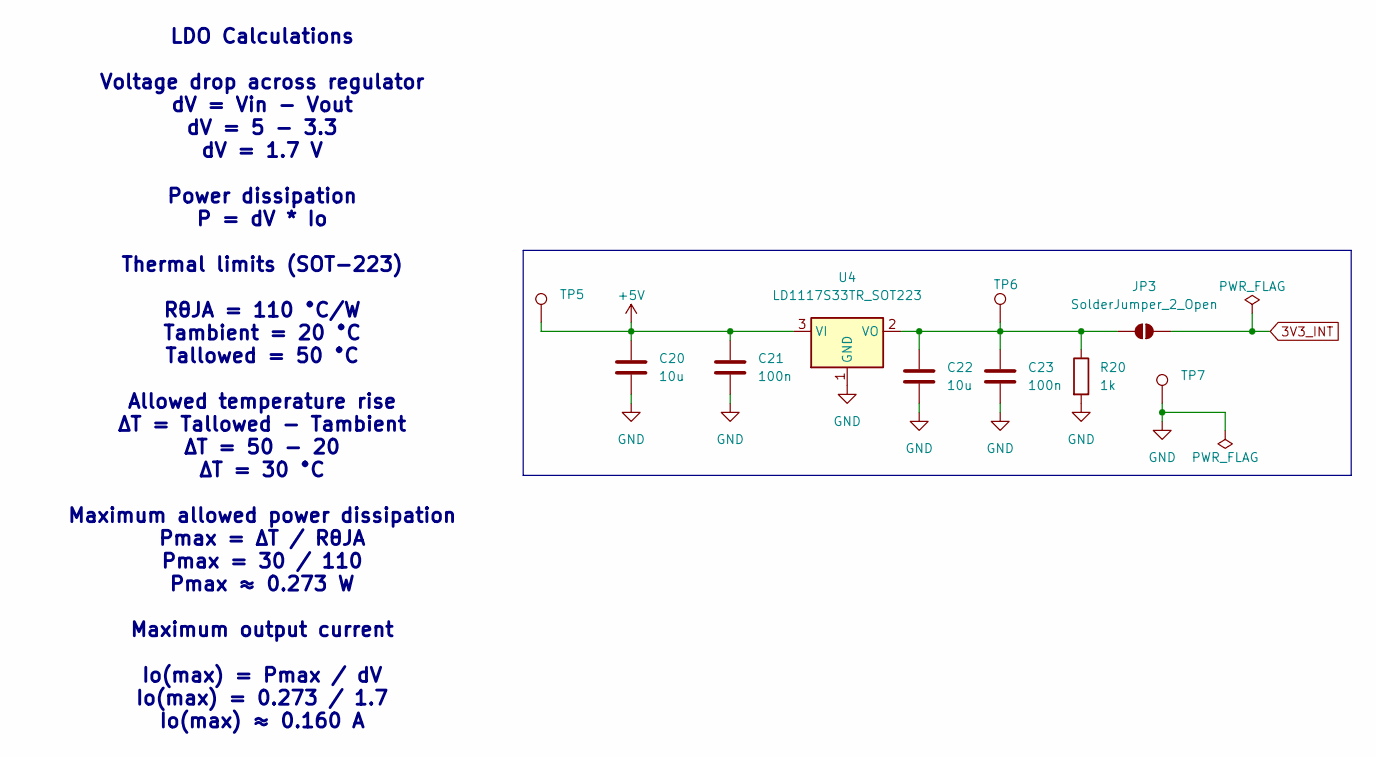
[picture p169: schematic power.kicad_sch]

Parts:
C20, C22: 10u; C_0805_2012Metric_Pad1.18x1.45mm_HandSolder
C21, C23: 100n; C_0805_2012Metric_Pad1.18x1.45mm_HandSolder
JP3: SolderJumper_2_Open; SolderJumper-2_P1.3mm_Open_RoundedPad1.0x1.5mm
R20: 1k; R_0805_2012Metric_Pad1.20x1.40mm_HandSolder
TP5, TP6, TP7: TestPoint_Loop_D2.60mm_Drill1.6mm_Beaded
U4: LD1117S33TR_SOT223; SOT-223-3_TabPin2

Connections:
3V3_INT: JP3.2 (B); also elsewhere on the board
+5V: C20.1, C21.1, TP5.1, U4.3 (VI); also elsewhere on the board
GND: C20.2, C21.2, C22.2, C23.2, R20.2, TP7.1, U4.1 (GND); also elsewhere on the board
unnamed: C22.1, C23.1, JP3.1 (A), R20.1, TP6.1, U4.2 (VO)

Notes on the sheet:
LDO Calculations Voltage drop across regulator dV = Vin - Vout dV = 5 - 3.3 dV = 1.7 V Power dissipation P = dV * Io Thermal limits (SOT-223) RθJA = 110 °C/W Tambient = 20 °C Tallowed = 50 °C Allowed temperature rise ΔT = Tallowed - Tambient ΔT = 50 - 20 ΔT = 30 °C Maximum allowed power dissipation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

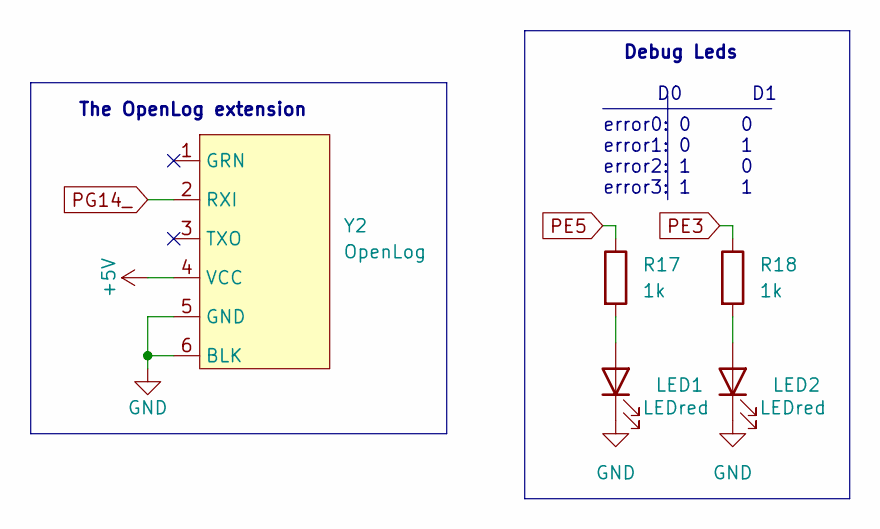
[picture p170: schematic miscellaneous.kicad_sch]

Parts:
LED1, LED2: LEDred; LED_0603_1608Metric_Pad1.05x0.95mm_HandSolder
R17, R18: 1k; R_0603_1608Metric_Pad0.98x0.95mm_HandSolder
Y2: OpenLog; PinSocket_1x06_P2.54mm_Vertical

Connections:
+5V: Y2.4 (VCC); also elsewhere on the board
GND: LED1.1 (K), LED2.1 (K), Y2.5 (GND), Y2.6 (BLK); also elsewhere on the board
unnamed: LED1.2 (A), R17.2
unnamed: LED2.2 (A), R18.2
PE3: R18.1; also elsewhere on the board
PE5: R17.1; also elsewhere on the board
PG14_: Y2.2 (RXI); also elsewhere on the board

Notes on the sheet:
error0: 0 0 error1: 0 1 error2: 1 0 error3: 1 1
The OpenLog extension
D0 D1
Debug Leds

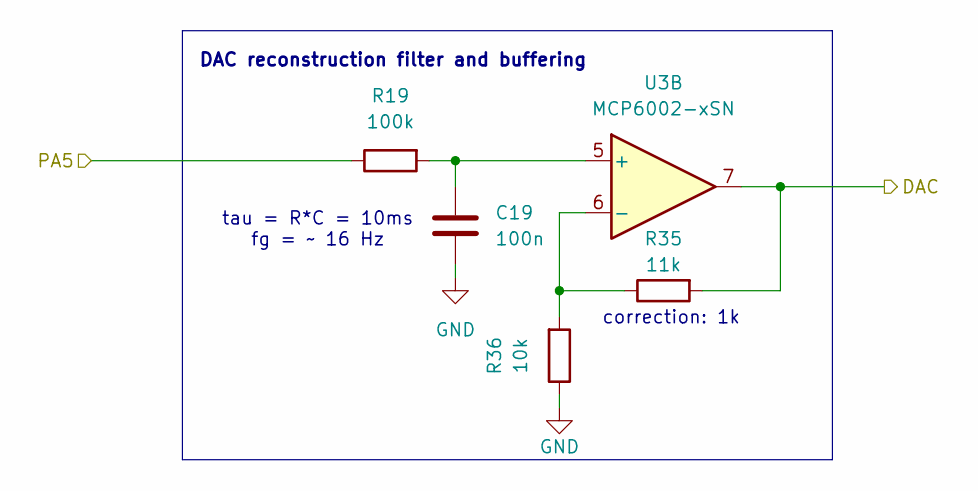
[picture p171: schematic dac.kicad_sch]

Parts:
C19: 100n; C_0603_1608Metric_Pad1.08x0.95mm_HandSolder
R19: 100k; R_0603_1608Metric_Pad0.98x0.95mm_HandSolder
R35: 11k; R_0603_1608Metric_Pad0.98x0.95mm_HandSolder
R36: 10k; R_0603_1608Metric_Pad0.98x0.95mm_HandSolder
U3: MCP6002-xSN; SOIC-8_3.9x4.9mm_P1.27mm

Connections:
/Analog/VCO_in: R35.2, U3.7; also elsewhere on the board
GND: C19.2, R36.1; also elsewhere on the board
unnamed: C19.1, R19.2, U3.5 (+)
unnamed: R35.1, R36.2, U3.6 (-)
PA5: R19.1; also elsewhere on the board

Notes on the sheet:
DAC reconstruction filter and buffering
correction: 1k
tau = R*C = 10ms fg = ~ 16 Hz

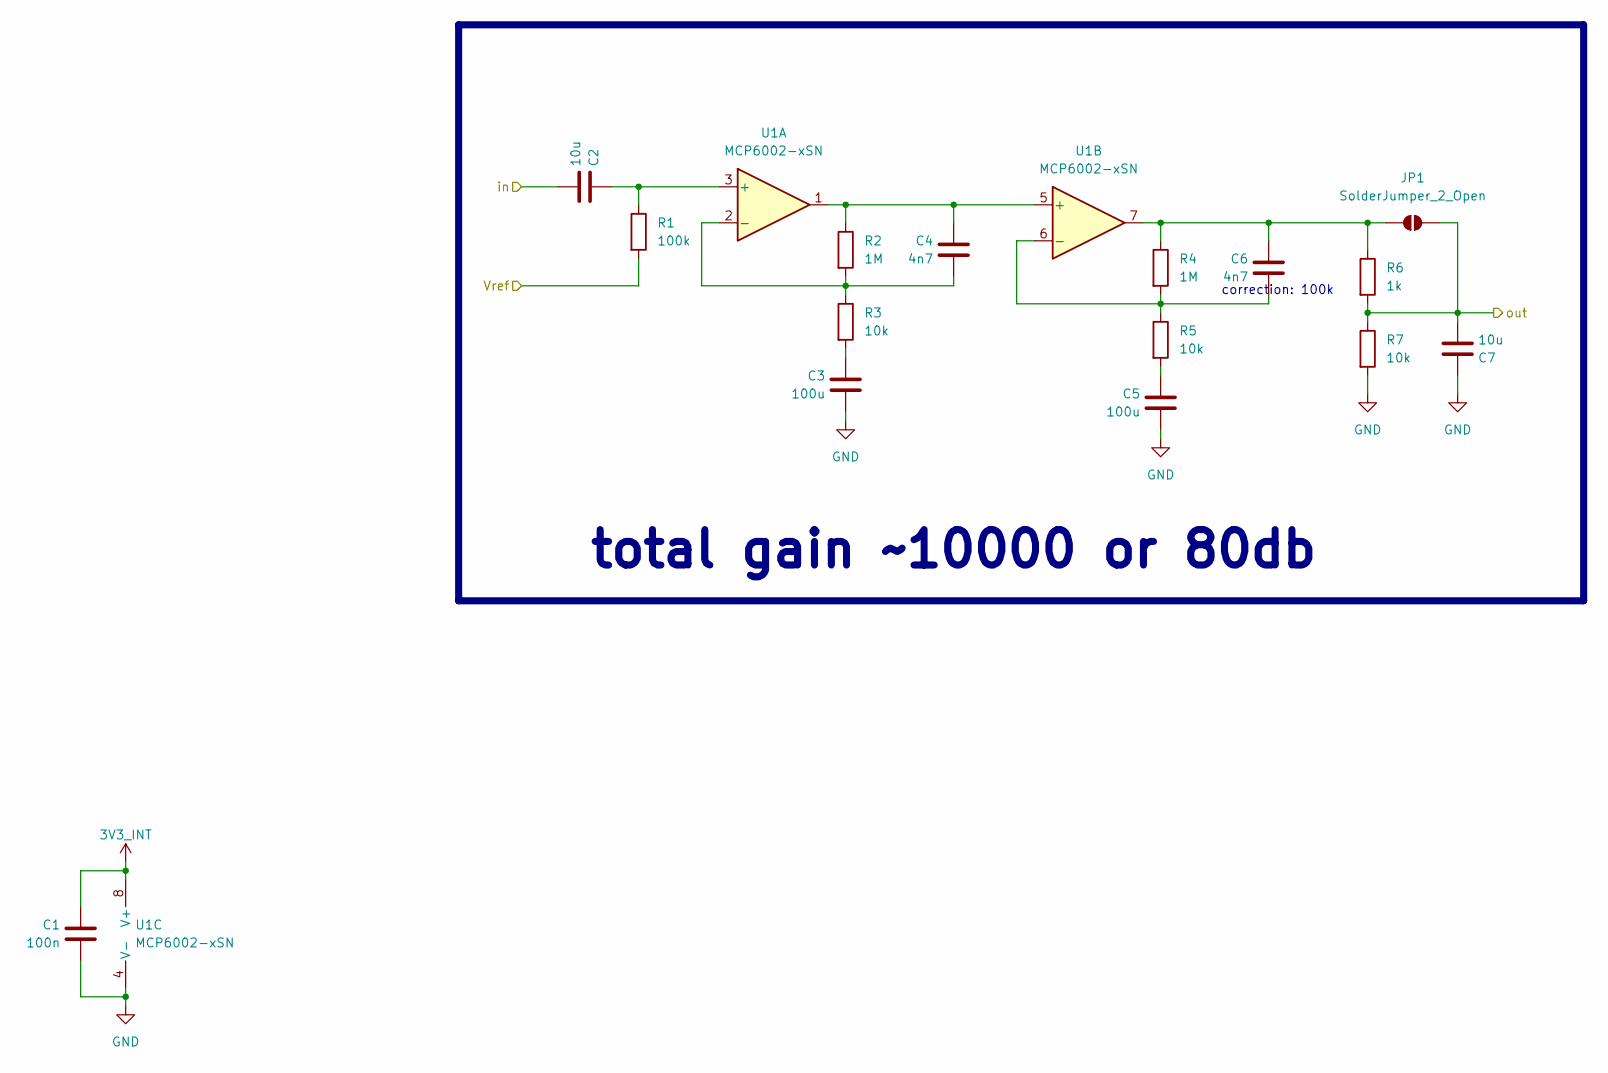
[picture p172: schematic amplifier_filter_1channel.kicad_sch, Amplifiers and Filters]

Parts:
C1: 100n; C_0603_1608Metric_Pad1.08x0.95mm_HandSolder
C2, C7: 10u; C_0603_1608Metric_Pad1.08x0.95mm_HandSolder
C3, C5: 100u; C_1206_3216Metric_Pad1.33x1.80mm_HandSolder
C4, C6: 4n7; C_0603_1608Metric_Pad1.08x0.95mm_HandSolder
JP1: SolderJumper_2_Open; SolderJumper-2_P1.3mm_Open_RoundedPad1.0x1.5mm
R1: 100k; R_0603_1608Metric_Pad0.98x0.95mm_HandSolder
R2, R4: 1M; R_0603_1608Metric_Pad0.98x0.95mm_HandSolder
R3, R5, R7: 10k; R_0603_1608Metric_Pad0.98x0.95mm_HandSolder
R6: 1k; R_0603_1608Metric_Pad0.98x0.95mm_HandSolder
U1: MCP6002-xSN; SOIC-8_3.9x4.9mm_P1.27mm

Connections:
3V3_INT: C1.1, U1.8 (V+); also elsewhere on the board
GND: C1.2, C3.2, C5.2, C7.1, R7.2, U1.4 (V-); also elsewhere on the board
IF_Q: C2.2; also elsewhere on the board
unnamed: C3.1, R3.2
unnamed: C5.1, R5.2
unnamed: C6.1, JP1.1 (A), R4.1, R6.1, U1.7
unnamed: C2.1, R1.1, U1.3 (+)
unnamed: C4.2, R2.2, R3.1, U1.2 (-)
unnamed: C4.1, R2.1, U1.1, U1.5 (+)
unnamed: C6.2, R4.2, R5.1, U1.6 (-)
PC3: C7.2, JP1.2 (B), R6.2, R7.1; also elsewhere on the board
Vref: R1.2; also elsewhere on the board

Parts of its further copies:
C8: 100n; C_0603_1608Metric_Pad1.08x0.95mm_HandSolder
C9, C14: 10u; C_0603_1608Metric_Pad1.08x0.95mm_HandSolder
C10, C12: 100u; C_1206_3216Metric_Pad1.33x1.80mm_HandSolder
C11, C13: 4n7; C_0603_1608Metric_Pad1.08x0.95mm_HandSolder
JP2: SolderJumper_2_Open; SolderJumper-2_P1.3mm_Open_RoundedPad1.0x1.5mm
R8: 100k; R_0603_1608Metric_Pad0.98x0.95mm_HandSolder
R9, R11: 1M; R_0603_1608Metric_Pad0.98x0.95mm_HandSolder
R10, R12, R14: 10k; R_0603_1608Metric_Pad0.98x0.95mm_HandSolder
R13: 1k; R_0603_1608Metric_Pad0.98x0.95mm_HandSolder
U2: MCP6002-xSN; SOIC-8_3.9x4.9mm_P1.27mm

Connections of its further copies:
3V3_INT: C8.1, U2.8 (V+); also elsewhere on the board
GND: C8.2, C10.2, C12.2, C14.1, R14.2, U2.4 (V-); also elsewhere on the board
IF_I: C9.2; also elsewhere on the board
unnamed: C10.1, R10.2
unnamed: C12.1, R12.2
unnamed: C13.1, JP2.1 (A), R11.1, R13.1, U2.7
unnamed: C9.1, R8.1, U2.3 (+)
unnamed: C11.2, R9.2, R10.1, U2.2 (-)
unnamed: C11.1, R9.1, U2.1, U2.5 (+)
unnamed: C13.2, R11.2, R12.1, U2.6 (-)
PC1: C14.2, JP2.2 (B), R13.2, R14.1; also elsewhere on the board
Vref: R8.2; also elsewhere on the board

Notes on the sheet:
correction: 100k
total gain ~10000 or 80db

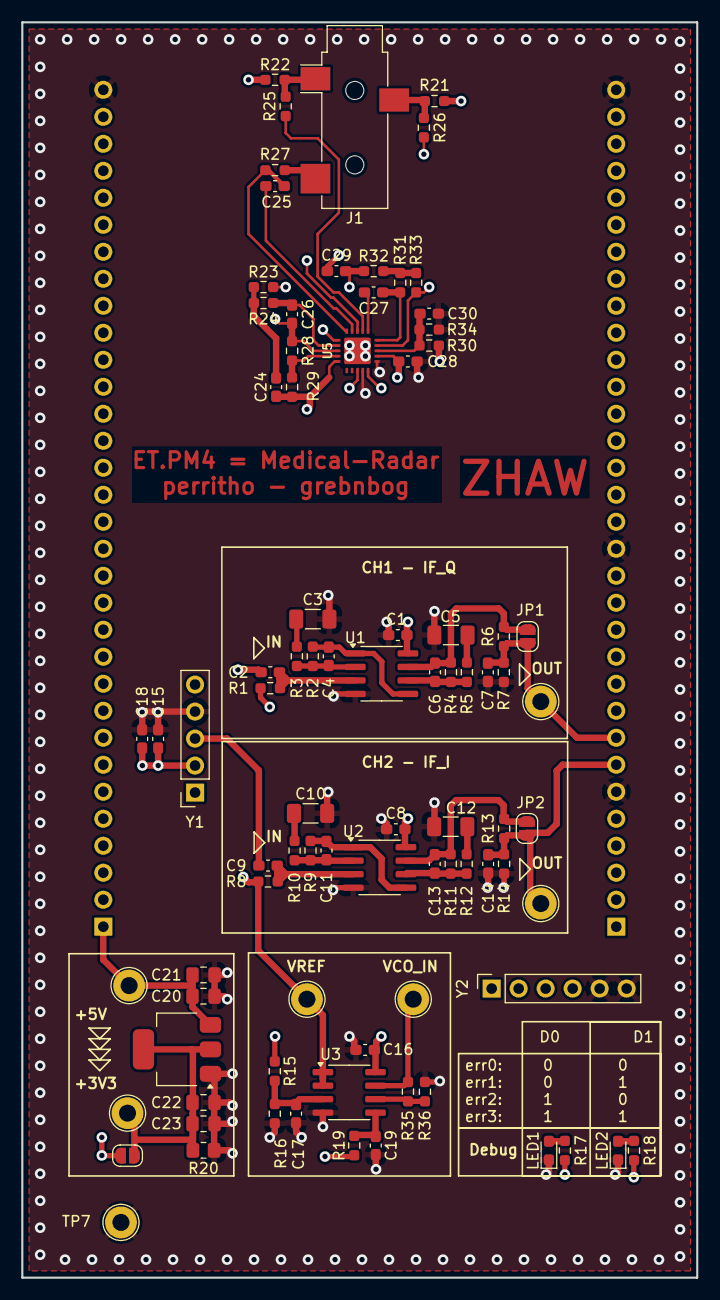
[picture p173: board HW_template.kicad_pcb from above]

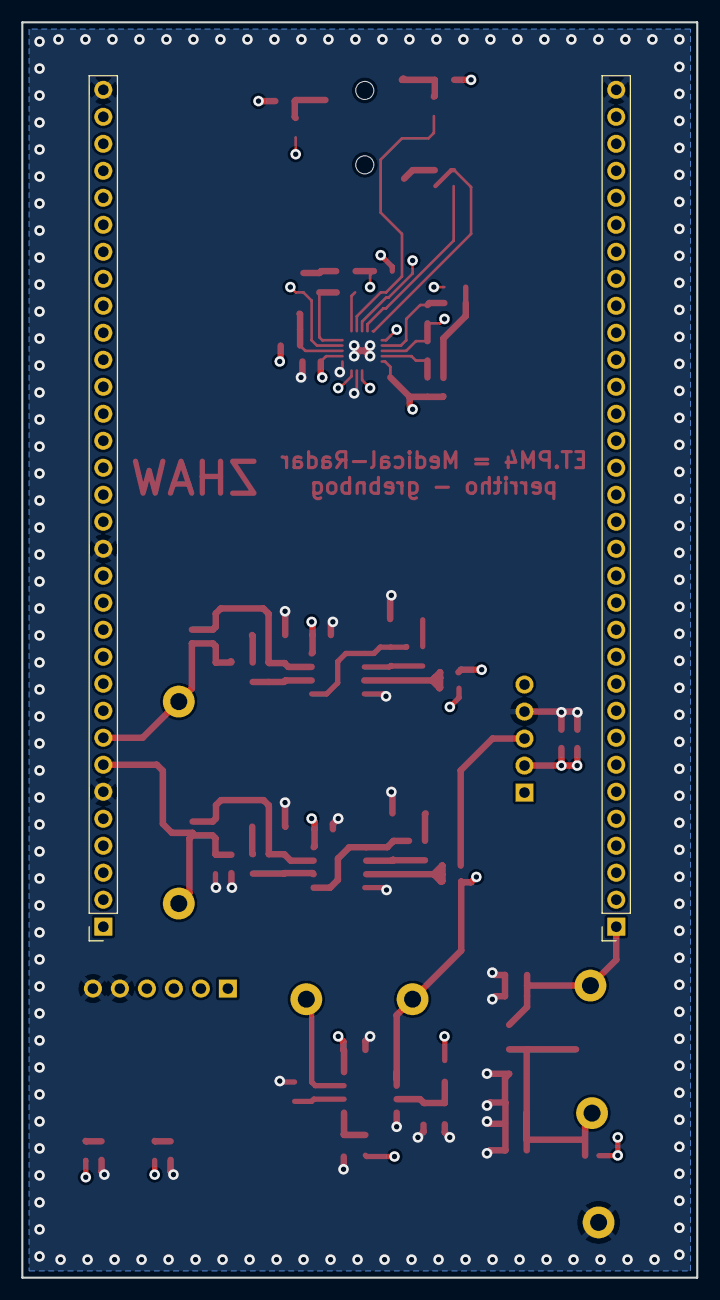
[picture p174: board HW_template.kicad_pcb from below]

Board: 4 copper layers, 63.5 x 118.1 mm, 88 parts (2 on the bottom side), 51 nets.
