Tommy270502/PM4/4_Firmware/Firmware/Core/Src/ekg.c

/**
 * @file ekg.c
 * @brief AD8232 acquisition and ECG signal processing on STM32F429
 * @author Thomas Perri, perritho@students.zhaw.ch
 * @date 2026-03-26
 */

#include "ekg.h"
#include "math_constants.h"

#include "stm32f4xx.h"

#if !defined(STM32F429xx)
#error "ekg.c is written for STM32F429xx: AD8232 OUT must be wired to PF6 / ADC3_IN4."
#endif

#define EKG_ADC_TIMEOUT_LOOPS    (1000000U)
#define EKG_WARMUP_SECONDS       (2U)
#define EKG_MIN_THRESHOLD        (1.0e-8f)
#define EKG_ADC_CHANNEL          (4U)
#define EKG_ADC_GPIO_PIN         (6U)
#define EKG_ADC_SAMPLE_TIME_BITS (5UL)   /* 84 ADC cycles on STM32F4. */
#define EKG_ADC_STABILIZE_LOOPS  (1000U)
#define EKG_ADC_MID_VOLTAGE      (0.5f * EKG_ADC_REF_VOLTAGE)
#define EKG_SAMPLE_QUEUE_SIZE    (64U)
#define EKG_SAMPLE_QUEUE_MASK    (EKG_SAMPLE_QUEUE_SIZE - 1U)

#if ((EKG_SAMPLE_QUEUE_SIZE & EKG_SAMPLE_QUEUE_MASK) != 0U)
#error "EKG_SAMPLE_QUEUE_SIZE must be a power of two."
#endif

const ekg_config_t EKG_CONFIG_DEFAULT = {
    .sample_rate_hz = EKG_DEFAULT_FS_HZ,
    .highpass_hz = EKG_DEFAULT_HP_HZ,
    .lowpass_hz = EKG_DEFAULT_LP_HZ,
    .envelope_hz = EKG_DEFAULT_ENV_HZ,
    .refractory_s = 0.250f,
    .min_rr_s = 0.300f,
    .max_rr_s = 2.000f
};

static ekg_config_t g_cfg = {
    .sample_rate_hz = EKG_DEFAULT_FS_HZ,
    .highpass_hz = EKG_DEFAULT_HP_HZ,
    .lowpass_hz = EKG_DEFAULT_LP_HZ,
    .envelope_hz = EKG_DEFAULT_ENV_HZ,
    .refractory_s = 0.250f,
    .min_rr_s = 0.300f,
    .max_rr_s = 2.000f
};

static uint8_t g_hw_initialized = 0U;
static volatile uint8_t g_sampling_enabled = 0U;

/* Interrupt-acquired sample queue and status flags. */
static volatile uint16_t g_irq_raw_queue[EKG_SAMPLE_QUEUE_SIZE];
static volatile uint32_t g_irq_sequence_queue[EKG_SAMPLE_QUEUE_SIZE];
static volatile uint32_t g_irq_queue_head = 0U;
static volatile uint32_t g_irq_queue_tail = 0U;
static volatile uint32_t g_irq_sample_sequence = 0U;
static volatile uint8_t g_irq_sample_ready = 0U;
static volatile uint32_t g_irq_overrun_count = 0U;

/* Optional first-order cleanup coefficients plus detector envelope LP. */
static float g_alpha_hp = 0.0f;
static float g_alpha_lp = 0.0f;
static float g_alpha_env = 0.0f;
static uint8_t g_hp_enabled = 0U;
static uint8_t g_lp_enabled = 0U;

/* Filter state. */
static float g_prev_x = 0.0f;
static float g_hp_y = 0.0f;
static float g_lp_y = 0.0f;
static float g_prev_lp = 0.0f;
static float g_env = 0.0f;

/* Adaptive detection state. */
static float g_noise_level = 1.0e-6f;
static float g_signal_level = 5.0e-6f;
static float g_threshold = 2.0e-6f;
static uint8_t g_candidate_active = 0U;
static float g_candidate_peak_env = 0.0f;
static uint32_t g_candidate_peak_sample = 0U;

/* Beat timing state. */
static uint32_t g_sample_index = 0U;
static uint32_t g_processing_origin_sequence = 0U;
static uint32_t g_last_accepted_peak = 0U;
static uint32_t g_refractory_samples = 1U;
static uint32_t g_min_rr_samples = 1U;
static uint32_t g_max_rr_samples = 1U;
static uint32_t g_warmup_samples = EKG_DEFAULT_FS_HZ * EKG_WARMUP_SECONDS;

static float g_latest_bpm = 0.0f;
static uint8_t g_bpm_valid = 0U;

static uint8_t ekg_get_next_irq_sample(uint16_t *raw, uint32_t *sequence);
static void ekg_process_raw_at_index(uint16_t raw, uint32_t sample_index,
                                     ekg_output_t *out);

static float clampf(float value, float lo, float hi)
{
    if (value < lo)
    {
        return lo;
    }
    if (value > hi)
    {
        return hi;
    }
    return value;
}

static void ekg_adc_wait_stable(void)
{
    volatile uint32_t wait = EKG_ADC_STABILIZE_LOOPS;

    while (wait > 0U)
    {
        __NOP();
        wait--;
    }
}

static void ekg_timer3_set_rate(uint32_t sample_rate_hz)
{
    uint32_t ticks_per_sample;

    if (sample_rate_hz == 0U)
    {
        sample_rate_hz = EKG_DEFAULT_FS_HZ;
    }

    ticks_per_sample = (BOARD_TIM_APB1_TICK_HZ + (sample_rate_hz / 2U)) / sample_rate_hz;
    if (ticks_per_sample == 0U)
    {
        ticks_per_sample = 1U;
    }
    if (ticks_per_sample > 65536U)
    {
        ticks_per_sample = 65536U;
    }

    TIM3->PSC = BOARD_TIM_APB1_PSC_1MHZ;
    TIM3->ARR = ticks_per_sample - 1U;
    TIM3->CNT = 0U;
    TIM3->EGR = TIM_EGR_UG;
}

static void ekg_timer3_init(uint32_t sample_rate_hz)
{
    RCC->APB1ENR |= RCC_APB1ENR_TIM3EN;
    (void)RCC->APB1ENR;

    TIM3->CR1 = 0U;
    TIM3->CR2 = 0U;
    TIM3->SMCR = 0U;
    TIM3->DIER = TIM_DIER_UIE;

    ekg_timer3_set_rate(sample_rate_hz);

    TIM3->SR = 0U;
}

static void ekg_adc3_pf6_init(void)
{
    RCC->AHB1ENR |= RCC_AHB1ENR_GPIOFEN;
    (void)RCC->AHB1ENR;

    /* STM32F429ZI: PF6 is the analog input for ADC3 regular channel 4. */
    GPIOF->MODER &= ~(3UL << (EKG_ADC_GPIO_PIN * 2U));
    GPIOF->MODER |= (3UL << (EKG_ADC_GPIO_PIN * 2U));
    GPIOF->PUPDR &= ~(3UL << (EKG_ADC_GPIO_PIN * 2U));
    GPIOF->AFR[0] &= ~(0xFUL << (EKG_ADC_GPIO_PIN * 4U));
    GPIOF->OTYPER &= ~(1UL << EKG_ADC_GPIO_PIN);
    GPIOF->OSPEEDR &= ~(3UL << (EKG_ADC_GPIO_PIN * 2U));

    RCC->APB2ENR |= RCC_APB2ENR_ADC3EN;
    (void)RCC->APB2ENR;

    ADC3->CR2 &= ~ADC_CR2_ADON;

    /* ADC common prescaler PCLK2/8 for robust ADC clock margin. */
    ADC->CCR &= ~ADC_CCR_ADCPRE_Msk;
    ADC->CCR |= ADC_CCR_ADCPRE_0 | ADC_CCR_ADCPRE_1;

    ADC3->CR1 = ADC_CR1_EOCIE | ADC_CR1_OVRIE;
    ADC3->CR2 = 0U;
    ADC3->CR2 |= ADC_CR2_EOCS;

    /* Channel 4 sample time = 84 cycles. */
    ADC3->SMPR2 &= ~ADC_SMPR2_SMP4_Msk;
    ADC3->SMPR2 |= (EKG_ADC_SAMPLE_TIME_BITS << ADC_SMPR2_SMP4_Pos);

    /* Regular sequence length 1, first conversion = CH4 (PF6). */
    ADC3->SQR1 = 0U;
    ADC3->SQR2 = 0U;
    ADC3->SQR3 = EKG_ADC_CHANNEL;

    ADC3->SR = 0U;

    /* Enable ADC3. */
    ADC3->CR2 |= ADC_CR2_ADON;
    ekg_adc_wait_stable();
}

static void ekg_irq_init(void)
{
    NVIC_SetPriority(TIM3_IRQn, 3U);
    NVIC_ClearPendingIRQ(TIM3_IRQn);
    NVIC_EnableIRQ(TIM3_IRQn);

    NVIC_SetPriority(ADC_IRQn, 2U);
    NVIC_ClearPendingIRQ(ADC_IRQn);
    NVIC_EnableIRQ(ADC_IRQn);
}

static void ekg_update_coefficients(void)
{
    float fs = (float)g_cfg.sample_rate_hz;
    float dt;
    float tau;

    if (g_cfg.sample_rate_hz == 0U)
    {
        g_cfg.sample_rate_hz = EKG_DEFAULT_FS_HZ;
        fs = (float)g_cfg.sample_rate_hz;
    }

    if (g_cfg.highpass_hz < 0.0f)
    {
        g_cfg.highpass_hz = 0.0f;
    }
    if (g_cfg.lowpass_hz < 0.0f)
    {
        g_cfg.lowpass_hz = 0.0f;
    }

    g_hp_enabled = (g_cfg.highpass_hz > 0.0f) ? 1U : 0U;
    g_lp_enabled = (g_cfg.lowpass_hz > 0.0f) ? 1U : 0U;

    if (g_hp_enabled != 0U)
    {
        g_cfg.highpass_hz = clampf(g_cfg.highpass_hz, 0.05f, 5.0f);
    }
    if (g_lp_enabled != 0U)
    {
        g_cfg.lowpass_hz = clampf(g_cfg.lowpass_hz, 5.0f, 100.0f);
    }
    g_cfg.envelope_hz = clampf(g_cfg.envelope_hz, 1.0f, 30.0f);

    if ((g_hp_enabled != 0U) && (g_lp_enabled != 0U) &&
        (g_cfg.lowpass_hz <= g_cfg.highpass_hz))
    {
        g_cfg.lowpass_hz = g_cfg.highpass_hz + 2.0f;
    }

    g_cfg.refractory_s = clampf(g_cfg.refractory_s, 0.12f, 0.60f);
    g_cfg.min_rr_s = clampf(g_cfg.min_rr_s, 0.25f, 1.50f);
    g_cfg.max_rr_s = clampf(g_cfg.max_rr_s, 0.60f, 3.00f);

    if (g_cfg.max_rr_s < g_cfg.min_rr_s)
    {
        float tmp = g_cfg.max_rr_s;
        g_cfg.max_rr_s = g_cfg.min_rr_s;
        g_cfg.min_rr_s = tmp;
    }

    dt = 1.0f / fs;

    if (g_hp_enabled != 0U)
    {
        /* HP: y[n] = a * (y[n-1] + x[n] - x[n-1]) */
        tau = 1.0f / (PM4_TWO_PI_F * g_cfg.highpass_hz);
        g_alpha_hp = tau / (tau + dt);
    }
    else
    {
        g_alpha_hp = 0.0f;
    }

    if (g_lp_enabled != 0U)
    {
        /* LP: y[n] = y[n-1] + a * (x[n] - y[n-1]) */
        tau = 1.0f / (PM4_TWO_PI_F * g_cfg.lowpass_hz);
        g_alpha_lp = dt / (tau + dt);
    }
    else
    {
        g_alpha_lp = 0.0f;
    }

    /* Envelope LP (smoothed squared derivative). */
    tau = 1.0f / (PM4_TWO_PI_F * g_cfg.envelope_hz);
    g_alpha_env = dt / (tau + dt);

    g_refractory_samples = (uint32_t)(g_cfg.refractory_s * fs + 0.5f);
    g_min_rr_samples = (uint32_t)(g_cfg.min_rr_s * fs + 0.5f);
    g_max_rr_samples = (uint32_t)(g_cfg.max_rr_s * fs + 0.5f);
    g_warmup_samples = g_cfg.sample_rate_hz * EKG_WARMUP_SECONDS;

    if (g_refractory_samples == 0U)
    {
        g_refractory_samples = 1U;
    }
    if (g_min_rr_samples == 0U)
    {
        g_min_rr_samples = 1U;
    }
    if (g_max_rr_samples < g_min_rr_samples)
    {
        g_max_rr_samples = g_min_rr_samples;
    }

    if (g_hw_initialized != 0U)
    {
        ekg_timer3_set_rate(g_cfg.sample_rate_hz);
    }
}

void ekg_reset_processing(void)
{
    uint32_t primask;

    g_prev_x = 0.0f;
    g_hp_y = 0.0f;
    g_lp_y = 0.0f;
    g_prev_lp = 0.0f;
    g_env = 0.0f;

    g_noise_level = 1.0e-6f;
    g_signal_level = 5.0e-6f;
    g_threshold = 2.0e-6f;
    g_candidate_active = 0U;
    g_candidate_peak_env = 0.0f;
    g_candidate_peak_sample = 0U;

    g_sample_index = 0U;
    g_last_accepted_peak = 0U;

    g_latest_bpm = 0.0f;
    g_bpm_valid = 0U;

    primask = __get_PRIMASK();
    __disable_irq();
    g_processing_origin_sequence = g_irq_sample_sequence;
    if (primask == 0U)
    {
        __enable_irq();
    }
}

void ekg_set_config(const ekg_config_t *config)
{
    if (config != 0)
    {
        g_cfg = *config;
    }
    else
    {
        g_cfg = EKG_CONFIG_DEFAULT;
    }

    ekg_update_coefficients();
    ekg_reset_processing();
}

void ekg_start(void)
{
    uint32_t primask = __get_PRIMASK();

    if (g_hw_initialized == 0U)
    {
        return;
    }

    __disable_irq();
    g_irq_sample_ready = 0U;
    g_irq_queue_head = 0U;
    g_irq_queue_tail = 0U;
    g_irq_sample_sequence = 0U;
    g_processing_origin_sequence = 0U;
    g_sampling_enabled = 1U;
    if (primask == 0U)
    {
        __enable_irq();
    }

    ADC3->SR = 0U;
    TIM3->SR = 0U;
    TIM3->EGR = TIM_EGR_UG;
    TIM3->CR1 |= TIM_CR1_CEN;
}

void ekg_stop(void)
{
    TIM3->CR1 &= ~TIM_CR1_CEN;
    g_sampling_enabled = 0U;
}

void ekg_init(const ekg_config_t *config)
{
    if (g_hw_initialized == 0U)
    {
        ekg_adc3_pf6_init();
        ekg_timer3_init(EKG_DEFAULT_FS_HZ);
        ekg_irq_init();
        g_hw_initialized = 1U;
    }

    g_irq_overrun_count = 0U;
    g_irq_sample_ready = 0U;
    g_irq_queue_head = 0U;
    g_irq_queue_tail = 0U;
    g_irq_sample_sequence = 0U;
    g_processing_origin_sequence = 0U;

    ekg_set_config(config);
    ekg_start();
}

uint16_t ekg_read_raw_blocking(void)
{
    uint32_t timeout = EKG_ADC_TIMEOUT_LOOPS;

    ADC3->SR &= ~ADC_SR_EOC;
    ADC3->CR2 |= ADC_CR2_SWSTART;

    while ((ADC3->SR & ADC_SR_EOC) == 0U)
    {
        if (timeout == 0U)
        {
            return 0U;
        }
        timeout--;
    }

    return (uint16_t)(ADC3->DR & EKG_ADC_MAX_COUNT);
}

float ekg_raw_to_voltage(uint16_t raw)
{
    return ((float)raw * EKG_ADC_REF_VOLTAGE) / (float)EKG_ADC_MAX_COUNT;
}

void ekg_process_raw(uint16_t raw, ekg_output_t *out)
{
    ekg_process_raw_at_index(raw, g_sample_index, out);
    g_sample_index++;
}

static void ekg_process_raw_at_index(uint16_t raw, uint32_t sample_index,
                                     ekg_output_t *out)
{
    float x = ekg_raw_to_voltage(raw);
    float cleaned;
    float bp;
    float diff;
    float sq;
    float fs = (float)g_cfg.sample_rate_hz;
    uint8_t r_peak = 0U;
    uint32_t r_peak_sample_index = sample_index;

    if (g_hp_enabled != 0U)
    {
        g_hp_y = g_alpha_hp * (g_hp_y + x - g_prev_x);
        cleaned = g_hp_y;
    }
    else
    {
        cleaned = x - EKG_ADC_MID_VOLTAGE;
        g_hp_y = cleaned;
    }
    g_prev_x = x;

    if (g_lp_enabled != 0U)
    {
        g_lp_y = g_lp_y + g_alpha_lp * (cleaned - g_lp_y);
        bp = g_lp_y;
    }
    else
    {
        g_lp_y = cleaned;
        bp = cleaned;
    }

    /* QRS emphasis. */
    diff = bp - g_prev_lp;
    g_prev_lp = bp;
    sq = diff * diff;
    g_env = g_env + g_alpha_env * (sq - g_env);

    if (sample_index < g_warmup_samples)
    {
        /* Startup: learn baseline noise to stabilize threshold. */
        g_noise_level = 0.99f * g_noise_level + 0.01f * g_env;
        g_threshold = g_noise_level * 4.0f;
    }
    else
    {
        uint8_t above = (g_env > g_threshold) ? 1U : 0U;

        if (above != 0U)
        {
            if (g_candidate_active == 0U)
            {
                g_candidate_active = 1U;
                g_candidate_peak_env = g_env;
                g_candidate_peak_sample = sample_index;
            }
            else if (g_env > g_candidate_peak_env)
            {
                g_candidate_peak_env = g_env;
                g_candidate_peak_sample = sample_index;
            }
        }
        else
        {
            if (g_candidate_active != 0U)
            {
                uint32_t samples_since_peak = g_candidate_peak_sample - g_last_accepted_peak;

                g_candidate_active = 0U;

                if ((g_last_accepted_peak == 0U) || (samples_since_peak > g_refractory_samples))
                {
                    if ((g_last_accepted_peak == 0U) ||
                        ((samples_since_peak >= g_min_rr_samples) &&
                         (samples_since_peak <= g_max_rr_samples)))
                    {
                        r_peak = 1U;
                        r_peak_sample_index = g_candidate_peak_sample;

                        if (g_last_accepted_peak != 0U)
                        {
                            float inst_bpm = PM4_BPM_PER_HZ * fs / (float)samples_since_peak;

                            if (g_bpm_valid != 0U)
                            {
                                g_latest_bpm = 0.80f * g_latest_bpm + 0.20f * inst_bpm;
                            }
                            else
                            {
                                g_latest_bpm = inst_bpm;
                                g_bpm_valid = 1U;
                            }
                        }

                        g_last_accepted_peak = g_candidate_peak_sample;
                        g_signal_level = 0.875f * g_signal_level + 0.125f * g_candidate_peak_env;
                    }
                    else
                    {
                        g_noise_level = 0.875f * g_noise_level + 0.125f * g_candidate_peak_env;
                    }
                }
                else
                {
                    g_noise_level = 0.875f * g_noise_level + 0.125f * g_candidate_peak_env;
                }
            }
            else
            {
                g_noise_level = 0.95f * g_noise_level + 0.05f * g_env;
            }
        }

        g_threshold = g_noise_level + 0.25f * (g_signal_level - g_noise_level);
        if (g_threshold < EKG_MIN_THRESHOLD)
        {
            g_threshold = EKG_MIN_THRESHOLD;
        }
    }

    if (out != 0)
    {
        out->raw = raw;
        out->voltage = x;
        out->bandpassed = bp;
        out->envelope = g_env;
        out->threshold = g_threshold;
        out->r_peak = r_peak;
        out->sample_index = sample_index;
        out->r_peak_sample_index = r_peak_sample_index;
        out->bpm = (g_bpm_valid != 0U) ? g_latest_bpm : 0.0f;
        out->bpm_valid = g_bpm_valid;
    }
}

void ekg_read_and_process(ekg_output_t *out)
{
    uint16_t raw = ekg_read_raw_blocking();
    ekg_process_raw(raw, out);
}

uint8_t ekg_sample_ready(void)
{
    return g_irq_sample_ready;
}

static uint8_t ekg_get_next_irq_sample(uint16_t *raw, uint32_t *sequence)
{
    uint32_t primask;
    uint32_t tail;

    if ((raw == 0) || (sequence == 0))
    {
        return 0U;
    }

    primask = __get_PRIMASK();
    __disable_irq();

    if (g_irq_sample_ready == 0U)
    {
        if (primask == 0U)
        {
            __enable_irq();
        }
        return 0U;
    }

    tail = g_irq_queue_tail;
    *raw = g_irq_raw_queue[tail];
    *sequence = g_irq_sequence_queue[tail];

    tail = (tail + 1U) & EKG_SAMPLE_QUEUE_MASK;
    g_irq_queue_tail = tail;
    if (tail == g_irq_queue_head)
    {
        g_irq_sample_ready = 0U;
    }

    if (primask == 0U)
    {
        __enable_irq();
    }

    return 1U;
}

uint8_t ekg_get_latest_raw_sample(uint16_t *raw)
{
    uint32_t sequence;

    return ekg_get_next_irq_sample(raw, &sequence);
}

uint8_t ekg_process_if_ready(ekg_output_t *out)
{
    uint16_t raw;
    uint32_t sequence;
    uint32_t sample_index;

    if (ekg_get_next_irq_sample(&raw, &sequence) == 0U)
    {
        return 0U;
    }

    if (sequence >= g_processing_origin_sequence)
    {
        sample_index = sequence - g_processing_origin_sequence;
    }
    else
    {
        sample_index = 0U;
    }

    ekg_process_raw_at_index(raw, sample_index, out);
    g_sample_index = sample_index + 1U;

    return 1U;
}

void ekg_display_history_clear(float *signal_history,
                               uint8_t *peak_history,
                               uint32_t *history_fill_samples)
{
    if ((signal_history == 0) || (peak_history == 0) || (history_fill_samples == 0))
    {
        return;
    }

    for (uint32_t i = 0; i < EKG_DISPLAY_HISTORY_SAMPLES; i++)
    {
        signal_history[i] = 0.0f;
        peak_history[i] = 0U;
    }

    *history_fill_samples = 0U;
}

uint8_t ekg_display_history_append(float *signal_history,
                                   uint8_t *peak_history,
                                   uint32_t *history_fill_samples,
                                   const ekg_output_t *sample)
{
    if ((signal_history == 0) || (peak_history == 0) ||
            (history_fill_samples == 0) || (sample == 0))
    {
        return 0U;
    }

    for (uint32_t i = 0; i < (EKG_DISPLAY_HISTORY_SAMPLES - 1U); i++)
    {
        signal_history[i] = signal_history[i + 1U];
        peak_history[i] = peak_history[i + 1U];
    }

    signal_history[EKG_DISPLAY_HISTORY_SAMPLES - 1U] = sample->bandpassed;
    peak_history[EKG_DISPLAY_HISTORY_SAMPLES - 1U] = 0U;

    if (*history_fill_samples < EKG_DISPLAY_HISTORY_SAMPLES)
    {
        (*history_fill_samples)++;
    }

    if ((sample->r_peak != 0U) && (sample->sample_index >= sample->r_peak_sample_index))
    {
        uint32_t peak_age = sample->sample_index - sample->r_peak_sample_index;

        if (peak_age < EKG_DISPLAY_HISTORY_SAMPLES)
        {
            peak_history[EKG_DISPLAY_HISTORY_SAMPLES - 1U - peak_age] = 1U;
        }
    }

    return 1U;
}

void ekg_get_display_scale(const float *samples,
                           uint32_t start_index,
                           uint32_t count,
                           float min_span,
                           float headroom_ratio,
                           float *min_value,
                           float *max_value)
{
    float min_sample;
    float max_sample;
    float span;
    float center;
    float headroom;

    if ((samples == 0) || (min_value == 0) || (max_value == 0) || (count == 0U))
    {
        return;
    }

    if (start_index >= EKG_DISPLAY_HISTORY_SAMPLES)
    {
        return;
    }

    if (count > (EKG_DISPLAY_HISTORY_SAMPLES - start_index))
    {
        count = EKG_DISPLAY_HISTORY_SAMPLES - start_index;
    }

    if (min_span < 0.0f)
    {
        min_span = 0.0f;
    }
    if (headroom_ratio < 0.0f)
    {
        headroom_ratio = 0.0f;
    }

    min_sample = samples[start_index];
    max_sample = samples[start_index];

    for (uint32_t i = start_index; i < (start_index + count); i++)
    {
        if (samples[i] < min_sample)
        {
            min_sample = samples[i];
        }
        if (samples[i] > max_sample)
        {
            max_sample = samples[i];
        }
    }

    span = max_sample - min_sample;
    if (span < min_span)
    {
        span = min_span;
    }

    center = 0.5f * (max_sample + min_sample);
    headroom = span * headroom_ratio;

    *min_value = center - (0.5f * span) - headroom;
    *max_value = center + (0.5f * span) + headroom;
}

uint32_t ekg_get_overrun_count(void)
{
    return g_irq_overrun_count;
}

float ekg_get_latest_bpm(void)
{
    if (g_bpm_valid != 0U)
    {
        return g_latest_bpm;
    }
    return 0.0f;
}

uint8_t ekg_has_valid_bpm(void)
{
    return g_bpm_valid;
}

void TIM3_IRQHandler(void)
{
    if ((TIM3->SR & TIM_SR_UIF) != 0U)
    {
        TIM3->SR &= ~TIM_SR_UIF;

        if (g_sampling_enabled != 0U)
        {
            ADC3->CR2 |= ADC_CR2_SWSTART;
        }
    }
}

void ADC_IRQHandler(void)
{
    uint32_t sr = ADC3->SR;

    if ((sr & ADC_SR_EOC) != 0U)
    {
        uint16_t sample = (uint16_t)(ADC3->DR & EKG_ADC_MAX_COUNT);
        uint32_t head = g_irq_queue_head;
        uint32_t next_head = (head + 1U) & EKG_SAMPLE_QUEUE_MASK;

        if (next_head == g_irq_queue_tail)
        {
            g_irq_queue_tail = (g_irq_queue_tail + 1U) & EKG_SAMPLE_QUEUE_MASK;
            g_irq_overrun_count++;
        }

        g_irq_raw_queue[head] = sample;
        g_irq_sequence_queue[head] = g_irq_sample_sequence;
        g_irq_sample_sequence++;
        g_irq_queue_head = next_head;
        g_irq_sample_ready = 1U;
    }

    if ((sr & ADC_SR_OVR) != 0U)
    {
        (void)ADC3->DR;
        ADC3->SR &= ~ADC_SR_OVR;
        g_irq_overrun_count++;
    }
}
