Tommy270502/PM4/4_Firmware/Firmware/Core/Src/calc.c

/**
 * @file calc.c
 * @brief Calculate frequency spectrum
 * @author Hanspeter Hochreutener, hhrt@zhaw.ch
 * @author Patrick Rennhard, renn@zhaw.ch
 * @date 2025-09-03
 */

/******************************************************************************
 * Includes
 *****************************************************************************/
#include <stdio.h>
#include "stm32f429i_discovery.h"

#include "radar.h"
#include "calc.h"
#include "main.h"

/******************************************************************************
 * Defines
 *****************************************************************************/

const float32_t HANN_WINDOW_1024[1024] = { 0.00000000f, 0.00000943f,
		0.00003772f, 0.00008487f, 0.00015089f, 0.00023575f, 0.00033947f,
		0.00046204f, 0.00060345f, 0.00076370f, 0.00094278f, 0.00114069f,
		0.00135742f, 0.00159296f, 0.00184730f, 0.00212043f, 0.00241234f,
		0.00272303f, 0.00305247f, 0.00340066f, 0.00376758f, 0.00415322f,
		0.00455757f, 0.00498060f, 0.00542231f, 0.00588268f, 0.00636168f,
		0.00685931f, 0.00737554f, 0.00791036f, 0.00846373f, 0.00903565f,
		0.00962609f, 0.01023503f, 0.01086244f, 0.01150831f, 0.01217260f,
		0.01285530f, 0.01355637f, 0.01427579f, 0.01501354f, 0.01576958f,
		0.01654388f, 0.01733643f, 0.01814718f, 0.01897611f, 0.01982318f,
		0.02068837f, 0.02157164f, 0.02247296f, 0.02339229f, 0.02432960f,
		0.02528485f, 0.02625801f, 0.02724904f, 0.02825791f, 0.02928457f,
		0.03032899f, 0.03139113f, 0.03247094f, 0.03356839f, 0.03468344f,
		0.03581603f, 0.03696614f, 0.03813372f, 0.03931872f, 0.04052109f,
		0.04174080f, 0.04297780f, 0.04423204f, 0.04550347f, 0.04679204f,
		0.04809772f, 0.04942044f, 0.05076015f, 0.05211681f, 0.05349037f,
		0.05488077f, 0.05628797f, 0.05771190f, 0.05915252f, 0.06060976f,
		0.06208358f, 0.06357392f, 0.06508073f, 0.06660394f, 0.06814350f,
		0.06969935f, 0.07127143f, 0.07285969f, 0.07446406f, 0.07608448f,
		0.07772089f, 0.07937323f, 0.08104144f, 0.08272546f, 0.08442521f,
		0.08614064f, 0.08787169f, 0.08961828f, 0.09138035f, 0.09315784f,
		0.09495067f, 0.09675878f, 0.09858211f, 0.10042057f, 0.10227412f,
		0.10414266f, 0.10602614f, 0.10792448f, 0.10983760f, 0.11176545f,
		0.11370794f, 0.11566501f, 0.11763657f, 0.11962256f, 0.12162290f,
		0.12363751f, 0.12566631f, 0.12770924f, 0.12976621f, 0.13183715f,
		0.13392198f, 0.13602061f, 0.13813298f, 0.14025900f, 0.14239859f,
		0.14455166f, 0.14671815f, 0.14889796f, 0.15109102f, 0.15329724f,
		0.15551654f, 0.15774883f, 0.15999404f, 0.16225207f, 0.16452284f,
		0.16680627f, 0.16910226f, 0.17141074f, 0.17373161f, 0.17606480f,
		0.17841020f, 0.18076773f, 0.18313730f, 0.18551883f, 0.18791222f,
		0.19031739f, 0.19273423f, 0.19516267f, 0.19760261f, 0.20005395f,
		0.20251661f, 0.20499049f, 0.20747550f, 0.20997155f, 0.21247853f,
		0.21499636f, 0.21752494f, 0.22006418f, 0.22261398f, 0.22517424f,
		0.22774487f, 0.23032577f, 0.23291685f, 0.23551799f, 0.23812912f,
		0.24075012f, 0.24338091f, 0.24602137f, 0.24867142f, 0.25133094f,
		0.25399985f, 0.25667803f, 0.25936540f, 0.26206184f, 0.26476726f,
		0.26748155f, 0.27020461f, 0.27293635f, 0.27567664f, 0.27842540f,
		0.28118252f, 0.28394789f, 0.28672142f, 0.28950298f, 0.29229249f,
		0.29508984f, 0.29789491f, 0.30070761f, 0.30352783f, 0.30635545f,
		0.30919039f, 0.31203252f, 0.31488174f, 0.31773794f, 0.32060102f,
		0.32347087f, 0.32634737f, 0.32923043f, 0.33211993f, 0.33501576f,
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

/******************************************************************************
 * Variables
 *****************************************************************************/

static float32_t fft_abs_scale = 1;
static arm_rfft_fast_instance_f32 fft_instance;	///< Twiddle factors, etc. for the fft

/******************************************************************************
 * Functions
 *****************************************************************************/

HAL_StatusTypeDef calc_init(void) {
	HAL_StatusTypeDef ret_val;
	arm_status ret;

	ret = arm_rfft_fast_init_f32(&fft_instance, RADAR_CHANNEL_SAMPLES);

	fft_abs_scale = 1 / ((float32_t) RADAR_CHANNEL_SAMPLES); // divide by Nfft
	fft_abs_scale = fft_abs_scale * RADAR_ADC_REF_VOLTAGE / (1 << (RADAR_ADC_RES)); // normalise samples to Volt

	ret_val = (ret == ARM_MATH_SUCCESS) ? HAL_OK : HAL_ERROR;

	return ret_val;
}

HAL_StatusTypeDef calc_freq(const float32_t in[], float32_t out[]) {
	static float buffer1[RADAR_CHANNEL_SAMPLES];	// Temporary buffer 1
	static float buffer2[RADAR_CHANNEL_SAMPLES];	// Temporary buffer 2

	// Apply window against leakage
	arm_mult_f32((float32_t*) in, (float32_t*) HANN_WINDOW_1024, buffer1, RADAR_CHANNEL_SAMPLES);

	arm_rfft_fast_f32(&fft_instance, buffer1, buffer2, 0);

	arm_cmplx_mag_f32(buffer2, buffer1, RADAR_CHANNEL_SAMPLES / 2); // output size only RADAR_CHANNEL_SAMPLES/2

	arm_scale_f32(buffer1, fft_abs_scale, out, RADAR_CHANNEL_SAMPLES / 2);

	return HAL_OK;
}
