Tommy270502/PM4/4_Firmware/Firmware/Core/Inc/main.h

/** ***************************************************************************
 * @file
 * @brief See main.c
 *
 *****************************************************************************/

#ifndef MAIN_H_
#define MAIN_H_

/******************************************************************************
 * Includes
 *****************************************************************************/
#include "board_config.h"

/******************************************************************************
 * Defines
 *****************************************************************************/
/******************************************************************************
 * Functions
 *****************************************************************************/

#endif
