Tommy270502/PM4/4_Firmware/Firmware/Core/Inc/openlog_uart.h

/** ***************************************************************************
 * @file
 * @brief TX-only OpenLog logger over USART6 on PG14.
 *
 * Provides best-effort CSV logging of radar HR summary data to an OpenLog
 * module connected to PG14 (USART6 TX, AF8) at 9600 baud. Each START session
 * creates a new log file using OpenLog command mode.
 *
 * Prefix OPENLOG
 *
 *****************************************************************************/

#ifndef OPENLOG_UART_H_
#define OPENLOG_UART_H_

/******************************************************************************
 * Includes
 *****************************************************************************/
#include <stdbool.h>
#include <stdint.h>
#include "radar_heartrate.h"

/******************************************************************************
 * Defines
 *****************************************************************************/
/** TX timeout for a single HAL_UART_Transmit call [ms]. */
#define OPENLOG_TX_TIMEOUT_MS   200U

/** Baud rate for OpenLog default serial interface. */
#define OPENLOG_BAUD_RATE       9600U

/******************************************************************************
 * Functions
 *****************************************************************************/

/**
 * @brief  One-time initialisation of USART6 TX on PG14 at 9600 baud.
 *
 * Enables GPIOG and USART6 clocks, configures PG14 for AF8 (USART6_TX),
 * and calls HAL_UART_Init in TX-only mode.  Logging starts in the OFF state.
 */
void openlog_init(void);

/**
 * @brief  Start a new logging session.
 *
 * Enters command mode, appends to a new per-session file (e.g. LOG0001.CSV),
 * and emits the CSV header row before enabling logging.
 *
 * @return true if logging transitioned to ON.
 */
bool openlog_start_session(void);

/**
 * @brief  Stop the current logging session.
 *
 * Enters command mode and issues a sync command, then disables logging.
 *
 * @return true if logging transitioned to OFF.
 */
bool openlog_stop_session(void);

/**
 * @brief  Query whether logging is currently enabled.
 * @return true if logging is ON.
 */
bool openlog_is_enabled(void);

/**
 * @brief  Return the cumulative count of TX drops / errors.
 *
 * A drop occurs when HAL_UART_Transmit returns busy, error, or timeout.
 * The counter is never reset; it only grows.
 *
 * @return Number of dropped transmissions since init.
 */
uint32_t openlog_get_drop_count(void);

/**
 * @brief  Write one CSV data row if logging is enabled.
 *
 * Format:
 * tick_ms,bpm,valid,state,phase_flags,clip_count,low_signal_count,
 * mean_radius_counts,radar_overruns,dma_errors\r\n
 *
 * Best-effort: if the UART is busy or fails, the row is silently dropped
 * and the internal drop counter is incremented.
 *
 * @param[in] tick_ms   Timestamp (e.g. HAL_GetTick()).
 * @param[in] bpm       Heart-rate estimate.
 * @param[in] valid     true if HR is valid (LOCKED + accepted).
 * @param[in] state     Current state-machine state.
 * @param[in] phase_quality Latest radar phase/displacement quality snapshot.
 * @param[in] radar_overruns Number of unconsumed DMA chunks overwritten.
 * @param[in] dma_errors Number of DMA error flags observed.
 */
void openlog_write_row(uint32_t tick_ms,
                       float bpm,
                       bool valid,
                       radar_hr_sm_state_t state,
                       const radar_phase_quality_t *phase_quality,
                       uint32_t radar_overruns,
                       uint32_t dma_errors);

#endif /* OPENLOG_UART_H_ */
