Tommy270502/PM4/4_Firmware/Firmware/Core/Inc/dac_output.h

/** ***************************************************************************
 * @file
 * @brief DAC output control on PA5 (DAC channel 2)
 *
 *****************************************************************************/

#ifndef DAC_OUTPUT_H_
#define DAC_OUTPUT_H_

/******************************************************************************
 * Includes
 *****************************************************************************/
#include <stdint.h>
#include "board_config.h"

/******************************************************************************
 * Defines
 *****************************************************************************/
/******************************************************************************
 * Functions
 *****************************************************************************/
void dac_output_init(void);
void dac_output_set_voltage(float voltage);
float dac_output_get_voltage(void);
uint16_t dac_output_get_code(void);

#endif
