Tommy270502/PM4/4_Firmware/Firmware/Core/Inc/math_constants.h

/** ***************************************************************************
 * @file
 * @brief Shared math and numeric helper constants.
 *****************************************************************************/

#ifndef MATH_CONSTANTS_H_
#define MATH_CONSTANTS_H_

#define PM4_PI_F                 3.14159265358979323846f
#define PM4_TWO_PI_F             (2.0f * PM4_PI_F)
#define PM4_BPM_PER_HZ           60.0f
#define PM4_NUMERIC_EPSILON_F    1.0e-12f

#endif
