Tommy270502/PM4/(commit log)

2026-02-19 added project files
    [8_Extension_Connectors.xlsx, 9_Parts order form.xls, Checklist_Marks_FS2026.xlsx]
2026-02-19 Track mp4 files with Git LFS
2026-02-19 hardware template unzipped
    [HW_template.kicad_pcb, HW_template.kicad_sch, amplifier_filter_1channel.kicad_sch, amplifier_filter_2channels.kicad_sch, miscellaneous.kicad_sch, simulation.kicad_sch]
2026-02-26 added cheaper analog frontend circuitry simulation
2026-02-26 first analog circuitry implemented in kicad
    [HW_template.kicad_sch, amplifier_filter_1channel.kicad_sch, analog.kicad_sch, dac.kicad_sch, miscellaneous.kicad_sch]
2026-03-05 added amp filter v5
    [amplifier_filter_1channel.kicad_sch, analog.kicad_sch, dac.kicad_sch]
2026-03-08 finalize main feature
    [HW_template.kicad_sch, amplifier_filter_1channel.kicad_sch, analog.kicad_sch, dac.kicad_sch, miscellaneous.kicad_sch]
2026-03-11 layout template
    [HW_template.kicad_pcb, HW_template.kicad_sch, amplifier_filter_1channel.kicad_sch, analog.kicad_sch, dac.kicad_sch, miscellaneous.kicad_sch, power.kicad_sch]
2026-03-11 added AD8232
    [9_Parts order form.xls, AD8232.step, HW_template.kicad_pcb, analog.kicad_sch]
2026-03-11 added ecg schematic and part list to order
    [9_Parts order form.xls, ECG.kicad_sch, HW_template.kicad_sch]
2026-03-12 updated parts order excel version
    [9_Parts order form.xls, 9_Parts order form.xlsx]
2026-03-12 added datasheet and started layout
    [ECG.kicad_sch, HW_template.kicad_pcb]
2026-03-12 parts order updated with cheaper cables for ECG
    [9_Parts order form.xlsx]
2026-03-12 disabled excel automatic backup
    [9_Parts order form.xlsx]
2026-03-12 updated layout
    [ECG.kicad_sch, HW_template.kicad_pcb]
2026-03-12 standard component list
    [10_ETPM4- Standard_Components.xlsx]
2026-03-18 pcb schematics finished + layout
    [ECG.kicad_sch, HW_template.kicad_pcb, HW_template.kicad_sch, miscellaneous.kicad_sch]
2026-03-18 layout finished + component libs updated
    [AD8232.step, ECG.kicad_sch, HW_template.kicad_pcb, SJ-3523-SMT-TR--3DModel-STEP-1.STEP]
2026-03-19 updated materials on fft implementation
2026-03-19 pcb - minor naming improvements
    [HW_template.kicad_pcb, HW_template.kicad_sch]
2026-03-19 fixed footprints
    [HW_template.kicad_pcb, amplifier_filter_1channel.kicad_sch, analog.kicad_sch, dac.kicad_sch, power.kicad_sch]
2026-03-19 designed pcb
    [HW_template.kicad_pcb]
2026-03-19 finalized pcb
    [HW_template.kicad_pcb, miscellaneous.kicad_sch]
2026-03-19 component order form updated
    [9_Parts order form.xlsx]
2026-03-19 minor pcb improvements + bom
    [HW_template.kicad_pcb, HW_template.kicad_sch, analog.kicad_sch]
2026-03-19 pcb minor improvements
    [ECG.kicad_sch, HW_template.kicad_sch, miscellaneous.kicad_sch, power.kicad_sch]
2026-03-19 added amplification to VCO
    [HW_template.kicad_pcb, dac.kicad_sch]
2026-03-19 component order form (capacitors) + bom
    [9_Parts order form.xlsx]
2026-03-19 finalized component order form
    [9_Parts order form.xlsx]
2026-03-19 order finalization
    [9_Parts order form.xlsx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]
2026-03-26 fixed fft scaling and time signal scaling, also did 50% overlap on samples rolling 512 sample window but all 2.56s 256 new samples
    [display.c, main.c, radar.c, radar.h]
2026-04-02 simulation updated to match PCB
2026-04-02 vco error fixed: replaced 11k with 1k
    [dac.kicad_sch]
2026-04-09 pcb fix
    [amplifier_filter_1channel.kicad_sch]
2026-04-22 updated marks excel
    [Checklist_Marks_FS2026.xlsx]
2026-04-22 pcb 3d model
    [HW_template.step]
2026-04-22 doing mechanical work for the casing
    [casing.FCStd, pcb.FCStd]
2026-04-22 got base measurements from pcb but missing devboard headerheight
    [casing.FCStd, pcb.FCStd]
2026-04-23 part order list
    [9.1_Parts order form.xlsx, 9.2_Parts order form.xlsx]
2026-04-27 casing skeleton
    [casing.FCStd, pcb.FCStd]
2026-04-27 made base design
    [casing.FCStd]
2026-04-27 made base better looking IMO and added a hole for feedthrough of usb cable
    [casing.FCStd]
2026-04-27 minor looks
    [casing.FCStd]
2026-04-27 lowered center of mass
    [casing-Body.3mf, casing-Body.step, casing-Body.stl, casing.FCStd]
2026-05-08 copied template for powerpoint
    [casing.FCStd]
2026-05-11 stimmgabel V2
    [casing-BodyV2.step, casing.FCStd]
2026-05-11 removed digital filter for ekg as the analog frontend already does this
2026-05-17 rotated display
    [casing-BodyV2.stl]
2026-05-17 Refactor radar acquisition and add displacement-based HR input
    - shorten radar DMA ISR to only publish completed buffer metadata
    - move I/Q unpacking and rolling-window updates to foreground code
    - add radar DMA sequence, overrun, and error counters
    - add I/Q phase unwrap and displacement conversion path
    - add phase quality flags for clipping and low signal conditions
    - feed radar HR estimator from displacement FFT instead of I/Q magnitude FFT
    - keep existing I/Q FFT display path intact
    - add radar signal quality status to display and OpenLog CSV output
    - reduce radar HR stack usage by moving scratch buffers into persistent state
    - clamp radar HR candidate count to the supported range
    [display.c, display.h, fft.c, fft.h, main.c, openlog_uart.c, openlog_uart.h]
2026-05-21 data logger 3d files
    [ATmega.SLDPRT, Fusion001.sldprt, OpenLog - basic.SLDASM, OpenLog - basic.SLDPRT, OpenLog - basic.STEP, OpenLog - pins down.SLDASM, OpenLog - pins down.SLDPRT, OpenLog - pins down.STEP]
2026-05-21 inserted data logger 3d model in hw
    [HW_template.kicad_pcb]
2026-06-02 marks excel updated
    [Checklist_Marks_FS2026.xlsx]
2026-06-22 added measurment logging data
    [log.csv]
2026-06-22 added plot for log data
    [log_with_plot.xlsx]
