Tommy270502/PM4/6_Video Presentation/img/20260521_103318.jpg

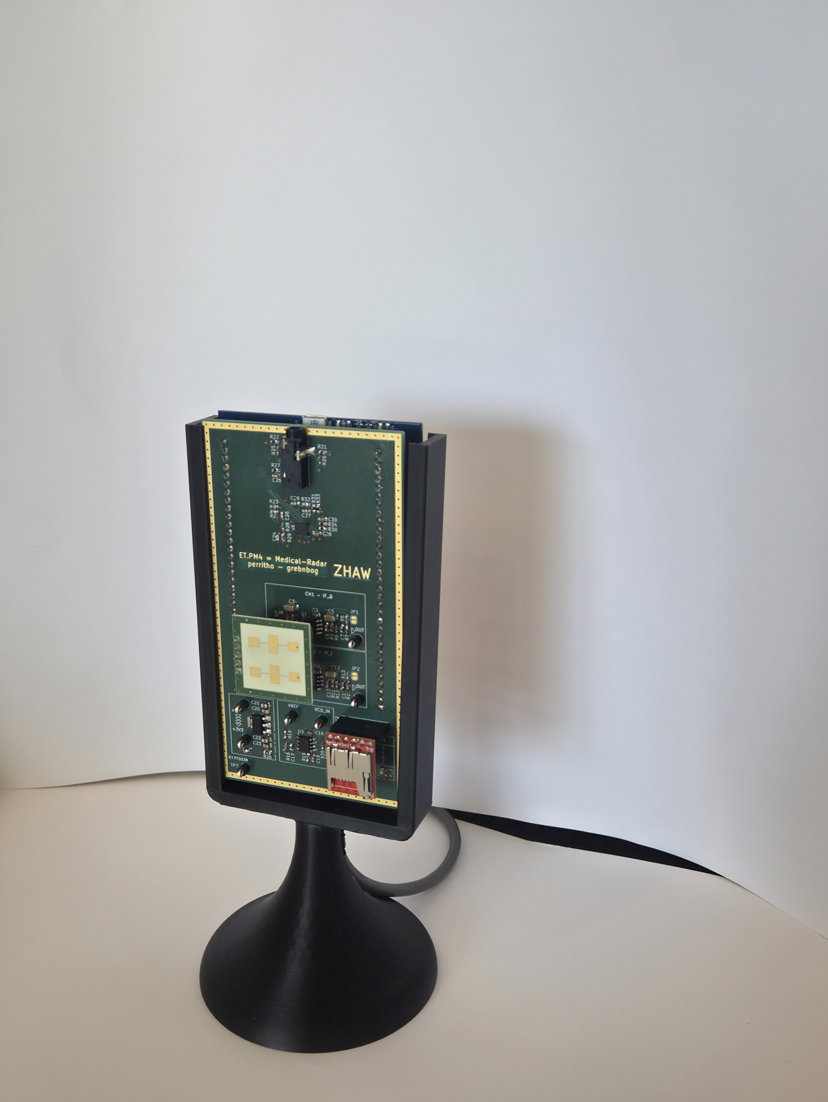
6_Video Presentation/img/20260521_103318.jpg
