Tommy270502/PM4/6_Video Presentation/img/20260520_211417.jpg

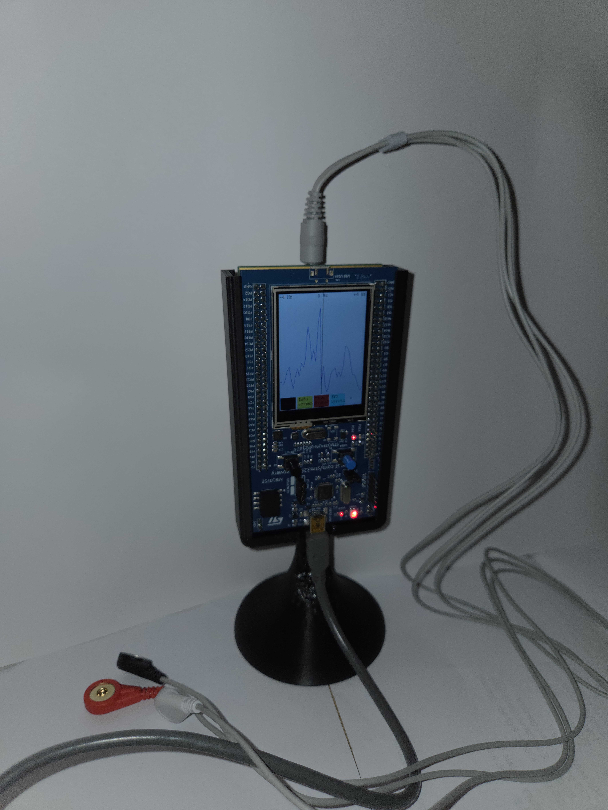
6_Video Presentation/img/20260520_211417.jpg
